th3fr33man/jendrix/Ressources/ShémasTableau/IMG_20121205_175228.jpg

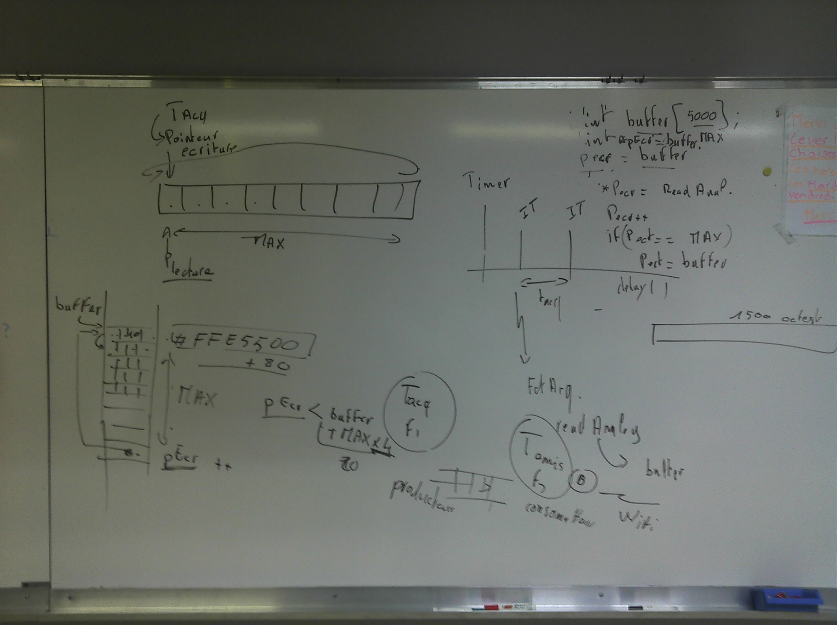
Ressources/ShémasTableau/IMG_20121205_175228.jpg
