th3fr33man/jendrix/README.md

# Readme du projet Jendrix.
# Par Romain "th3fr33man" et Florian  "floub".
# Projet à base de carte Arduino Due et application Android.
