th3fr33man/jendrix/Rapports/dossier_flo.odt

CECI EST UN TITRE

+logo ou schéma

# IDEE / PRESENTATION

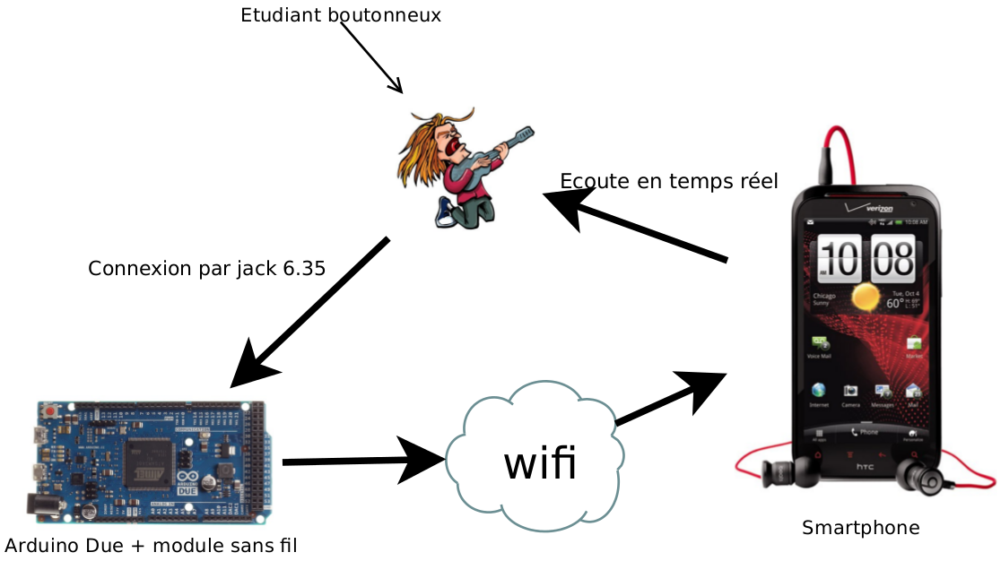
[picture p4: figure]

Illustration 1: schéma conceptuel du système Jendrix

Le principe !

Le principe du système Jendrix est simple : permettre à un musicien pour un prix minimum et un minimum d'installation d'écouter sur le casque de son Smartphone , par l’intermédiaire d'une application téléchargée, le son produit par sa guitare électrique.

Pour ce faire nous nous proposons de développer un petit « device » compact, fixé sur la guitare au moyen d'un clip sur la bandoulière par exemple et raccordé à la prise jack de la guitare, l'énergie électrique du système étant fournie par une batterie ou des piles rechargeables embarquées.

Enfin, Le smartphone et le petit device doivent pouvoir communiquer l'un avec l'autre par l'intermédaire d'une connexion WIFI établie automatiquement au démarrage de l'application Smartphone et basée d'un coté sur un module WIFI embarqué par le device et de l'autre le module WIFI du SMARTPHONE.

La cible commerciale ?

Un étudiant (boutonneux ou non), à petit budget, doit pourvoir jouer et enregistrer « Foxy Lady » en silence, le téléphone dans la poche, le casque sur les oreilles tout en sautant partout dans ses 9m² .

JENDRIX : LE « AIR GUITARE » REINVENTE

# CAHIER DES CHARGES

## Analyse du besoin

Le système doit offrir certaines fonctionnalités à l'utilisateur, comme capter le son d'un instrument, le restituer, l'enregistrer,...etc. Ceci est résumé dans les diagrammes UML suivant.

### Diagramme de déploiement

Le diagramme de déploiement suivant représente les différents éléments du système et les types de connexion entre eux.

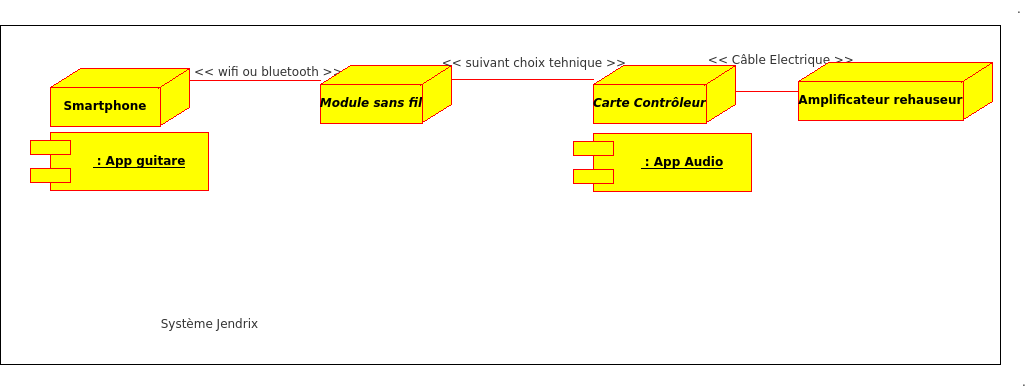
[picture p5: figure]

Illustration 2: Diagramme de déploiement du système Jendrix

### Diagramme de cas d'utilisation.

Les diagrammes suivant résument les fonctions principales que le système doit offrir à l'utilisateur.

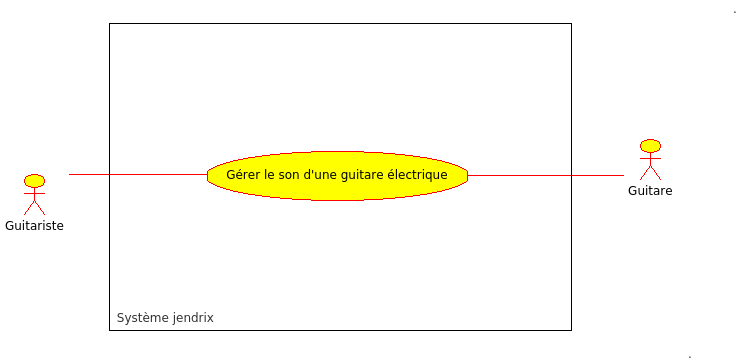
[picture p6: figure]

Illustration 3: Système général

Le module audio doit être capable de capturer, le signal electrique audio émis par la guitare, de le transmettre via une liaison sans-fil.

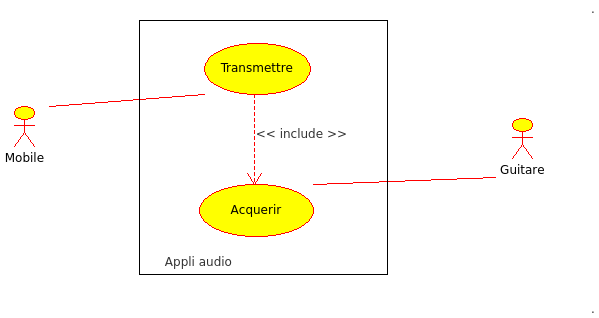
[picture p7: figure]

Illustration 4: Côté capture du son

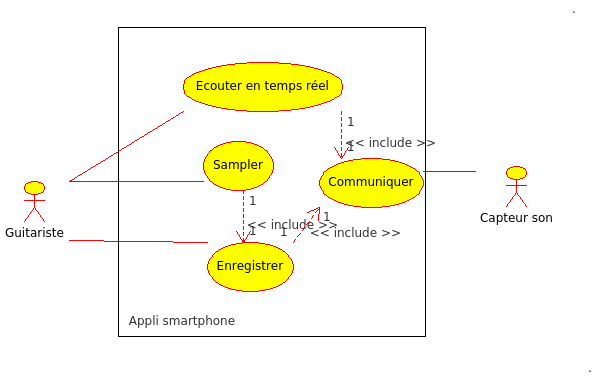
[picture p8: figure]

Illustration 5: Côté restitution du son

L'application sur smartphone, doit elle être capable d'une part de récupérer les données qui sont envoyées par le module audio en sans-fil, et d'autre part doit permettre au guitariste d'écouter le son de son instrument en temps réel(pas de latence).

D'autres fonctions secondaires doivent permettre au musicien de s'enregistrer et même de créer des boucles à diffuser tout en continuant de jouer.

### Diagrammes de séquences.

Les diagrammes suivant résument le fonctionnement des différentes parties du système.

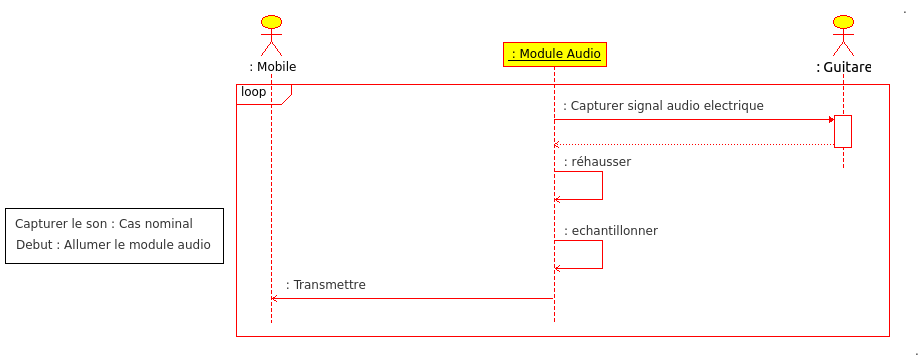
[picture p9: figure]

Illustration 6: Module audio raccordé à la guitare

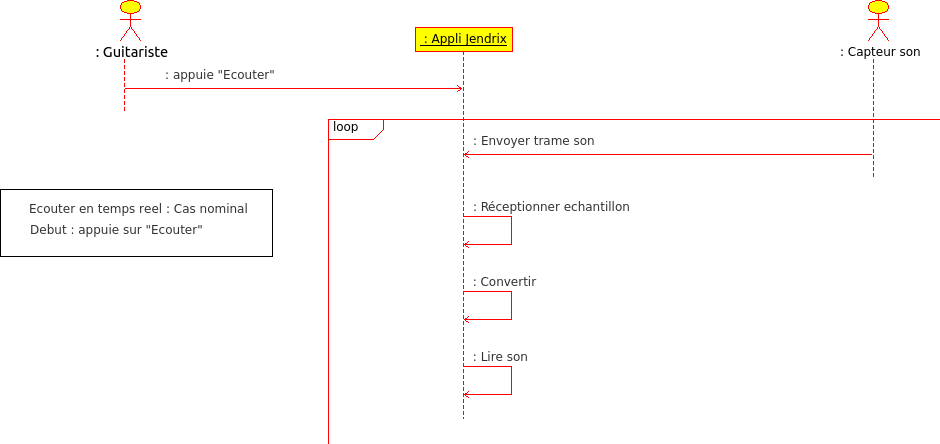
[picture p10: figure]

Illustration 7: Application sur smartphone

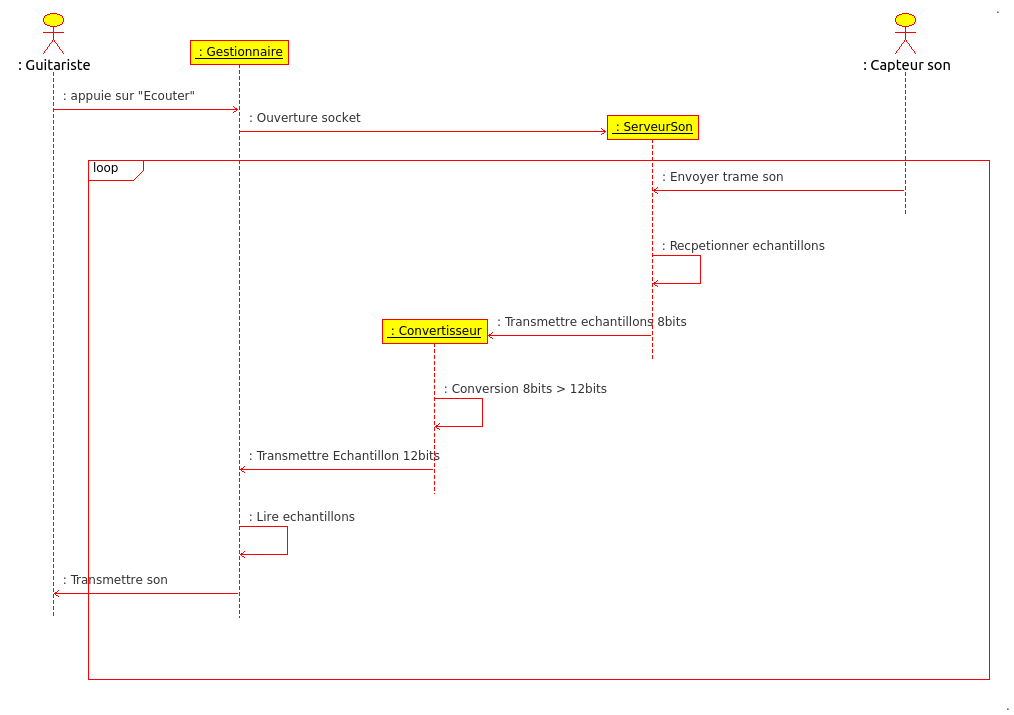
[picture p11: figure]

Illustration 8: Zoom sur l'application smartphone

## CONTRAINTES INITIALES et CHOIX TECHNIQUES

### Diffusion du son

Pour l'application de diffusion du son sur smartphone, les 2 choix principaux étant Android et IOS, voici un petit résumé des caractéristiques des 2 plate formes.

| Caractéristiques

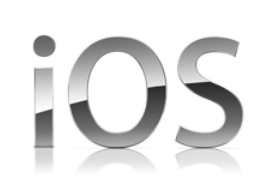
[picture p12: figure]

| - Langage : objective C, dérivé de C et C++. - Compte développeur 100$. - Outil de développement riche et documentation fourni. - Programmation exclusivement sur Mac - Contact des ingénieurs Apple possible avec l'achat de tickets. - Environnement fermé. - Délai de publication sur l'Apple Store de 10 jours. - Matériel limité à l'Iphone/Ipad.

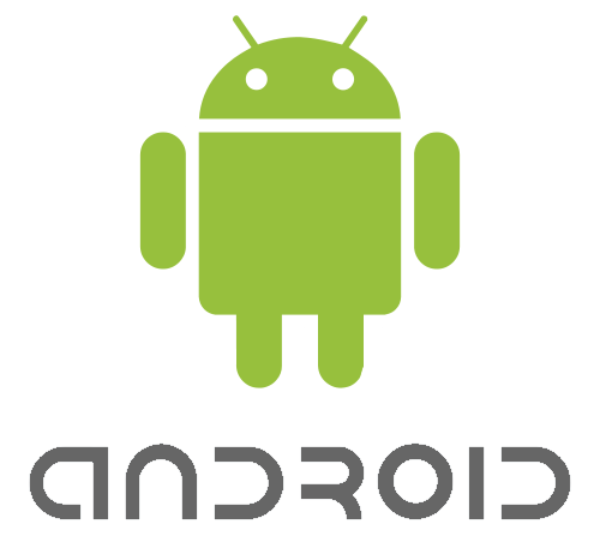
[picture p13: figure]

| - Langage:Java + Xml. - Compte développeur 25$. - Outil de développement plus brouillon. - Programmation sur toutes plate formes - Communauté active. - Environnement ouvert. -Délai de publication sur le play Store de 1 jour. - Multi plate formes.

→ Notre choix s'est tourné vers Android pour son environnement ouvert et sa possibilité de programmation sur diverses OS (Windows, Linux ou Mac).

Plusieurs type de contraintes sont à prendre en compte dans le développement du projet :

### Les instruments de musique

Le choix à été fait de développer l'ensemble du système sur la base des caractéristiques de la guitare « marque de la guitare «

TODO : A FINIR

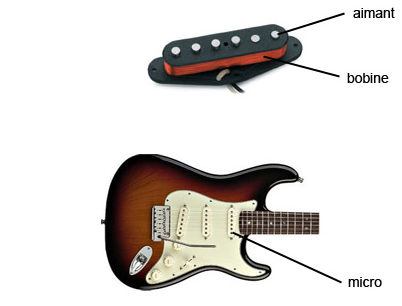
[picture p14: figure]

### Les micros de la guitare

Cette guitare est équipée de micros «classiques» destinés à transformer les vibrations de cordes induites par le jeu du musicien en un signal électrique. Pour ce faire, la guitare possède des micros, 1 par cordes, micros constitués d'un aimant entouré d'une bobine, les deux éléments étant fixes.

La génération d'un signal électrique se fait en conséquence par le déplacement des cordes ( qui doivent être métalliques) placées à proximité d'une extrémité de l'aimant du micro. Le champ magnétique de l'aimant central aimante partiellement la corde et lors du déplacement de la corde devant l'aimant, le champ magnétique de ce dernier varie. Si on considère le micro entier (ensemble aimant/bobine), déplacer la corde devant le micro revient à déplacer l'aimant devant la bobine ce qui génère un courant électrique dans la bobine en application du principe de l'induction magnétique.

Les micros étant placés en parallèle l'ensemble des vibrations de cordes sont additionnés et reflètent les vibrations des cordes.

→ En conséquence, il est nécessaire de dimensionner le système Jendrix en fonction des caractéristiques des micros de l'instrument.

### Les caractéristiques du signal électrique obtenu :

L'amplitude du signal électrique généré est directement proportionnelle à l'amplitude du déplacement des cordes et varie en permanence dans le temps.

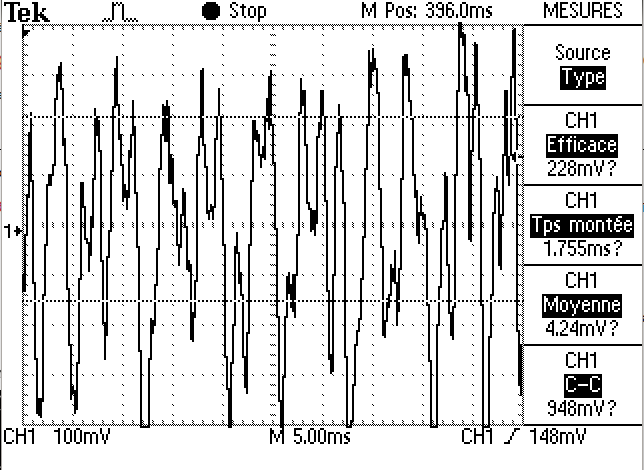
[picture p15: figure]

Le spectre d'une guitare électrique

De même, le signal n'est pas sinusoïdal mais est plutôt une somme de plusieurs sinusoïdes décomposables en séries de Fourier. Les ondes additionnées à l'onde principale ou harmoniques sont directement liées au « timbre » de la guitare

→ Il est donc absolument nécessaire de conserver l'ensemble des harmoniques au cours du transport du signal pour sa réémission la plus intègre possible.

### L'oreille humaine et le son issu de la guitare

Le spectre de son à transmettre correspond à celui de l'oreille humaine et doit être prise en compte dans le cas des problématiques d'échantillonnage et de repliement des spectres susceptibles de générer des problèmes de parasites et de perturbation de la qualité du son.

Spectre produit par une guitare électrique rock « Vintage »

→ Le spectre représenté sur le graphe ( fréquences en abscisse et dB en ordonnée) correspond à peu près à celui de l'oreille humaine c'est à dire borné entre 20Hz pour les sons les plus graves à 20000Hz pour les sons les plus aigus. Or en application du théorème de SHANNON, il est nécessaire d'échantillonner le son à des fréquences au moins 2 fois supérieures à la fréquence maximum du spectre, soit 40000 Hz.

### La latence

L'objectif du projet est de permettre en temps réel l'écouté déportée de son issu d'instrument de musique par un musicien et ce en temps réel. Or au delà de 10 ms, le musicien est susceptible d'entendre un décalage entre son geste et le son produit ce qui peut perturber énormément son jeu.

→ Le décalage d'un bout à l'autre de la chaîne du système JENDRIX c'est à dire entre l’action du guitariste et le moment où le son de son action arrive dans du son doit donc être inférieure ou égale à 10 ms.

### La numérisation du son

L'oreille perçoit les sons jusqu'à environ 20000 Hz, donc sans filtre il est nécessaire de travailler à une fréquence supérieure à 40000 Hz afin d'éviter les phénomènes de repliement du spectre sans filtre

Qualité du son | Taux d'échantillonnage | Résolution / codage | Nombre de voies
Téléphonique | 8000 Hz | 8 bit | 1 voie
Radio | 22000 Hz | 16 bit | 1 voie
Radio numérique | 32000 Hz | 16 bit | 2 voies
CD et audio pro | 44100 Hz | 16 bits | 2 voies
DVD, Enregistreurs numériques multipistes pro et | 48000 Hz | 24 bit | 2 voies

Nota : Plus la résolution est élevée et meilleure est la dynamique ( écart entre le son le plus faible et le plus fort qu'il est possible de reproduire)

### La bande passante nécessaire pour transmettre le son

exemple : calcul de la bande passante théorique pour un son de qualité CD

Fréquence échantillonnage (Hz) * Résolution (bit) * Nombre de voies (1 ou 2)

=> 44100*16*2 = 1,41 Mbit/s

Nota : La bande passante réellement nécessaire est supérieure à la bande passante théorique afin de tenir compte des pertes de données liées aux émetteurs récepteurs ainsi que des atténuations de signal liées à l'environnement dans lequel doit se faire la transmission. En effet , la distance entre les parties émétrices et réceptrices, la présence en périphérie ou sur le chemin des ondes de matériaux perturbateurs électromagnétiques tels que les métaux ou l'eau, ainsi que la forme de ces perturbateurs engendrent un niveau de perte très difficile à calculer.

### La transmission sans fil du son

Point clef dans le projet, nous avons pris le parti pour le traiter de n'utiliser que des protocoles et technologies associées présentes massivement dans les SmartPhone, le principe du projet Jendrix étant de mettre l'ensemble de la technologie dans un « device » porté par l'instrument à sonoriser, le Smartphone devant rester en l'état, simplement équipé d'un logiciel à télécharger.

Trois technologies/protocoles ont été identifiées :

Nota : plusieurs technologies RF sont aujourd'hui très utilisées dans le cadre de transmission du son ou de la vidéo dans le cadre professionnel en particulier et permettent de réaliser des connections wireless éprouvées. Toutefois, ces technologies et leurs protocoles propriétaires nécessiteraient le développement de deux modules, un

→ La technologie sélectionnée est après analyse le WIFI TODO

### Le « device »

portable

alimenté par batteries

### Le téléphone

la variété des téPC

La connectivité

# CADRAGE / METHODOLOGIE

## Méthodologie et outils

### Organisation

Bien que non obligatoire, adopter une méthode de travail était indispensable pour donner toute les chances au projet d'aboutir. Il existe plusieurs méthode de travail voici une rapide comparaison entre une méthode ancienne mais toujours utilisée dite de cycle en V et une méthode plus récente dite SCRUM basé sur le concept de la méthode AGILE.

Le cycle en V :

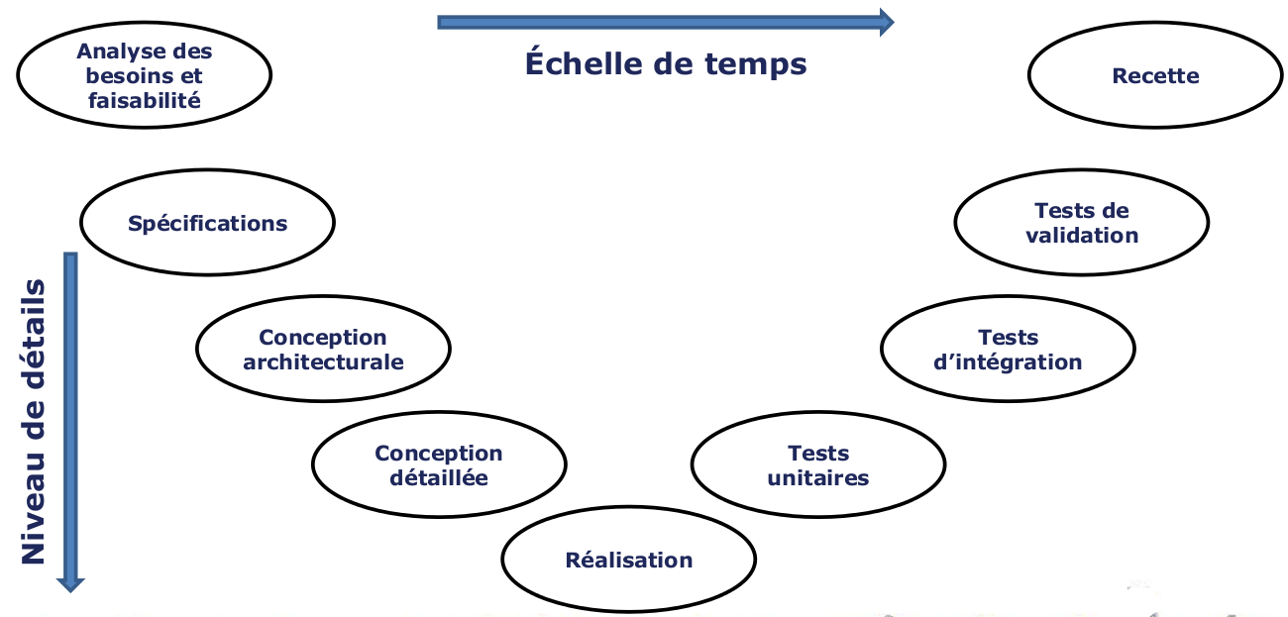
[picture p16: figure]

Illustration 9: Les phases du cycle en V

La méthode SCRUM(AGILE) :

Mieux vaut avoir un produit incomplet tout de suite, qu'un produit complet trop tard.

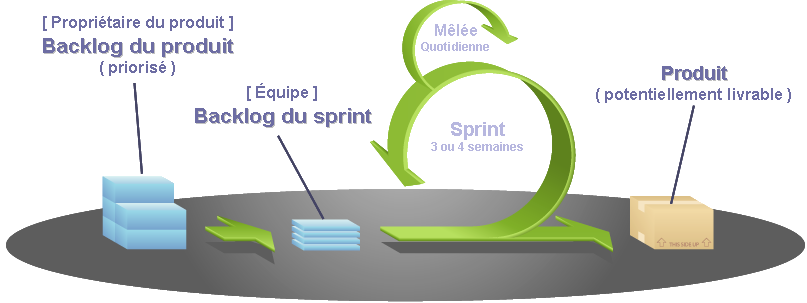
[picture p17: figure]

Illustration 10: principe de SCRUM

Le principe est de découper en plusieurs objectifs plus petit pour arriver à l'objectif final. D'une manière général, la méthode est basée sur des cycles de développement court, et une forte cohésion d'équipe. Implique également de livrer régulièrement (à chaque fin de sprint) un produit au client même si celui-ci est incomplet.

Le projet doit être découpé en de multiples tâches, qui sont toutes référencées dans le backlog du produit, ce dernier peut évoluer dans le temps. Les backlogs des sprints sont composés d'une partie des tâches du backlog du produit en revanche une fois le sprint établis, il ne peut plus être modifié.

Lien vers le manifeste Agile en français: http://www.agilemanifesto.org/iso/fr/

Comparaison Cycle en V/SCRUM :

| Avantages | Inconvénients
Cycle en V | - Facile à mettre en œuvre. | - Plus le projet est gros, plus le cycle est long, les besoins peuvent changer. - Peu évolutif dans le temps. - A chaque phase, un nouveau. document. Parfois des incohérences. - Manque de souplesse. - Date souvent difficile à tenir. - Mise au point lourde. - Risque d'obtenir un produit différent du besoin.
SCRUM | - Travail en équipe. - Cycle court et évolutif. - Consultation du client régulière. - Cohésion, communication accrue, on sait ce que les autres font. - Permet de connaître précisément le temps de réalisation d'un projet. | - Plus difficile à mettre en œuvre, nécessite de la discipline et de la cohésion dans l'équipe. - Peut être interpréter comme du flicage ou de la réunionite aiguë. - Niveau de découpage des tâches parfois difficile à trouver.

SCRUM dans le projet :

La méthode SCRUM a été choisie pour mener à bien ce projet, car elle s'adaptait bien au rythme des semaines de projet tuteuré, elle nous a permis de fixer des objectifs de réalisation à court terme et de manière cyclique. Nous permettant de rajouter une ou plusieurs fonctionnalités à chaque fin de sprint. Comme le montre l'exemple de backlog de sprint ci-après.

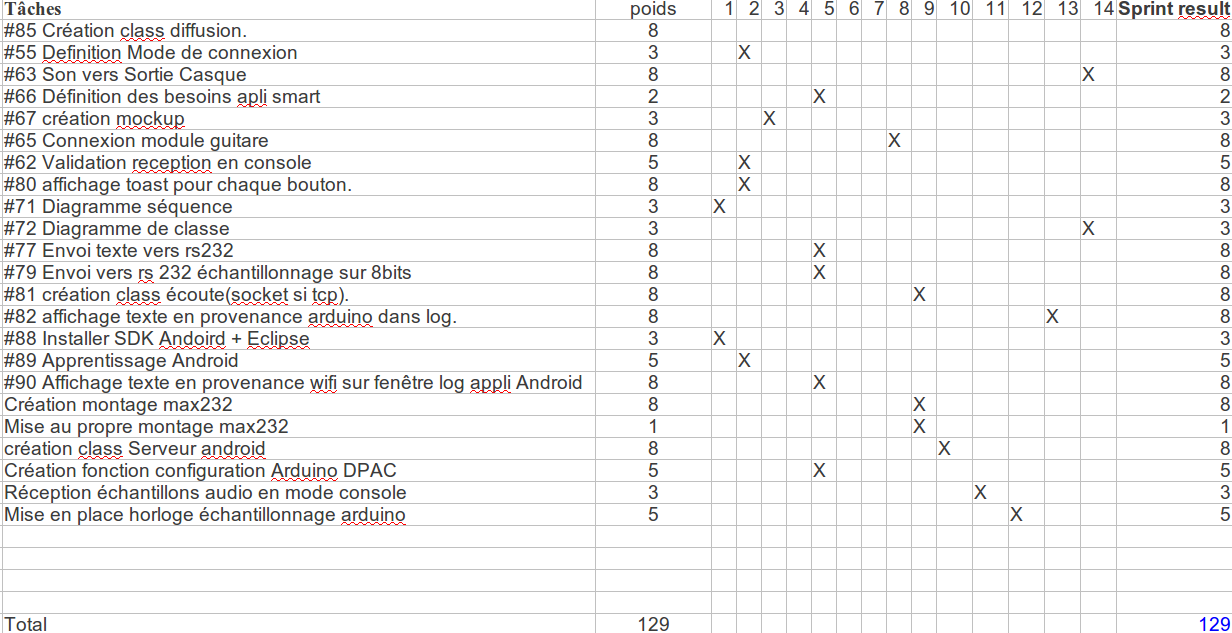
[picture p18: figure]

Illustration 11: Backlog du sprint 01/2013

L'exemple de backlog comprend une liste de tâches qui ont été menées à bien lors d'un sprint, il comprend plusieurs colonnes :

- le nom des tâches
- le poids des tâches, c'est à dire la difficulté d'une tâche, de 1 à 8, 1 pour facile et 8 pour inconnu.
- Les colonnes représentant les jours de réalisation.
- Une colonne résultat. Cette dernière permet de savoir ce que l'équipe est capable de faire en 1 sprint, et permet d'adapter les sprints suivant pour qu'il reste dans le domaine du réalisable.

### Gestion de version

Les outils de gestion de version sont destinés à simplifier le suivi, l'évolution des versions lors du développement d'application. Et simplifie également le travail en équipe, car permet à des programmeurs de travailler sur les mêmes sources du programme. De plus ils s'intègrent parfaitement à la méthode AGILE.

Les 2 outils les plus connus sont Git et Subversion.

| Avantages | Inconvénients

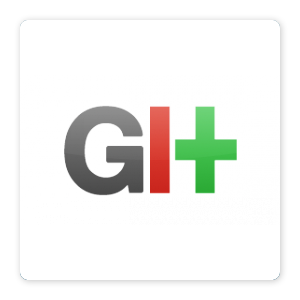
[picture p19: figure]

Git | - Avantages identiques à SVN. - Rapide - Serveur central non obligatoire mais possible - Serveur de dépôt gratuit GitHub. - Compatible avec Subversion | - Prise en main complexe

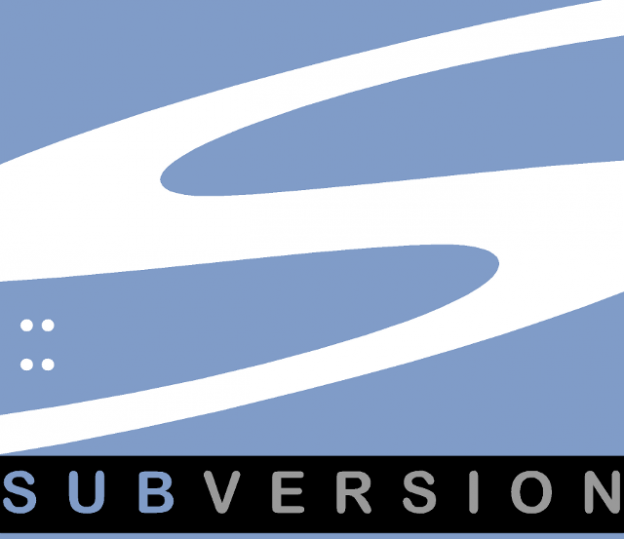
[picture p20: figure]

SVN | - Permet à plusieurs développeurs de travailler sur les mêmes sources. - Version incrémenté automatiquement. - Possibilité de revenir à des versions antérieurs en cas de problèmes. | - Nécessite un serveur donc plus couteux.

D'une manière plus général les 2 solutions auraient été possible, mais notre choix s'est tourné vers Git en raison de son offre de dépôt gratuit avec GitHub.


Un dépôt a donc été créé et se trouve à l'adresse :

https://github.com/th3fr33man/jendrix

GitHub en plus de présenter les outils fourni par git offre également des outils de gestion de projet permettant de diviser/découper le projet en de multiples tâches(« milestone ») comportant plusieurs sous-tâches(« issue ») s'accordant également avec la méthode Agile.

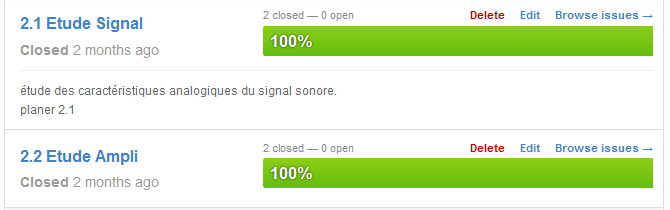
[picture p21: figure]

Illustration 12: Exemple de vue d'avancement de milestone

### Linux

Nous avons fait le choix de travailler sur Linux pour plusieurs raisons :

- Volonté de maîtriser davantage le langage
- Utilisation de « GIT» via la console relativement simple et dans la continuité des cours reçus en début d'année
- Existence de l'IDE Arduino DUE pour linux équivalent à celui des autres OS
- Possibilité d'utiliser des logiciel gratuits pour les applications de bureautique
- Présence d'outils de gestion des connexions série (minicom) ou de simulation de serveurs tel que Netwag

### Outils de développement

Présentation rapide de Eclipse et ide Arduino avec explication pourquoi on les a choisis.

## Planning Prévisionnel

Planning initial réalisé S45

Après un travail préalable destiné à identifier l’ensemble des tâches à réaliser nous avons répartis la charge de travail sur les périodes de projet tuteuré en prenant en compte les points suivants :

- L'objectif est d'arriver le plus vite possible à transmettre du son d'un bout à l'autre de la chaîne puis dans un second temps à améliorer les éléments de traitement du son au sortir de la guitare et les fonctions du logiciel implanté dans le téléphone
- la progression du développement doit se faire de la guitare vers le smartphone en « cercle concentriques », en tachant à la fin de chaque période d'obtenir un résultat mesurable et testable.
- pas de répartition du travail au préalable, cette répartition devant être effectuée en fonction des montées en compétences de chacun et de ses aspirations personnelles.
- Le listing exhaustif des taches à effectuer « fct avance » a été inclu dans le planning prévisionnel afin de permettre le réajustement de la charge.

PHOTO planning 1

Planning réajusté

Nous avons repris dans un second temps en Semaine 48 le planning initial afin de le prter sur un logiciel de gestion de planning, le logiciel Planner sur Linux , permettant de gérer plus facilement l'ajout de tâche et de détailler davantage les taches en les liant les unes aux autres . (cf ANNEXE XX pour le détail complet du calendrier prévisionnel)

PHOTO Planning 2

AJOUT DES COMENTAIRES POUR JUSTIFIER LE CHANGEMENT DE METHODO VERS LA METHODE AGILE

## Listes des tâches globales – backlog produit

# ETAPES DE REALISATION

## Semaine 1 : Veille technologique et définition du cahier des charges

Listing applis et matériels existant sur le thème (Tache #'4)

Nous avons démarré le projet sans aucun matériel et avec des connaissances uniquement scolaires et parcellaires sur les technologies impliquées dans le projet (les cours sur le WIFI par exemples n'avaient pas encore été donnés). Notre première phase de travail après les taches liées au cahier des charge(#35), au cadrage (#2) ou à GITHUB(#28) a donc consisté à collecter le maximum d'informations possibles autour des problématiques que nous supposions liées au projet et avec pour objectif premier approvisionner dès que possible le matériel nécessaire à la fabrication d'un prototype.

Sur la base de l'idée de départ nous avons établis une liste de sujets à explorer afin de permettre un travail en commun et ainsi faciliter l'appropriation du sujet par les deux participants aux projet. Pour ce faire nous avons travaillé sur l'addon « ZOTERO » pour Mozilla, un outil de gestion de partage de données Web et créé un compte commun accessible en ligne.

CF PHOTOS EN ANNEXE 1

Recherche des modules adaptables (Tache #5)

Nos travaux de veille technologique nous ont permis d'identifier deux acteurs principaux du prototypage rapide de fonctions électroniques Arduino et Fez Panda et un matériel pouvant potentiellement répondre à nos besoins : la Rasberry pi.

Nous avons réalisé un travail sur les gammes proposées pour retenir trois solutions susceptibles de permettre le traitement du son et le transfert du son numérisé vers un média « Wireless » :

Nous avons fait le choix de prendre une carte Arduino Due en prenant en compte en compte en priorité son caractère Audio ( fonction pré-implémentées et hardware)

Tache #29 Identifier les divers modules sans fil existants

Comme évoqué dans le chapitre NOM CHAPITRE, nous avons fait le choix du protocole WIFI et avons identifié trois principaux matériels :

→ le module WIFLY a été sélectionné après comparaison des matériels les plus répendus en prenant comme critères principaux :

- Usage : le descriptif technique fait état de la compatibilité du matériel pour des applications Audio
- Compatibilité et facilité de mise en œuvre du matériel
- Disponibilité du matériel

Tache #11 Définition des besoins matériels

Le micro-controleur : Arduino DUE

Après analyse des données recueillies nous avons fait le choix de la carte Arduino Due en prenant comme arguments principaux :

- Le caractère « audio » de la carte , développée spécifiquement pour ce type d'applications
- L'existence de fonctions préimplémentées dans le langage Arduino telles que
- Le langage d'implémentation relativement accessible contrairement au C# de la Fez panda par exemple
- La compatibilité avec des shield spécialisés pemettant l'ajout des fonctions Wireless ou CAN haute qualité

Bilan d 'étape

Ce premier sprint nous a permis de collecter beaucoup d'informations sur les systèmes de transfert de son existants et de choisir le micro contrôleur et la carte Wi-fi associée. De même, nous avons pu caractériser le signal électrique en sortie de guitare et trouver une solution technique nous permettant de simuler le son d'une guitare afin de faciliter nos essais à venir .

Au sortir de ces travaux

Beaucoup de recherches et mise en place de la méthodologie

## Semaine 2 : Etude de l’architecture système et prise en main du matériel

Les taches #14 Achat /acquisition et #12 ont été réalisées en dehors des périodes de projet tuteurés afin de permettre une acquisition des matériels le plus tôt possible. Au moment de l'achat de la carte Arduino celle est sortie depuis 1 mois et aucun site n'est en mesure de livre le matériel.

Taches #36 et 37 Analyse du signal électrique audio en sortie de guitare électrique

Le montage

C'est la première étude qui a été effectuée. Il était essentiel avant de faire des choix technique et matériel, de savoir quel était le type de son qu'il fallait traiter. Les mesures ont été réalisée avec un oscilloscope et une guitare électrique raccordés par un câble jack 6.35mm.

Nous avons étudié le signal électrique produit par la guitare afin d'évaluer la compatibilité de ce signal avec les entrées DAC de l'Arduino DUE dont la résolution par défaut est de 10bit et la plage de voltage acceptée de 0 à 3,3 v et 6mA maximum.

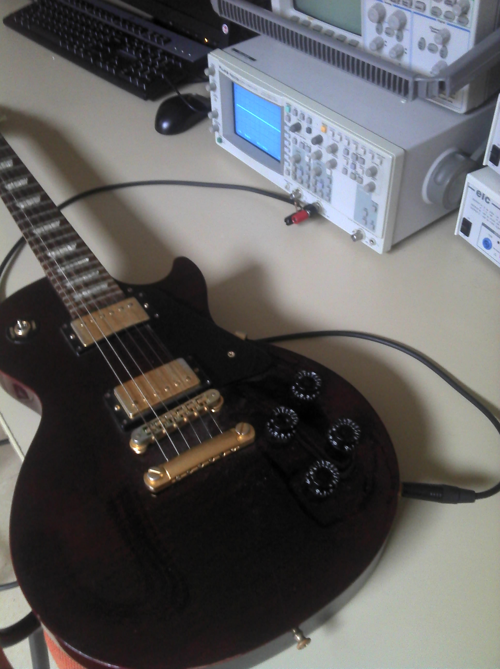
[picture p22: figure]

Captures effectuées à l'aide de l'oscilloscope

Illustration 13: capture oscillo - jeu classique

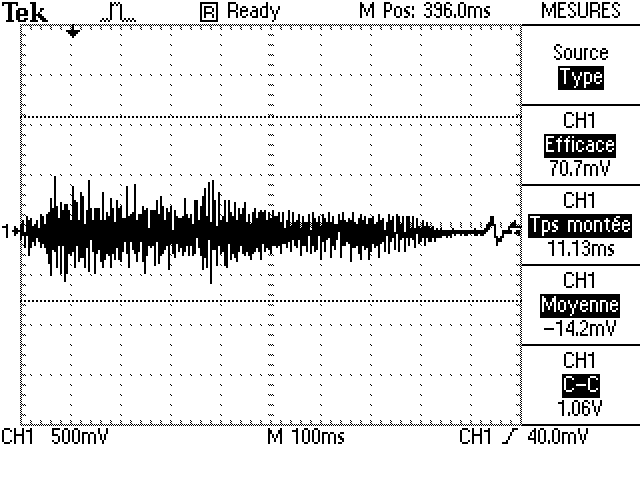
[picture p23: figure]

Cette première capture montre que les tensions en sortie du jack 6.35mm raccordé à la guitare sont relativement faible. Oscillant autour de 0 V, en crête à crête en jouant normalement on dépasse à peine les 1V.

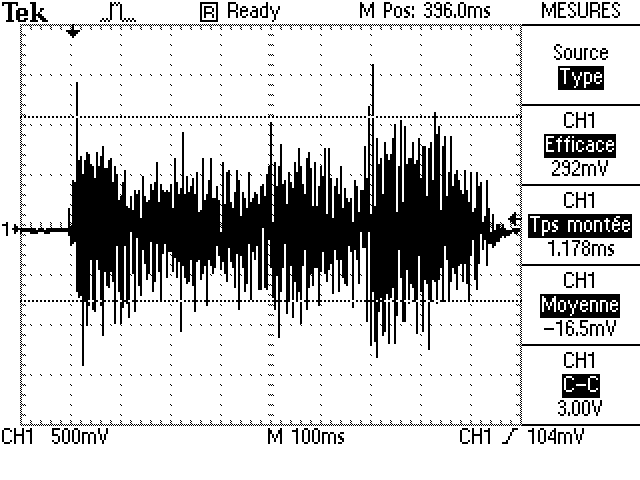
[picture p24: figure]

Illustration 14: Capture oscillo – jeu plus fort

Lorsque l'on joue de la guitare avec des attaques plus soutenues, la tension en crête à crête atteint environ 3V.

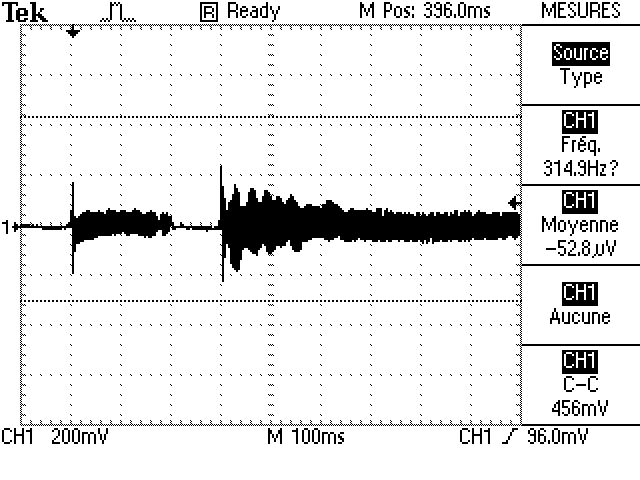
[picture p25: figure]

Illustration 15: Capture oscillo - solo de guitare

En revanche lorsque l'on joue un solo de guitare sans forcer les notes, la tension C-C ne dépasse pas 0.5V.

Le montage suivant a été réalisé ..

Dans un second temps et afin de faciliter les essais nous avons recherché une source audio compacte susceptible de remplacer la guitare le temps de nos travaux. Nous avons ainsi pu caractériser un lecteur MP3 ( SAMSUNG ) et avons réalisé des mesures afin de vérifier que les amplitudes et tensions étaient similaires.

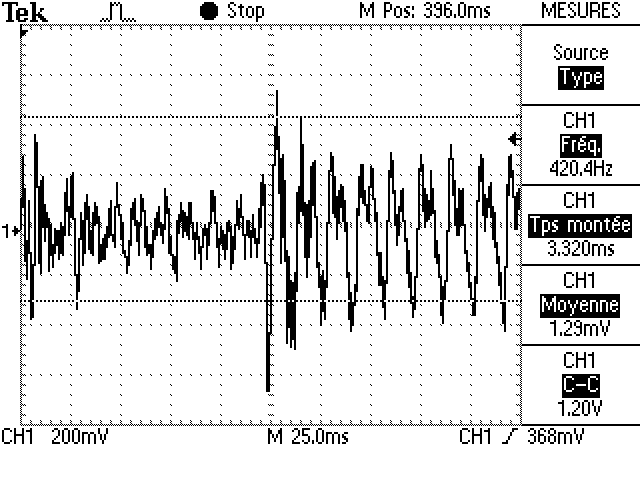
[picture p26: figure]
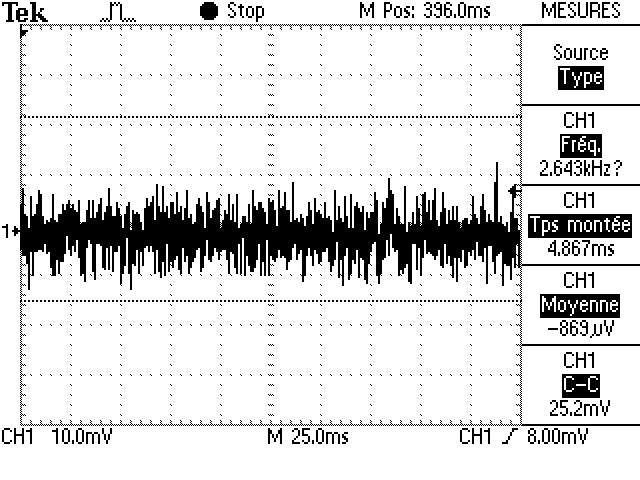
[picture p27: figure]

Les relevés montrent que le signal électrique évolue dans les mêmes proportions que le son issu de la guitare

Conception Ampli et Simulation Circuit (Tache #38)

Les travaux menés lors de la semaine précédente ont permis de caractériser le signal électrique sortant de la guitare à savoir :

- Signal de moyenne 0 V
- Amplitude maximum de 3 V crête à crête en jeu de guitare « fort »
- Amplitude maximum de 1 V en jeu de guitare « modéré »
- Le courant produit n'est pas caractérisé mais nous savons qu'un découplage avec l'entréeArduino est nécessaire afin de protéger la carte ( Val max de A)

Nous avons étudié un montage permettant de redresser le signal d'une moyenne de 0 v à 1,65v de sortes à être centré dans la plage de tension acceptable par le DAC

La plage de tension relevée lors des essais révèle une plage de plus ou moins 2 volts maximum est suffisante pour récupérer l'intégralité du signal. Après un travail théorique nous avons abouti au montage suivant :

La réduction de la plage de tension en entrée est assuré par un pont diviseur de tension

L'ampli a pour fonction de borner le signal, de le découpler le courant issu de la guitare du courant en entrée de carte et de redresser dans une plage de 0 à 3,3 volts ( VCC, tension de issue de la carte Arduino)

formule

L' amplification du

signal a volontairement été limitée afin de

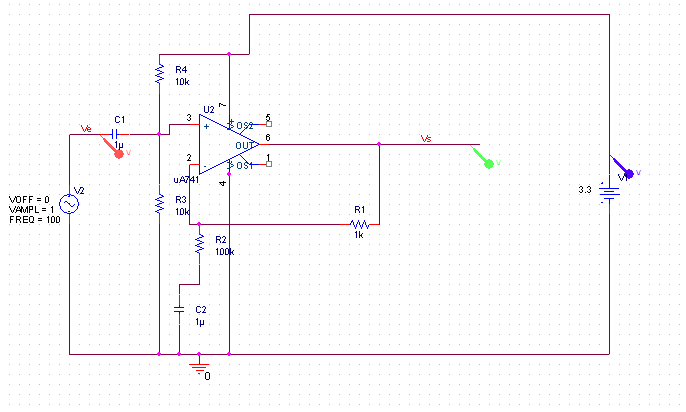
[picture p28: figure]
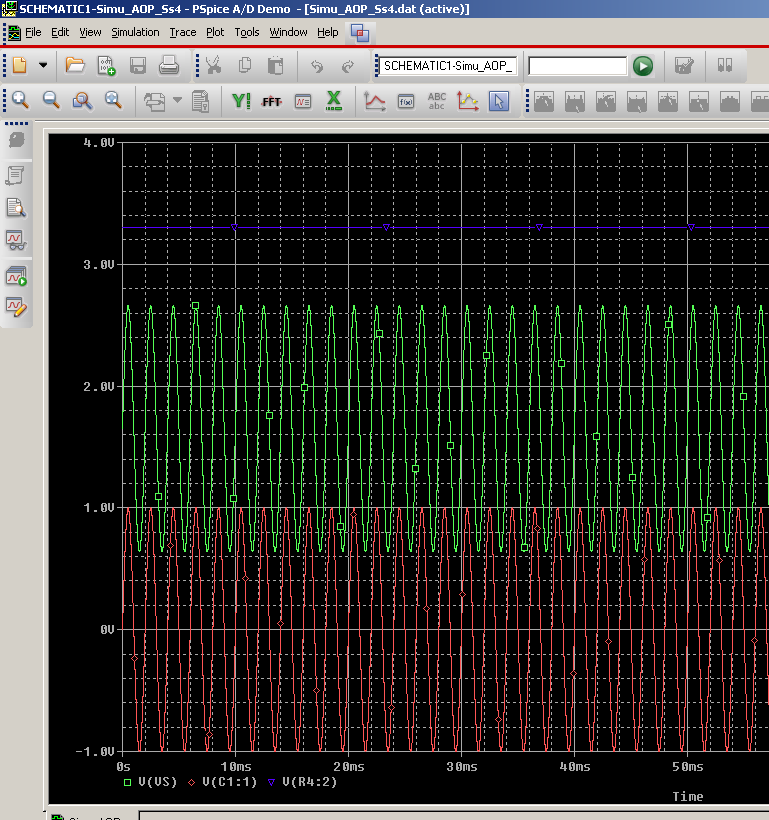
[picture p29: figure]

Tache #40 Approvisionnement matériel, #41 assemblage et #42 simulation du du prototype n°1

L'approvisionnement du matériel réalisé nous avons assemblé le prototype d'amplificateur et réalisé des relevés afin de vérifier l'adéquation entre la théorie et la pratique.

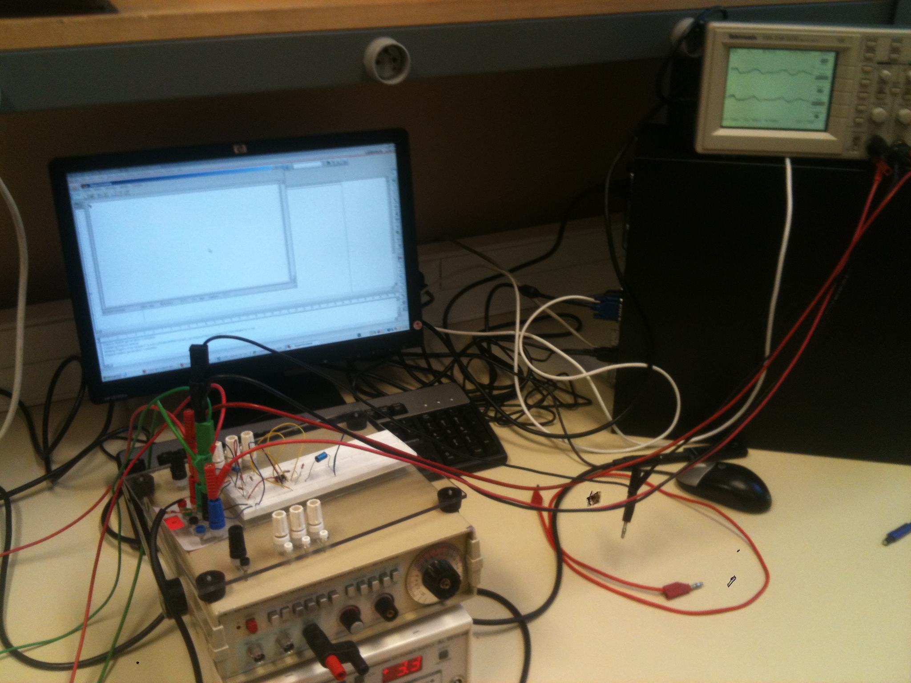
[picture p30: figure]

Les relevés réalisés à l'oscilloscope ont permis de valider les hypothèses prise et de passer à l'étape suivante

Taches #53 Brochage Shield WIFI et #54 Soudures Shield WIFI

Dès réception du matériel, nous avons réalisé l'assemblage de sorte à permettre son assemblage sur le microcontroleur Arduino. Un test de continuité a été effectué sur les soudures afin de garantir leur intégrité.

Bilan de la semaine 2 :

La prise en main des outils de simulation Orcad Pspice s'est avéré un peu délicat mais fidèle aux essais

notre amplificateur n'étant pas rail to rail, l'amplitude de notre signal est limitée par les bornes ( nous perdons quasiment 1 Volt sur les 3,3 Volts disponibles)ce qui d'un point de vue résolution enlève près d'un tiers de la résolution ( sur 8 bits, 255 valeurs c'est environ 80 valeurs de perdues)

Nous avons également mis en place un moyen de tester la communication sans fil grâce à un logiciel sous Linux qui s'appelle NC, permettant de se familiariser avec l'envoi de trames en filaire et en WIFI.

## Semaine 3 : Mise en œuvre des fonctions « Audio » de l'Arduino et prise en main du module WIFLY

### Mise en œuvre Arduino CAN-CNA sur HP

Un premier montage destiné à tester la capacité de la carte Arduino Due à transmettre du son a été réalisé. Afin de prendre en main la carte et les fonctions implémentées, le montage suivant a été réalisé :

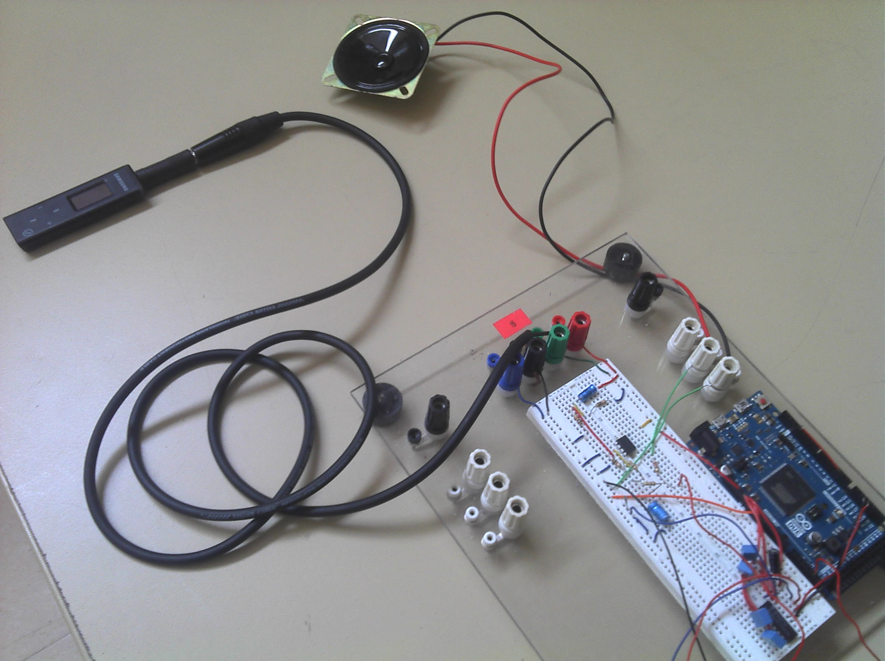
[picture p31: figure]

Programme Arduino

Mise en œuvre des fonctions Audio pré-implémentées dans Arduino de sortes à récupérer le son issu de l'ampli et à le sortir sous forme analogique sur un Haut parleur branché sur la PIN DAC1 :

/* Premier programme pour vérifier

le son capté sur entrée analogique

et sortir le son sur un hp branché sur DAC1*/

int sensorValue1 = 0; // variable pour récupérer les valeurs Echantillons

int hpPin = DAC1; // Sortie audio

const int sonInPin = A0; // Entré audio

// fonction de paramétrage qui n'est exécutée qu'une fois au démarrage

void setup() {

// pinmode paramétrage de la PIN A0 en entrée analogique

pinMode(sonInPin, INPUT);

}

// La fonction Loop () est une boucle infinie

void loop() {

//Lecture écriture sur 16 bits

analogReadResolution(16);

analogWriteResolution(16);

//Capture tension en entrée et conversion en int sur 16bits

sensorValue1 = analogRead(sonInPin);

//Ecriture vers la pin DAC1(CNA) des valeurs récupérées sur l'entrée analogique

analogWrite(hpPin, sensorValue1);

}

Taches #75 et #78 apprentissage du nouveau module WIFLY

La prise en compte du module Wifly s'est avérée relativement complexe. Nous avons travaillé sur la transmission des données entre l'arduino et le shield en privilégiant

- travail sur SPI / serial : pas possible
- Connection via TELNET / wifi pour paramétrage ( maintien sur Jumper 9)

Bilan du Semaine

Le module WIFLY au cours de nos essais à brusquement cessé de fonctionner nous conduisant à rechercher un nouveau matériel. Nous avons récupéré auprès de nos tuteurs un module WIFI DPAC nous permettant de continuer nos travaux mais nécessitant une nouvelle prise en main du matériel alors que beaucoup de temps avait été consommé.

## Semaine 4 : Mise en œuvre des fonction « Audio » de l'Arduino, prise en main du module WIFI DPAC et programmation Anrdoid

## Dpac : Prise en main et communication via le port série

Le module DPAC possède les caractéristiques suivantes : Tableau

Les différences entre ce module et le module WIFLY initialement sélectionné sont importantes du point de vue de notre projet :

- on ne peut le connecter que via un port série à l'Arduino
- est que liaison port série, débit WIFI faible mais suffisant
- et pas d'UDP ( pas génant )
  En conséquence nous nous trouvons un goulot d'étranglement au niveau de la liaison série )

Essais de connection arduino Dpac en utilisant les ports série préimplémentés ne donnent rien : pas de com possible

Relevés oscilloscope montrent que le signal en sortie

### Max232

Le signal au sortir de la carte arduino est conforme mais au sortir du port série est inversé par rapport à l'attendu

Après étude, nécessité d'implanter un module RS232 en sortie de carte

Adaptation du driver/reciever DS14C232 compatible avec le statandr MAX232 et nécessitant une alimentation de 5v disponible sur la carte Arduino Due et du modules MAXX 232 sur les

Montage

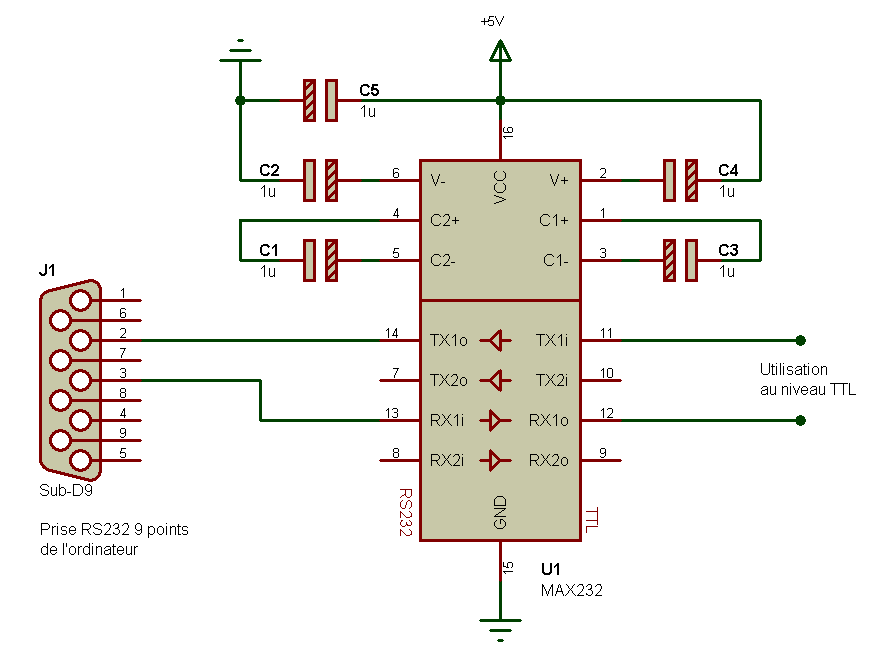
[picture p32: figure]

Photo montage RS 232

Nous avons réalisé le montage sur Breadbord avec les composants de l'atelier et effectué des relevés sur oscilloscope, sur les pins Rx/Tx afin de s'assurer que les trames envoyées correspondaient au relevés attendus à savoir par exemple pour l'envoi de la lettre « A »

Envoi de la trame « A »

PHOTO oscillo

trame attendue en binaire

sur l'oscilloscope

Condition d'essai :

paramétrage de la liaison série

exemple : envoi d'

### Échantillonnage du son Arduino

Première étape :

recherche des fonctions préimplémentées !

Fonctions audio non portées sur Arduino DUE :

Nécessité de réaliser l'échantillonnage en dur

Seconde étape :

Travail sur échantillonnage

sheduler yield

attach interrupt

recherche sur timers arduino due

infos sur Uno mais processeur spécifique

Travail sur récup timer forum arduino

Mélange avec interrupt

recherche pin de sortie sur l'interrupt et programme en print LN ok

OK 87 µs à 91 µs max

Test Oscillo = 145 µs de période ce qui est normal considérant que l'on est en change

fréquence x2

Mais PB le MM de l'interrupteur s'arrete au bout d'un temps

Le signal pris sur l'oscilloscope

### Bout de code

TODO:Mettre un bout de code

## Semaine 4 : Transmission sans fil

### Module WiFLY

Assemblage

Branchement

Etude de la documentation et

paramétrage de la carte par l'intermédiaire de la connectique P9

Connexion à la page web du module pour le paramétrage

### Module DPAC

Etude de la doc

séquence de démarrage rédigée afin de permettre la mise

Assemblage de la prise RS232

essais de commandes via minicom

Procédure de configuration du module Dpac

# Fichier manuel utilisé Airborne WLN DataBook RevE.pdf p 87 et 88

# (page 54 pour le mode UDP)

# Commande a utiliser dans le cli

se connecter grace a minicom en 9600 8n1

p74 AirbornWLNDataBook.pdf

Régler le niveau d'authentification (L1, L2, L3...)

auth dpac dpac //règle le niveau à L5

wl-ssid [nom du ssid] // donner le nom du ssid

wl-type p // en mode ad-hoc

wl-dhcp 1 // on active le dhcp

wl-chan 1 // on force l'utilisation du canal 1

commit // Sauvegarde

restart // redémarrage

# la connexion doit à partir de la s'établir entre le module et le périphérique wifi distant

# une fois la connexion établie on peut se connecter en utilisant l'interface web en regardant au

# préalable l'adresse ip attribuée avec la commande wl-info

# ensuite il suffit de taper cette adresse dans le navigateur. user oem et mdp oem

(dpac mdp dpac marche aussi) // pas de différence notable identifiée

# message pour moi : lors du test de connexion avec mon portable pbm de reconnexion wifi, il faut désactiver le réseau filaire, se connecter avec le sans fil et réactiver le réseau filaire.

# pour tester la connexion entre le module et le pc

lancer netwag

- Solution 1: sélectionner le programme 89

- Solution 2 // utiliser uniquement netwag afin de récupérer le N° de programme et la commande

sélectionner server tcp

sélectionner le port

lancer la commande correspondante avec netwox

exemple: netwox 89 --src-port 2000 lance un server tcp qui écoute sur le port 2000

sur le module en commande, taper

wl-tcp-ip [@ip]

wl-tcp-port[port]

pass # pour passer en mode transfert de donné

taper du texte il doit s'afficher dans la console ou est lancé le serveur tcp

## Semaine 5 : Diffusion du son avec un smartphone sous Android

### Diagramme de classe de l'application Android

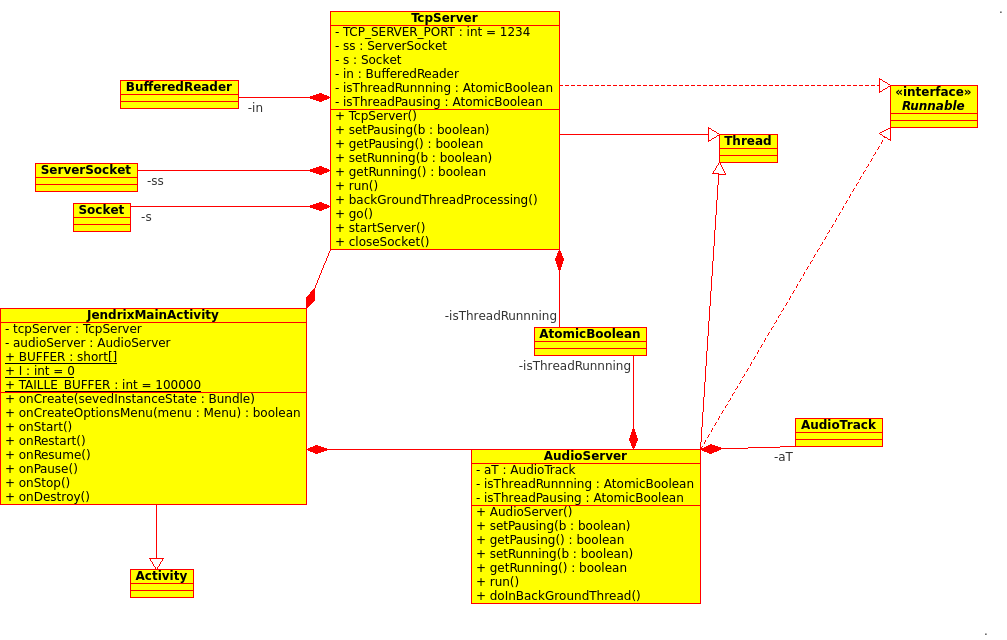
[picture p33: figure]

### IHM basique.

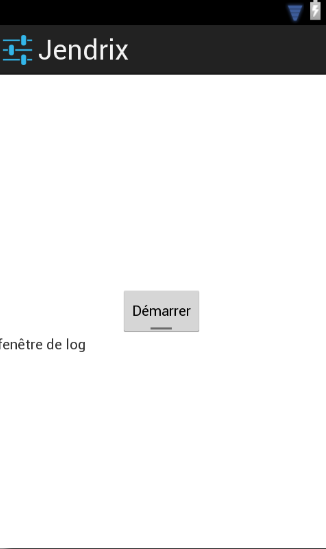
[picture p34: figure]

Illustration 16: IHM

Bouton switch pour activer l'écoute

Zone d'affichage d'informations pour l'utilisateur

Implémentation du bouton switch pour activer la diffusion du son :

public void onCheckedChanged(CompoundButton buttonView,

boolean isChecked) {

if (isChecked) {

if (audioServer.getRunning()==false) {

audioServer.setPausing(false);

audioServer.setRunning(true);

audioServer.start();

} else

audioServer.setPausing(false);

} else

audioServer.setPausing(true);

}

Fichier xml pour l'implémentation graphique :

<RelativeLayout xmlns:android="http://schemas.android.com/apk/res/android"

xmlns:tools="http://schemas.android.com/tools"

android:layout_width="match_parent"

android:layout_height="match_parent"

tools:context=".JendrixMainActivity" >

<!-- la fenêtre de log -->

<TextView

android:id="@+id/log"

android:layout_width="wrap_content"

android:layout_height="wrap_content"

android:layout_alignParentBottom="true"

android:layout_alignParentLeft="true"

android:layout_alignParentRight="true"

android:layout_below="@+id/onoff"

android:text="@string/log" />

<!-- le bouton switch -->

<ToggleButton

android:id="@+id/onoff"

android:layout_width="wrap_content"

android:layout_height="wrap_content"

android:layout_centerHorizontal="true"

android:layout_centerVertical="true"

android:textOn="@string/buttonon"

android:textOff="@string/buttonoff" />

</RelativeLayout>

L'interface est très simpliste, la première étape du projet étant avant tout d'envoyer du son.

### Thread producteur/consommateur

Tout d'abord, pourquoi mettre en place des threads, ne pourrait-on pas tout exécuter dans l'application principale ? Le problème est que l'application se bloquerait, car la méthode read() servant à lire les données entrantes par la socket est bloquante. Or sous Android si une application se bloque plus de 5s, elle est automatiquement tuée par l'ordonnanceur.

L'utilisation de Thread permet de lancer des tâches longues en arrière plan tout en laissant la main à l'utilisateur, ce qui est essentiel pour notre application. Comme vu sur le diagramme de classe, la classe principale est composée de 2 classes Thread, l'une est la classe TcpServer.java, qui joue le rôle de producteur, et utilise notamment la méthode read(), qui récupère tout les échantillons envoyé par le module audio et les stockes dans un Buffer, un tableau composé d'un type de donnée, dans notre cas, des bytes ou des shorts. La classe AudioServer joue elle le rôle de consommateur, et va donc lire les cases du tableau pour les traiter et les envoyer vers le hardware audio du téléphone.

La nécessite des Threads s'explique donc par le fait que les 2 tâches doivent s’effectuer en parallèle.

1

2

La clase TcpServer écrit les échantillons dans les cases du Buffer. Le Thread TcpServer écrit les échantillons dans les cases du Buffer. Le Thread AudioServer lit les échantillons stockés dans les cases du Buffer.

Buffer

Case 1 | Case 2 | … | … | … | … | … | … | Case n | Case n+1

Sens d'écriture/lecture

L'activité principale doit quand à elle pouvoir recevoir des demandes de l'utilisateur, comme couper le son, enregistrer le son, ...etc.

### Le producteur : La class TcpServer.java.

Cette classe permet donc de créer la connexion avec le module Wifi raccordé avec l'Arduino. Elle hérite de la classe Thread, et implémente l'interface Runnable, ce qui lui permet de ne pas bloquer l'application principale.

La classe implémentant l'interface Runnable, elle doit implémenter la méthode run(). Dans lequel est se trouve une méthode backGroundThreadProcessing() contenant une boucle while s'éxécutant tant que l'application n'est pas arrêté.

Bout de code de la classe :

public void run() {

// TODO Auto-generated method stub

Log.i("TcpServer", "run");

backGroundThreadProcessing();

}

Et le while :

while (isThreadRunnning.get()) {

if (isThreadPausing.get()) {

Thread.sleep(2000);

Log.i("tcpServer", " en pause ");

} else {

in.ready();

// ////////////////////////////

// pour l'échantillonnage 8bits

// ////////////////////////////

JendrixMainActivity.BUFFER[JendrixMainActivity.I]=(short)(in.read()<<8);

Log.i("TcpServer", ""+ JendrixMainActivity.BUFFER[JendrixMainActivity.I]);

// case suivante du tableau et buffer circulaire

JendrixMainActivity.I++;

if (JendrixMainActivity.I == JendrixMainActivity.TAILLE_BUFFER) {

JendrixMainActivity.I = 0;

Log.i("TcpServer", "buffer a 10000 "); //contrôl dans le logcat

}

}

}

Tout ce qui est lu en entrée du socket est stocké dans un tableau faisant office de buffer. A noté que pour lire le buffer (de la classe détaillé ci-après) il faut qu'il y soit stocké des types « short » ou « byte », or la méthode read() retourne elle des types « int », il faut donc faire un « cast ».

### Le consommateur : La class AudioServer.java

Cette classe hérite également de la classe Thread et implémente l'interface Runnable à l'instar de la classe TcpServer. Elle est chargé de lire le Buffer qui aura été rempli. La particularité de cette classe est qu'elle utilise une librairie Android spécifique à l'audio et à la diffusion de son vers le hardware du téléphone ou de la tablette. La librairie AudioTrack.

Elle permet de créer un objet de type audiotrack avec plusieurs paramètres comme le montre l'extrait de code ci-après.

aT = new AudioTrack(AudioManager.STREAM_MUSIC, 11520,

AudioFormat.CHANNEL_OUT_MONO,

AudioFormat.ENCODING_PCM_16BIT,

AudioTrack.getMinBufferSize(11520,

AudioFormat.CHANNEL_OUT_MONO,

AudioFormat.ENCODING_PCM_16BIT),

AudioTrack.MODE_STREAM);

On créé l'objet qui va nous permettre d'écrire sur le hardware audio. Il prend plusieurs paramètres.

Bien que relativement explicite voici quelques explications de ces paramètres:

→ AudioManager.STREAM_MUSIC indique que ce sera du streaming, c'est à dire de la musique qui sera renouvelée sans cesse.

→ 11520 indique la fréquence de lecture, elle doit être cohérente avec la vitesse d'échantillonnage effectué par le module audio.

→ AudioFormat.CHANNEL_OUT_MONO et AudioFormat.ENCODING_PCM_16BIT indiquent respectivement que le son sera mono et échantillonné sur 16bits.

→ AudioTrack.getMinBufferSize() cette méthode retourne la taille de buffer qui doit être utilisée au minimum. Si le Buffer utilisé est trop petit cela ne fonctionnera pas.

Le code suivant montre la boucle qui est effectuée tant que le Thread est lancé.

while (isThreadRunnning.get()) {

if (isThreadPausing.get()) {

aT.stop();

Thread.sleep(2000);

} else {

i = aT.write(JendrixMainActivity.BUFFER, 0,

JendrixMainActivity.TAILLE_BUFFER);

}

}

La méthode write() va écrire le contenu de tout le Buffer sur le hardware audio.

TODO : A Finir

# BILAN

## Avancement et problèmes rencontrés

Le diagramme joint à suivre permet de

L'avancement

Après un démarrage difficile lié à la méconnaissance des sujets à aborder à un temps d'appropriation des savoirs nous avons pris la mesure des travaux à réaliser ce qui nous a permis lors du sprint 5 de faire aboutir

L'organisation

Nous avons expérimenté plusieurs méthodologies au départ du projet et en fonction des cours reçus en cours d'année. Nous avons ainsi démarré le projet en Comment s'organiser organisationnel.

Des connaissances limités.

Problème de temps aux vues de l'ampleur du projet.

D'un point de vue Technique Etat du système :

Ampli :

Arduino :

Dpac

Téléphone

PB de temps entre deux étapes !

## Restant à faire

Présenter les différentes tâches effectuées /t aux tâches restantes prévues.

(capture excel ou github ?)

## Évolutions / améliorations

Amélioration du son, mise en place d'un étage de filtrage du bruit (passe bas 20KHz) , 16bits min + 44100.

Limitation RS232 changement de transmission entre arduino et module wifi(SPI?)

Création d'une carte personnalisée afin de permettre d'avoir un montage compact , les liaisons électriques améliorées et fiables

Envisager solution alternative avec rasberry par exemple.

Amélioration de l'appli Android(fonction enregistrement, boucle, effets,..., stabilité,...)

Rajout de périphériques supplémentaires(pédale pour activer les effets,...)

# REMERCIEMENTS

Nous tenons à remercier nos tuteurs, Olivier COMMENGE et
