th3fr33man/jendrix/CahierDesCharges/Cdc_Jendrix_projetSeicom.odt

# Présentation du projet

## Origine du projet

Qui n'a jamais rêvé de jouer comme Jimmy Hendrix, mais malheureusement dans la chambre universitaire impossible de brancher son ampli guitare sans déranger les voisins ?

## Concept général.

Le but du projet est de permettre la transmission du son provenant d'un instrument de musique type guitare électrique, vers un smartphone type Android à l'aide d'un module sans fil raccordé à la guitare par une prise jack 6.35mm.

Exemple d'utilisation : Un étudiant désire jouer de son instrument de musique préféré, mais ne peut pas car ses voisins sont dans des appartements adjacents, les cloisons sont en carton pâte. La solution ? Utiliser le système jendrix !

On branche le module sans fil sur l'instrument de musique de type guitare électrique et l'application sur smartphone fait le reste. Il suffit ensuite de brancher son casque audio. Plus de problème de voisinage.

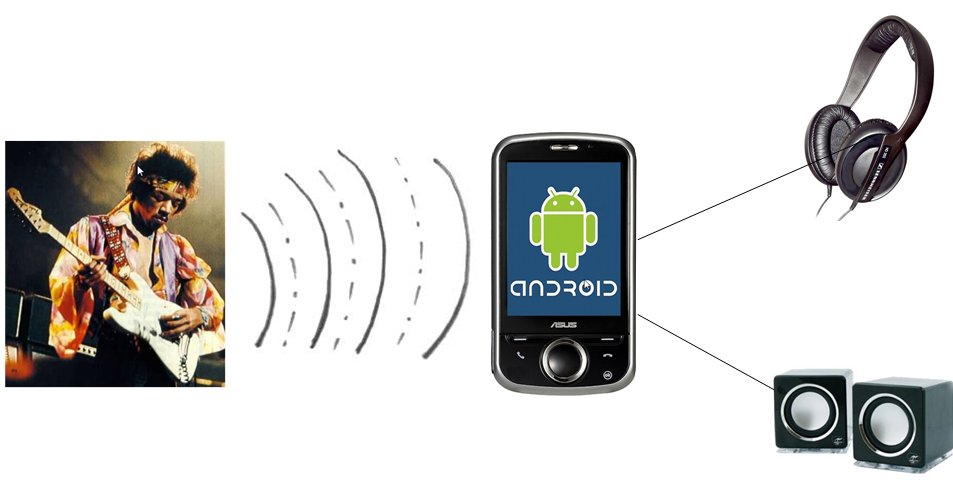
[picture p35: figure]

### Présentation d'un ampli guitare.

Les amplificateurs pour guitare électrique existe en de nombreux modèles. Ils sont pour la plupart encombrant et ne proposent pas tous une sortie casque. Et n'ont que des fonctions basiques de transmission du son, avec un option pour activer le son saturée, la possibilité de régler les graves, les médiums, ou les aïgus.

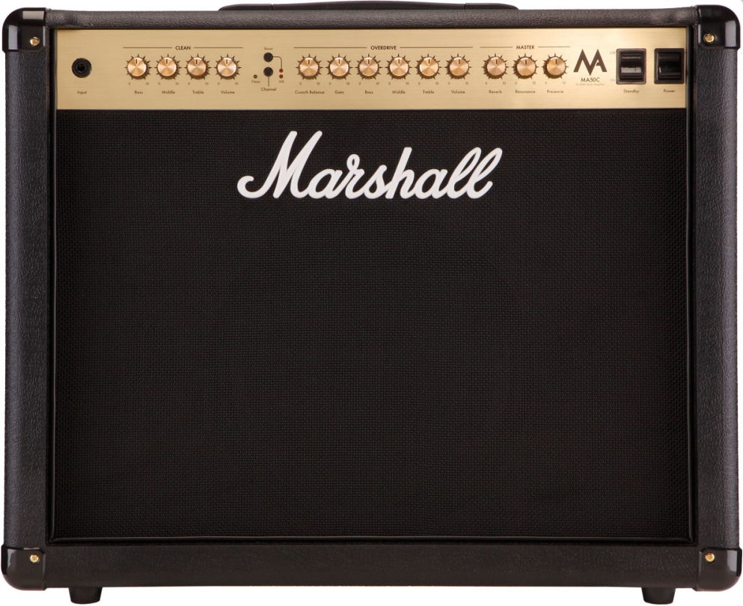
[picture p36: figure]

Illustration 1: Amplificateur classique de guitare

### Présentation d'une guitare.

Il existe 2 types de guitare, les guitares électriques, et les guitares électroaccoustiques. Les premières sont dotées de micros dits passifs sont si capte les vibrations des cordes de la guitare et les transmettent à l'état brute et nécessite un ampli pour pouvoir être audible.

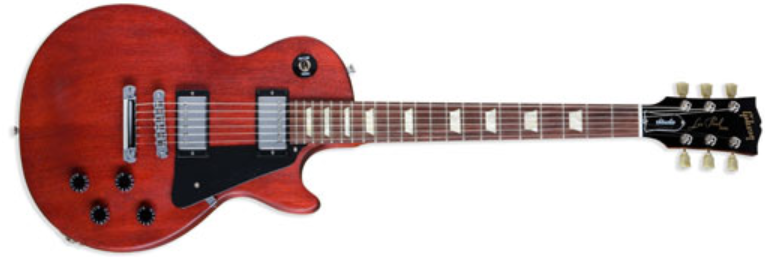
[picture p37: figure]

Illustration 2: Guitare electrique

Les secondes sont des guitares disposant d'une caisse de résonnance et sont doté d'un micro dit actif qui amplifie le signal capté par le micro de la guitare. Ces micro nécéssite une alimentation externe qui est en générale une pile 9V.

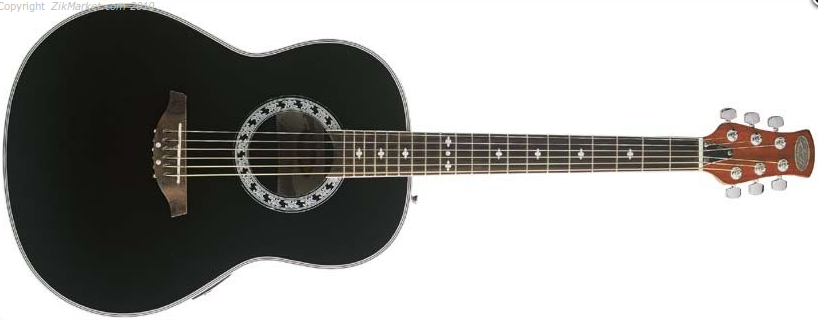
[picture p38: figure]

Illustration 3: Guitare électro accoustique

### Présentation du module + smartphone.

Le module sera constitué d'une carte contrôleur de type Arduino. La nouvelle version DUE est conçu pour le traitement du son et devrait être adapté au projet. Une étude technique permettra de valider ce choix.

Pour la liaison sans fil, plusieurs choix sont possibles en Wifi, Bluetooth ou ZigBee. Il faudra donc dans un premier temps analyser les contraintes techniques liées à chacune des liaisons sans fil.

L'application sur smartphone devra être compatible avec un large éventail des périphériques sous Android. La version de l'API 2.1 a été sélectionnée . La aussi une étude des aspects techniques sera effectuée afin de faire le choix le plus adapté.

Caractéristique + datasheet en annexe.

## Niveau d'intégration.

Schéma/synoptique de présentation du système.

Présentation plus approfondis des éléments du système.


Le système repose sur 2 élements une carte Arduino Due et un smartphone.

Le rôle de la carte Arduino est de récupérer le signal provenant de la guitare, de l'échantillonner et d'envoyer ensuite les données à l'aide d'un module additionnel sur le réseau wifi connecté dans un premier temps directement sur le smartphone. Ce dernier aura pour mission de réceptionner le signal et de le diriger vers sa sortie audio, enceinte interne ou casque.

La carte Arduino Due possède les caractéristiques suivantes :

Microcontroleur | AT91SAM3X8E
Tension de travail | 3.3V
Tension d'entrée (recommandé) | 7-12V
Tension d'entrée (limites) | 6-20V
E/S Numériques | 54 (dont 12 avec sortie PWM)
Entrées Analogiques | 12
Sorties Analogiques | 2 (DAC)
Intensité de sortie totale sur toutes les E/S | 130 mA
Courant max Pin 3.3V | 800 mA
Courant max Pin 5V | 800 mA
SRAM | 96 KB (64 + 32 KB)
Vitesse d'Horloge | 84 MHz

Le smartphone utilisé pour la création du projet sera un smartphone motorola defy dont voici les caractéristiques.

Design produit | Classique
Poids en gr | 118
Dimensions | 59 x 107 x 13.4 mm
Système d'exploitation (OS) | Android
Version Système (OS version) | Android 2.3 (modifié)
Mémoire ROM | 2Go

Mémoire RAM | 512 Mo
Slot mémoire externe | MicroSD / MicroSD HC
Taille écran | 3,7 pouces
Résolution écran (pixels) | 480x854
Technologie écran | TFT
Ecran tactile | OUI Capacitif

Mode GSM | 1900 / GPRS / 900 / 1800
EDGE | OUI
UMTS/3G | OUI
HSDPA | OUI
Port Infra-rouge | NON
Wifi | OUI

Bluetooth | STEREO
Connectique | Micro-USB
Logiciel GPS | OUI
Push-To-Talk | OUI
Push Email | OUI

Microphone | Interne
Kit oreillette | OUI
Fonction main-libre | OUI
Appareil photo | OUI
Autofocus | OUI
Résolution appareil photo | 5 megapixels
Flash | OUI
Enregisteur Video | OUI HD 720p
Seconde camera pour visio-conference (3G) | NON
Audio OUT | 3,5mm

Lecteur Video | OUI
Lecteur MP3 | OUI
Tuner TV intégré | NON
Radio FM | NON
Mode Vibreur | OUI
Fonction MMS | OUI
Compatible Java | OUI
WAP | OUI
Accéléromètre | OUI

## Débouché prévu.

Concept Open source ?

Uniquement à l'état de projet pour le moment.

## Solution existante sur le marché.

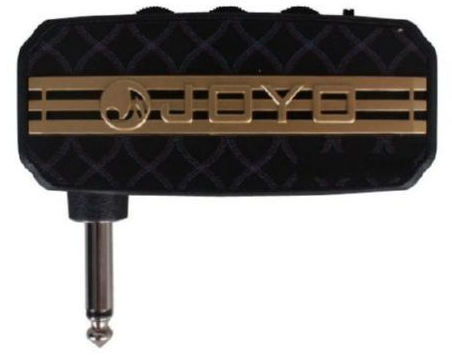
[picture p39: figure]

Pas de solution similaire existante.

[voir sur INPI.fr]

Concept approchant : module branché sur une guitare électrique.

Ampli de poche pour guitare électrique. Permet de raccorder un guitare electrique à l'aide de la prise jack 6.35mm et de le raccorder à un casque audio, ou une chaine hifi.

## Étude déjà effectué.

Aucune, le projet démarre de zéro.

## Suite prévue.

Rajout de nouvelles fonctionnalités : pédale effet, fonction sample, lecteur mp3 intégré.

Rajout d'une possibilité par d'autres type de transmission(par ex : usb)

Rajout d'une possibilité de connexion en airplay avec le smartphone pour diffuser directement le son de la guitare sur des équipements dotés de la fonction.

## Tâches mises en œuvres.

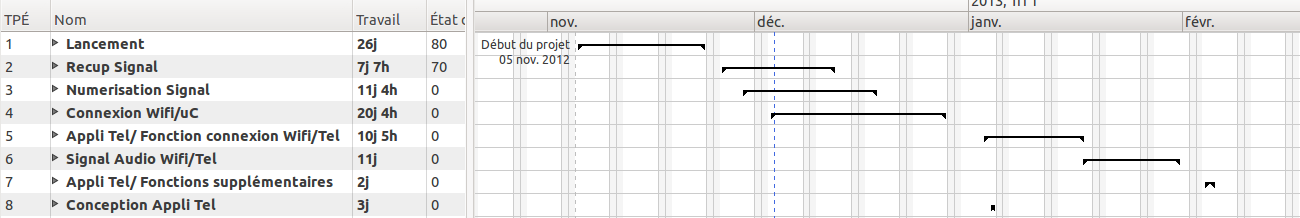
[picture p40: figure]

# Expression du besoin.

## Diagramme de déploiement.

Mettre ici le diagramme.

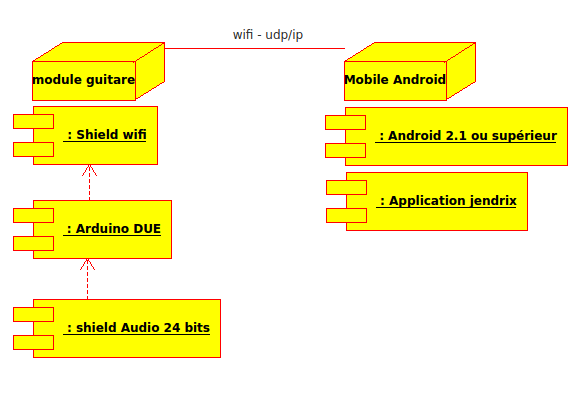
[picture p41: figure]

## Mission du système JendriX.

Mission du module guitare :

- Capter le son en sortie de la guitare.

- Traitement du son en sortie de la guitare.

- Numériser le signal.

- Se connecter en wifi(client) ou accepter les connexion en wifi(point d'accès).

- Envoie des données numérisées en wifi.

Mission de l'application smartphone.

- Interface simple d'utilisation.

- Se connecter ou accepter les connexions en wifi.

- Capter les informations envoyer par le module guitare.

- Traiter les informations et les diffuser vers une sortie au choix de l'utilisateur (dans notre cas la sortie son du téléphone).

- Proposer une indication graphique du signal traité-petit graphique temps réel.

- Disposer d'un bouton pour Activer/Désactiver la diffusion du son.

- etc...

## Environnement du système.

Diagramme d'activité ? ou diagramme de cas d'utilisation ? description des différents éléments(ce qu'ils font).

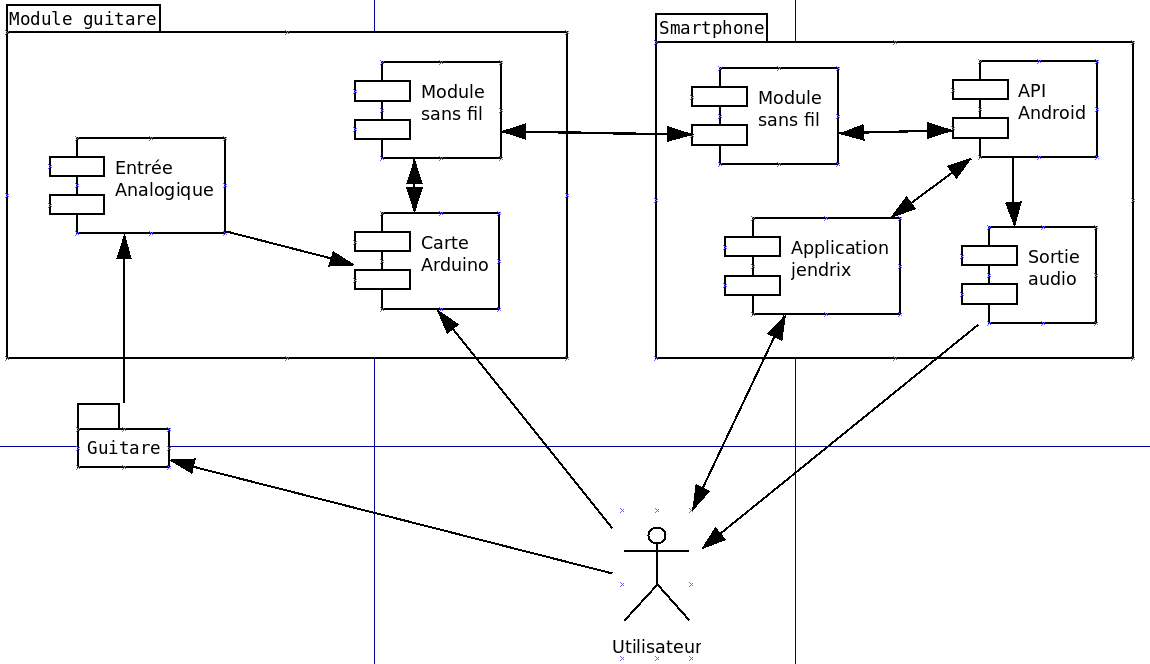
[picture p42: figure]

Description des éléments :

Utilisateur | Personne qui peut interagir avec l'application smartphone et le module guitare.
Guitare | Instrument de musique qui va produire le signal sonore
Entrée analogique | Partie du module réceptionnant un signal sous forme de tension
Carte arduino | Élément centrale du module guitare. Composé d'un processeur ARM 84Mhz.
Module sans fil_module guitare | Module permettant l'envoi et la réception d'informations sur le réseau sans fil.
Module sans fil_smartphone | Module permettant l'envoi et la réception d'informations sur le réseau sans fil.
API Android | Système chargé sur le téléphone, permettant d'accéder aux périphériques de ce dernier.
Application jendrix | Application permettant le traitement du signal réceptionner et de le transférer vers une sortie analogique ou numérique.
Sortie audio | Elément du téléphone permettant une sortie d'un signal sous forme de tension.

Description des Intéractions:

Utilisateur/Guitare | L'utilisateur gratte les cordes de la guitare, La vibration des cordes créée une tension induit par un champ électromagnétique.
Guitare/Entrée analogique | Les tensions aux bornes de la sortie guitare sont transmise à l'entrée analogique du module.
Utilisateur/Carte uContrôleur(arduino) | L'utilisateur démarre le module. Éventuellement peut-être amené à effectuer des petites opération de maintenance, comme des mises à jour du programme sur le contrôleur.
Utilisateur/Application jendrix | L'utilisateur lance l'application et peut configurer cette dernière. Peut choisir de diffuser ou non le son.
Entrée analogique/Carte uContrôleur(arduino) | Les tensions capter sur l'entrée analogique sont traitées par le micro contrôleur et sont échantillonnées(numérisées).
carte uContrôleur(arduino)/Module sans fil | Les données numérisées sont envoyées vers le module sans fil.
Module sans fil/Module sans fil | Les données numérisées sont modulées et transmises sur le réseau sans fil en trame.
Module sans fil/API Android | Les trames sont réceptionnées et démodulées.
API Android/Application jendrix | Les données numériques sont transmises à l'application qui peut afficher un visuel des données reçues et également qui peut indiquée quel est le chemin de sortie des données(sortie audio /bluetooth,...).
API Android/Sortie audio | Suivant les options activées par l'application les données sont convertis N/A et transmise sous forme de tension à la sortie audio.
Sortie audio/Utilisateur | Les tensions produite génère un son audible par l'utilisateur grâce à des enceintes ou un casque.

# Spécifications fonctionnelles du module guitare JendriX.

## Catalogue des acteurs.

Utilisateur | Branche le module à sa guitare et joue de la musique
Guitare | Produits un signal sonore à l'aide des microphones lors des vibrations des cordes de guitares
Module guitare | Échantillonne le signal et le transmet en sans fil.

## Vue principale du module guitare.

Pas d'IHM, seul un bouton pour la mise sous tension.

## Diagramme principal des cas d'utilisations.

Ici diagramme cas utilisation général.

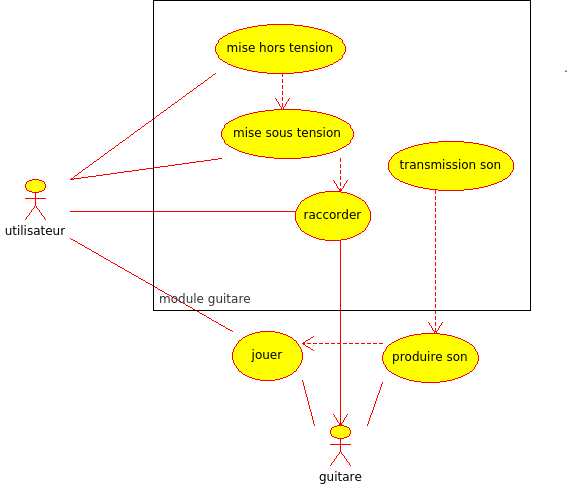
[picture p43: figure]

## Identification des fonctions du module guitare.

# Contrainte de réalisation du module quitare JendriX.

## Caractéristique des fonctions de service.

Ici tableau regroupant, d'une part les fonctions principale du module guitare associé aux contraintes de chacune d'elles.

## Contrainte de l'environnement.

La carte Arduino doit être programmé en langage C simplifié spécifique Arduino.

# Spécifications fonctionnelles de l'application Android.

## Catalogue des acteurs.

Utilisateur | Lance l'application et configure la connexion au module guitare
Application smartphone | Réceptionne les trames wifi envoyées par le module guitare et les convertis pour les diffuser vers sa sortie audio

## Vue principale de l'application Android.

La vue sera réalisé par l'équipe de développement.

## Diagramme principal des cas d'utilisations de l'application Android.

Ici diagramme cas utilisation général.

## Identification des fonctionnalités de l'application Android.

# Contrainte de réalisation de l'application Android JendriX.

## Caractéristique des fonctions de service.

Ici tableau regroupant, d'une part les fonctions principale de l'application Android associé aux contraintes de chacune d'elles.

## Contrainte de l'environnement.

L'application devra être développé en java pour Android sous l'IDE Eclipse en recspectant les règles de codages google.

# Architecture réseau du système JendriX.

Schéma des interconnexions réseaux.

# Backlog du système JendriX.

# Documentation et moyens technologiques.

## Ressource matériel.

## Ressource logiciel.

## Documentation.

# Répartition des tâches.

Tableau de répartition des tâches.

# Exigence qualité à respecter.

## Exigences sur le produit à réaliser.

Ici tableau

## Exigences sur le développement.

Ici tableau

## Exigences sur la documentation à produire.

Ici tableau

## Exigence sur la livraison.

Dead line début mars.

## Exigences sur l'environnement d'exploitation.

??

# Calendrier prévisionnel.

# Annexe.

Mettre ici les docs et datasheet des différents équipements.

Licence pro SEICOM année 2012 - 2013

Romain RACZKA & Florian BERNOUD Cahier des charges projet personnel jendrix
