th3fr33man/jendrix/Rapports/planning JENDRIX.html

# Projet JENDRIX

Société : | LP SEICOM
Responsable : | O.COMMENGE et P.LEGALL
Début : | 5 nov. 2012
Fin : | 5 févr. 2013
Date du rapport : | 12 mars 2013

## Diagramme de Gantt

TPÉ | Nom | Travail
1 | Lancement | 26d
1.1 | Organisation | 5d 2h
1.1.1 | #35 Creation CdC | 2h
1.1.2 | #3 Validation CdC tuteur | 2d
1.1.3 | #2 Cadrage | 1d
1.1.4 | #28 Ajout des premières tâches dans github | 1d
1.1.5 | #1 Renseigner outils de suivi | 1d
1.2 | VTech | 9d
1.2.1 | #30 Identification interface guitare | 5d
1.2.2 | #29 Identifier les diverses modules sans fil | 1d
1.2.3 | #5 Recherche modules adaptables | 1d
1.2.4 | #4 Listing applis et matériels existant sur même theme | 1d
1.2.5 | #31 Etuge de la gestion énergétique | 1d
1.3 | Appro | 11d 6h
1.3.1 | #14 Achat / Acquisition | 10d
1.3.2 | #12 Financement / Validation | 6h
1.3.3 | #11 Définition des besoins matériels | 1d
2 | Recup Signal | 7d 7h
2.1 | Etude Signal | 1d 2h
2.1.1 | #36 Relevé | 1d
2.1.2 | #37 Analyse/Etude Signal | 2h
2.2 | Etude Ampli | 2d 6h
2.2.1 | #38 Conception Ampli (ORcad) | 2d
2.2.2 | #39 Simulation Circuit (Orcad) | 6h
2.3 | Fabrication Proto1 | 4h
2.3.1 | #40 Appro Matos | 2h
2.3.2 | #41 Assemblage | 2h
2.4 | Valid Recup Signal | 1d 3h
2.4.1 | #42 Simu Proto1 | 3h
2.4.2 | #43 Simu Proto2 | 1d
2.5 | Fabrication Proto2 | 2d
2.5.1 | #44 Dessin Typon | 1d
2.5.2 | #45 Appro/Fab C.I | 1d
2.6 | Phase 3
3 | Numerisation Signal | 11d 4h
3.1 | CAN - CNA Ampli1 | 7d 4h
3.1.1 | #46 Conception Logiciel Arduino 12B | 1d
3.1.2 | #47 Fab Ampli1 (amp+Ard+Hp) | 1d
3.1.3 | #48 Simulation Ampli1 | 5d 4h
3.2 | CAN - CNA Ampli2 | 2d
3.2.1 | #49 Fab Ampli2 - Aop RtoR | 1d
3.2.2 | #50 Simulation Ampli2 | 1d
3.3 | CAN - CNA Ampli3 | 2d
3.3.1 | #51 Conception Logiciel Arduino 24B | 1d
3.3.2 | #52 Simulation Ampli3 | 1d
4 | Connexion Wifi/uC | 23d 4h
4.1 | Assemblage Shield Wifi | 2d
4.1.1 | #53 Brochage Shield Wifi | 1d
4.1.2 | #54 Soudures Shield Wifi | 1d
4.2 | Arch Reseau | 4d 4h
4.2.1 | #55 Definition Mode de connexion
4.2.2 | #56 @ip/DHCP
4.2.3 | #57 Definition Port com (>1023)
4.2.4 | #60 Réalisation schéma réseau | 1d 4h
4.2.5 | #73 Utilisation nc - com pc1/pc2 filaire | 1d
4.2.6 | #74 Utilisation nc - com pc1/pc2 wifi | 1d
4.2.7 | #75 Utilisation nc - com moduleWifly/pc | 1d
4.3 | Programmation Arduino DUE | 17d
4.3.1 | #58 Prog Mode Connexion | 12d
4.3.2 | #59 Transmission Data uC/Carte | 4d 7h
5 | Appli Tel/ Fonction connexion Wifi/Tel | 10d 5h
5.1 | Dev IHM de Base | 2d
5.1.1 | #66 Définition des besoins | 1d
5.1.2 | #67 mockup | 1d
5.2 | Dev Module Com/Tester Transmission | 8d 5h
5.2.1 | #64 Création vue config réseau | 3d 5h
5.2.2 | #65 Connexion module guitare | 5d
6 | Signal Audio Wifi/Tel | 11d
6.1 | Validation reception signal Audio | 3d
6.1.1 | #61 WidGet Signal(Graph) | 1d
6.1.2 | #62 Validation reception en console | 2d
6.2 | CNA - CAN Tel | 8d
6.2.1 | #63 Son vers Sortie Casque | 8d
7 | Appli Tel/ Fonctions supplémentaires | 2d
7.1 | Stockage/enregistrement | 1d
7.1.1 | #69 Création vue Stockage/enregistrement | 1d
7.2 | IHM Avancee | 1d
7.2.1 | #68 Définition des besoins des fonctions sup | 1d
8 | Conception Appli Tel | 3d
8.1 | Conception UML | 3d
8.1.1 | #70 Diagramme cas d'utilisation | 1d
8.1.2 | #71 Diagramme séquence/activité | 1d
8.1.3 | #72 Diagramme de classe | 1d
9 | A Definir
10 | A Definir
11 | A Definir
12 | A Definir
13 | A Definir
14 | A Definir

Semaine 45, 2012 | | | | | | | Semaine 46, 2012 | | | | | | | Semaine 47, 2012 | | | | | | | Semaine 48, 2012 | | | | | | | Semaine 49, 2012 | | | | | | | Semaine 50, 2012 | | | | | | | Semaine 51, 2012 | | | | | | | Semaine 52, 2012 | | | | | | | Semaine 1, 2013 | | | | 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
5 | 6 | 7 | 8 | 9 | 10 | 11 | 12 | 13 | 14 | 15 | 16 | 17 | 18 | 19 | 20 | 21 | 22 | 23 | 24 | 25 | 26 | 27 | 28 | 29 | 30 | 1 | 2 | 3 | 4 | 5 | 6 | 7 | 8 | 9 | 10 | 11 | 12 | 13 | 14 | 15 | 16 | 17 | 18 | 19 | 20 | 21 | 22 | 23 | 24 | 25 | 26 | 27 | 28 | 29 | 30 | 31 | 1 | 2 | 3 | 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
RR
RR, FB
RR, FB
RR, FB
RR, FB
RR, FB
◆
RR
FB

## Tâches

TPÉ | Nom | Démarré | Terminé | Travail | État d'avancement | Coût | Assigné à
1 | Lancement | Nov 5 | Nov 23 | 26d
1.1 | Organisation | Nov 5 | Nov 8 | 5d 2h
1.1.1 | #35 Creation CdC | Nov 5 | Nov 5 | 2h | 50%
1.1.2 | #3 Validation CdC tuteur | Nov 5 | Nov 7 | 2d | 0%
1.1.3 | #2 Cadrage | Nov 7 | Nov 8 | 1d | 100%
1.1.4 | #28 Ajout des premières tâches dans github | Nov 5 | Nov 5 | 1d | 100%
1.1.5 | #1 Renseigner outils de suivi | Nov 5 | Nov 5 | 1d | 100%
1.2 | VTech | Nov 5 | Nov 9 | 9d
1.2.1 | #30 Identification interface guitare | Nov 5 | Nov 9 | 5d | 100%
1.2.2 | #29 Identifier les diverses modules sans fil | Nov 5 | Nov 5 | 1d | 100%
1.2.3 | #5 Recherche modules adaptables | Nov 5 | Nov 5 | 1d | 100%
1.2.4 | #4 Listing applis et matériels existant sur même theme | Nov 5 | Nov 5 | 1d | 100%
1.2.5 | #31 Etuge de la gestion énergétique | Nov 5 | Nov 5 | 1d | 0%
1.3 | Appro | Nov 8 | Nov 23 | 11d 6h
1.3.1 | #14 Achat / Acquisition | Nov 12 | Nov 23 | 10d | 80%
1.3.2 | #12 Financement / Validation | Nov 9 | Nov 9 | 6h | 100%
1.3.3 | #11 Définition des besoins matériels | Nov 8 | Nov 9 | 1d | 100%
2 | Recup Signal | Nov 26 | Dec 12 | 7d 7h
2.1 | Etude Signal | Nov 26 | Nov 27 | 1d 2h
2.1.1 | #36 Relevé | Nov 26 | Nov 26 | 1d | 100% | | RR
2.1.2 | #37 Analyse/Etude Signal | Nov 27 | Nov 27 | 2h | 100% | | RR, FB
2.2 | Etude Ampli | Nov 27 | Nov 28 | 2d 6h
2.2.1 | #38 Conception Ampli (ORcad) | Nov 27 | Nov 27 | 2d | 100% | | RR, FB
2.2.2 | #39 Simulation Circuit (Orcad) | Nov 28 | Nov 28 | 6h | 100% | | RR, FB
2.3 | Fabrication Proto1 | Nov 28 | Nov 28 | 4h
2.3.1 | #40 Appro Matos | Nov 28 | Nov 28 | 2h | 100% | | RR, FB
2.3.2 | #41 Assemblage | Nov 28 | Nov 28 | 2h | 100% | | RR, FB
2.4 | Valid Recup Signal | Nov 28 | Dec 10 | 1d 3h
2.4.1 | #42 Simu Proto1 | Nov 28 | Nov 28 | 3h | 100%
2.4.2 | #43 Simu Proto2 | Dec 7 | Dec 10 | 1d | 100%
2.5 | Fabrication Proto2 | Dec 10 | Dec 12 | 2d
2.5.1 | #44 Dessin Typon | Dec 10 | Dec 11 | 1d | 0%
2.5.2 | #45 Appro/Fab C.I | Dec 11 | Dec 12 | 1d | 0%
2.6 | Phase 3 | Nov 28 | Nov 28
3 | Numerisation Signal | Nov 29 | Dec 18 | 11d 4h
3.1 | CAN - CNA Ampli1 | Nov 29 | Dec 7 | 7d 4h
3.1.1 | #46 Conception Logiciel Arduino 12B | Nov 29 | Nov 29 | 1d | 60% | | RR
3.1.2 | #47 Fab Ampli1 (amp+Ard+Hp) | Nov 30 | Nov 30 | 1d | 100%
3.1.3 | #48 Simulation Ampli1 | Nov 30 | Dec 7 | 5d 4h | 60%
3.2 | CAN - CNA Ampli2 | Dec 12 | Dec 14 | 2d
3.2.1 | #49 Fab Ampli2 - Aop RtoR | Dec 12 | Dec 13 | 1d | 0%
3.2.2 | #50 Simulation Ampli2 | Dec 13 | Dec 14 | 1d | 0%
3.3 | CAN - CNA Ampli3 | Dec 14 | Dec 18 | 2d
3.3.1 | #51 Conception Logiciel Arduino 24B | Dec 14 | Dec 17 | 1d | 0%
3.3.2 | #52 Simulation Ampli3 | Dec 17 | Dec 18 | 1d | 0%
4 | Connexion Wifi/uC | Dec 3 | Jan 2 | 23d 4h
4.1 | Assemblage Shield Wifi | Dec 3 | Dec 4 | 2d
4.1.1 | #53 Brochage Shield Wifi | Dec 3 | Dec 3 | 1d | 100% | | FB
4.1.2 | #54 Soudures Shield Wifi | Dec 4 | Dec 4 | 1d | 100%
4.2 | Arch Reseau | Dec 4 | Dec 10 | 4d 4h
4.2.1 | #55 Definition Mode de connexion | Dec 4 | Dec 4 | | 0%
4.2.2 | #56 @ip/DHCP | Dec 4 | Dec 4 | | 0%
4.2.3 | #57 Definition Port com (>1023) | Dec 4 | Dec 4 | | 0%
4.2.4 | #60 Réalisation schéma réseau | Dec 4 | Dec 5 | 1d 4h | 0%
4.2.5 | #73 Utilisation nc - com pc1/pc2 filaire | Dec 5 | Dec 6 | 1d | 0%
4.2.6 | #74 Utilisation nc - com pc1/pc2 wifi | Dec 6 | Dec 7 | 1d | 0%
4.2.7 | #75 Utilisation nc - com moduleWifly/pc | Dec 7 | Dec 10 | 1d | 0%
4.3 | Programmation Arduino DUE | Dec 10 | Jan 2 | 17d
4.3.1 | #58 Prog Mode Connexion | Dec 10 | Dec 26 | 12d | 0%
4.3.2 | #59 Transmission Data uC/Carte | Dec 26 | Jan 2 | 4d 7h | 0%
5 | Appli Tel/ Fonction connexion Wifi/Tel | Jan 3 | Jan 17 | 10d 5h
5.1 | Dev IHM de Base | Jan 3 | Jan 4 | 2d
5.1.1 | #66 Définition des besoins | Jan 3 | Jan 3 | 1d | 0%
5.1.2 | #67 mockup | Jan 4 | Jan 4 | 1d | 0%
5.2 | Dev Module Com/Tester Transmission | Jan 7 | Jan 17 | 8d 5h
5.2.1 | #64 Création vue config réseau | Jan 7 | Jan 10 | 3d 5h | 0%
5.2.2 | #65 Connexion module guitare | Jan 10 | Jan 17 | 5d | 0%
6 | Signal Audio Wifi/Tel | Jan 17 | Jan 31 | 11d
6.1 | Validation reception signal Audio | Jan 17 | Jan 22 | 3d
6.1.1 | #61 WidGet Signal(Graph) | Jan 21 | Jan 22 | 1d | 0%
6.1.2 | #62 Validation reception en console | Jan 17 | Jan 21 | 2d | 0%
6.2 | CNA - CAN Tel | Jan 21 | Jan 31 | 8d
6.2.1 | #63 Son vers Sortie Casque | Jan 21 | Jan 31 | 8d | 0%
7 | Appli Tel/ Fonctions supplémentaires | Feb 4 | Feb 5 | 2d
7.1 | Stockage/enregistrement | Feb 5 | Feb 5 | 1d
7.1.1 | #69 Création vue Stockage/enregistrement | Feb 5 | Feb 5 | 1d | 0%
7.2 | IHM Avancee | Feb 4 | Feb 4 | 1d
7.2.1 | #68 Définition des besoins des fonctions sup | Feb 4 | Feb 4 | 1d | 0%
8 | Conception Appli Tel | Jan 4 | Jan 4 | 3d
8.1 | Conception UML | Jan 4 | Jan 4 | 3d
8.1.1 | #70 Diagramme cas d'utilisation | Jan 4 | Jan 4 | 1d | 0%
8.1.2 | #71 Diagramme séquence/activité | Jan 4 | Jan 4 | 1d | 0%
8.1.3 | #72 Diagramme de classe | Jan 4 | Jan 4 | 1d | 0%
9 | A Definir | Nov 5 | Nov 5 | | 0%
10 | A Definir | Nov 5 | Nov 5 | | 0%
11 | A Definir | Nov 5 | Nov 5 | | 0%
12 | A Definir | Nov 5 | Nov 5 | | 0%
13 | A Definir | Nov 5 | Nov 5 | | 0%
14 | A Definir | Nov 5 | Nov 5 | | 0%

## Ressources

Nom | Nom abrégé | Type | Groupe | Adresse électronique | Coût
Florian BERNOUD | FB | Travail | | florian.bernoud@etu.univ-nantes.fr | 0
Romain RACZKA | RR | Travail | | romain.raczka@etu.univ-nantes.fr | 0

Ce fichier a été généré par Planner (http://live.gnome.org/Planner/)
