th3fr33man/jendrix/Rapports/recapDesTâches.xls

Sheet: S45
 |  | Reporting de projet tutoré
 | Nom- prénom : |  |  | Partenaire binôme : |  |  |  | Date:
Professeur référent : |  |  |  |  |  |  |  | Commanditaire:
Projet : |  |  |  |  |  |  |  | Objectifs à atteindre:
Date début : |  |  | Date fin :
I . Découpage initial du projet:
Etapes | n° sem | n° sem | n° sem | n° sem | n° sem | n° sem | n° sem | n° sem | n° sem | n° sem | n° sem
 | descriptif activités prévues
II. Avancement du projet :
Etape en cours : |  |  |  | Tâches de la période du au :
Tâches | Prévues |  | Réalisées |  | Résultats |  | Evaluation |  | Suite à prévoir
Commentaires :
Analyse du travail réalisé: appréciation des résultats
Explication des écarts prévu/réalisé
Initiatives prises : arbitrages, choix, parti pris
Contraintes à respecter prévues ou non prévues
Méthodes appliquées
Difficultés rencontrées surmontées ou non ; pistes de solutions
Conséquences de l'avancement sur le respect des délais, l'atteinte des objectifs..
III. Prévisions d'activité
semaine suivante / cycle suivant :
Etape concernée:
tâches | Contenu prévu |  |  | Résultat à atteindre |  |  |  | Points critiques identifiés
IV. Conclusion
Faits marquants de la période
Incidence des résultats sur le projet : modification du planning, révision des objectifs

Sheet: Planning
18:37:00 |  |  |  |  |  | Novembre |  |  |  |  |  |  |  |  |  |  |  |  |  |  |  |  |  |  |  |  |  |  |  | Décembre
 |  |  |  | Etat % |  | 45 |  |  |  |  |  | 46 |  |  |  |  |  | 47 |  |  |  |  |  | 48 |  |  |  |  |  | S49 |  |  |  |  |  | S50 |  |  |  |  |  | S51 |  |  |  |  |  | S52 |  |  |  |  |  | S44
Pilote | Projet | Phases | Tâches | 100% |  | Semaine | L | M | M | J | V | Semaine | L | M | M | J | V | Semaine | L | M | M | J | V | Semaine | L | M | M | J | V | Semaine | L | M | M | J | V | Semaine | L | M | M | J | V | Semaine | L | M | M | J | V | Semaine | L | M | M | J | V | Semaine
 |  |  |  |  | ?

Sheet: Cadrage
Ordre |  |  | Sujet | Qui | P/Action
1 | Sites concernés
 |  |  | BEL'M Husky et BEL'M Création
2 | Constitution de l'équipe projet LEAN
 |  | Validation du déploiement de la démarche Lean |  | AH, ER
 |  | Validation des objectifs |  | ER,RB,GG,Ereu
 |  | Husky
 |  |  | Pilotage et réalisation étude Lean projets 1, 2 et 4 | FBd
 |  |  | Pilotage et réalisation étude Lean projet 3 | FBo
 |  |  | Méthodes Zones Tolerie | TT
 |  |  | Méthodes Zone filmage tôles | TT
 |  |  | Méthodes Flux Dormants laqués | FO
 |  |  | Méthodes Zone usinage ouvrants | FO
 |  | Création
 |  |  | Déploiement du Lean : FBd | FBd
 |  |  | Méthodes Zones Décors : JBM | JBM
3 | Périmètre du projet LEAN
 |  | Husky - zone tôlerie
 |  |  | Process concernés
 |  |  | Tolerie : Plieuse, Cisaille, Poinçonneuses, prépa chariots
 |  |  | Motif de choix de la zone
 |  |  | Action sur Lead time de la zone permet de réduire le délais client
 |  | Husky - Filmage Tôles
 |  |  | Process concernés
 |  |  | Contrôle tôles, Filmage, Prépa chariots collage, Traitement des NC
 |  |  | Motif de choix de la zone
 |  |  | Action sur Lead time de la zone permet de réduire le délais client
 |  | Husky - Flux dormants laqués
 |  |  | Process concernés
 |  |  | Filmage profils, prépa profils mixtes, capotage , débit dormants
 |  |  | Motif de choix de la zone
 |  |  | Action sur Lead time de la zone permet de réduire le délais client
 |  | Création - Décors
 |  |  | Process concernés
 |  |  | Tous process présents dans zone décors
 |  |  | Zone physique concernée
 |  |  | Zone décors, soit une zone de 21m*29m (609m²)
 |  |  | Motif de choix de la zone
 |  |  | Zone identifiée comme abritant une partie du chemin critique
 |  |  | Rapatriement de flux dans la zone décors rendant réaménagement nécessaire
4 | Dates clefs Site Husky
 |  | Durée de mission FBd : 04/09/07à 29/02/08
 |  | 1. Projet zone filmage tôles (FBd)
 |  |  | a) Collecte des données : S41-42 - FBd
 |  |  | b) Etude et conception des lignes : S42-43 avec FBd, TT (Facultatif GG, RB, AH)
 |  |  | à Validation conception et implantation : S43 avec RB, GG, FBd, TT, AH (Facultatif ER, FO)
 |  |  | c) Chantier de progrès (à partir de l’implantation validée S43) : 22-23 Nov. -S47
 |  |  | d) Réimplantation de la zone : Vendredi 14 Dec. – S50
 |  | 2. Projet Flux Dormants (FBd)
 |  |  | a) Collecte des données : S41-42 - FBd
 |  |  | b) Etude et conception des lignes : S45-48-49 avec FBd, TT, FO (Facultatif GG, RB, AH)
 |  |  | à Validation conception et implantation : S48 avec RB, GG, FBd, FO, TT, AH (Facultatif ER, EReu)
 |  |  | c) Réimplantation des zones (livraison Scie Elu4 S50) : S52
 |  | 3. Projet Usinage Ouvrants (Implantation BREMA) (FBo)
 |  |  | a) Etude et conception des lignes : S43 ou S44 avec FBo, FO (Facultatif EReu, RB, AH)
 |  |  | à Validation conception et implantation : S44 avec RB, EReu, FBo, FO (Facultatif AH, ER, GG, TT, FBd)
 |  |  | b) Réimplantation du local proto : S47
 |  |  | c) Installation BREMA S02 pour démarrage S05
 |  | 4. Projet zone tôlerie (FBd)
 |  |  | a) Collecte des données : S50-51 - FBd
 |  |  | b) Etude et conception des lignes : S01-02 avec FBd, TT (Facultatif RB, AH, GG)
 |  |  | à Validation conception et implantation : S02 avec RB, GG, FBd, TT, AH (Facultatif ER, FO, FBo)
 |  | c) Réimplantation de la zone : Semaine fermeture Février
 |  | 5. Dét. des prochaines zones à sur lesquelles appliquer le Lean S 05 à fin mission FBd
5 | Objectifs conduite de projet
 |  |  | Projets menés en parallèles
6 | Objectifs chiffrés
 |  |  | Vmax annuel cible : PIC juin 2008 x12
 |  | Husky-Tolerie
 |  | 1, | Réduction de Lead time attendue : 40% de 2,5 jours soit 1 jour
 |  | 2, | Gain de surface attendu : 10% de 271m² soit 27m²
 |  | 3, | Réduction du BFR (Stocks encours) attendue : 20% de 64460€ soit 12900€
 |  | Husky - Filmage Tôles
 |  | 1, | Réduction de Lead time attendue : 40% de 2,5 jours soit 1 jour
 |  | 2, | Gain de surface attendu : 10% de 123 m² soit 12m²
 |  | 3, | Réduction du BFR (Stocks encours) attendue : 20% de 7064€ soit 1400€
 |  | Husky - Flux dormants laqués
 |  | 1, | Réduction de Lead time attendue : 20% de 1,6 jours soit 0,3 jour + 2Jours*
 |  | 2, | Gain de surface attendu : 10% de 313m² soit 31m²
 |  | 3, | Réduction du BFR (Stocks encours) attendue : 40% de 35224€ soit 14100€
 |  |  | * Réduction leadt time : 0,3 jours + 2 jours de synchro ouvrants/dormants
7 | Points de mesure - Indicateurs Projet
 |  |  | Planning
 |  |  | Diagramme Date-Date
8 | Points de mesure - Indicateurs LEAN
 |  | Husky
 |  |  | Lead time
 |  |  | Productivité
 |  |  | NC
 |  | Création
 |  |  | Lead time
10 | Communication sur les projets
 |  | Projet 1
 |  |  | "Chantier de progrès basé sur implantation Lean"
 |  | Projets 2,3,4
 |  |  | "Projet de réimplantation suivant la méthode LEAN"
 |  |  | Objectif N°1
 |  |  | Diminuer le temps que met un produit à traverser la zone étudiée
 |  |  | Comment?
 |  |  | En faisant en sorte que le produit s'arrête le mois possible (dans un stock, en amont ou aval d'un poste) et en faisant en sorte qu'il ait le mois de chemin possible à parcourir. En Bref, tendre vers un flux continu et raccourci
 |  |  | A quoi servent les prises de temps(SOE)?
 |  |  | Elles permettent d'évaluer la charge de chaque poste(ex : Filmage tôle, prépa chariot …) indépendamment les uns des autres. Ceci permet de revoir l'ordre des taches, la répartition des opérateurs, et d'anticiper les augmentations de charge à venir

Sheet: FA01
Ordre | Sujet | Qui | P/Action

Sheet: Calendrier
Phase | Activité | tache | Action | N° | Qui | Durée en J | Jour | S45 | S46 | S47 | S48 | S49 | S50 | S51 | S52 | S01 | S02 | S03 | S04 | S05 | S06 | S07 | S08 | S09 | S10 | S11
Légende couleur
 | Fermé en binôme
 | Fermé par Rom
 | Fermé par Flo
 | En cour
Phase 1
 | Organisation
 | Issue #1 | Renseigner outils d suivi |  |  | RR,FB
 | Issue #35 | Création du cahier des charges.
 | Issue #2 | cadrage | CDC |  | RR,FB |  | Vendredi
 | Issue #3 | Validation Cdc tuteur
 | Issue #28 | ajout des taches dans GITHUB |  |  | RR |  | Lundi
 | Vtech
 | Issue #29 | Identifier les diverses modules sans fil |  |  | RR,FB | 5 | point matin
 | Issue #30 | Identification interface guitare |  |  | RR,FB | 5 | point matin
 | Issue #31 | Etuge de la gestion énergétique |  |  | RR,FB | 5 | point matin
 | Issue #4 | Listing applis et matériel existant sur même theme |  |  | RR,FB | 5 | point matin
 | Issue #5 | Recherche modules adaptables |  |  | RR,FB | 5 | point matin
 | Apprentissage
 | Issue #33 | Prise en main Github | appropriation |  | RR,FB
 | Issue #34 | Prise en main Eclipse | appropriation |  | RR,FB
 | Issue #6 | Univers appli android |  |  | RR,FB
 | Issue #7 | Langage android |  |  | RR,FB
 | Issue #8 | Electronique |  |  | RR,FB
 | Issue #9 | WIFI |  |  | RR,FB
 | Issue #10 | modèle MVC |  |  | RR,FB
 | Appro matériel
 | Issue #11 | Définition des besoins matériels
 | Issue #12 | financement / validation
 | Issue #13 | Achat / Acquisition
 | Protoypage matériel
 |  | voir veille tech
 | Issue #15 | Etude architecture mat
 | Issue #16 | Programmation Hard
 | Issue #17 | Assemblage
 | Développement logiciel
 | Issue #17 | Création IHM basique
 | Issue #18 | Création IHM avancée
 | Issue #19 | Conception architecture
 | Issue #20 | Activity socket serveur
 | Issue #21 | Activity socket client
 | Issue #22 | Activity start/stop Diffusion du son
 | Issue #23 | Activity activer le wifi(si non actif)
 | Issue #24 | Création menu setting de l'application
 | Issue #25 | Création widget courbe du son(graphique temps réel)
 | Issue #26 | Règlage son(m-b-a) + volume
 |  | Interface Hardware
 |  | Def des classes/activité
 | Essais
 |  | Achat + cdc ?
 |  | Interface IHM ?
 |  | Com entre deux tel en WIFI?
 |  | Assemblage proto ?
 |  | Com proto/tel ?
 |  | App + proto final
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
