th3fr33man/jendrix/Rapports/archives/JENDRIX2.html

# Projet JENDRIX

Société : | LP SEICOM
Responsable : | O.COMMENGE et P.LEGALL
Début : | 5 nov. 2012
Fin : | 21 déc. 2012
Date du rapport : | 3 déc. 2012

## Diagramme de Gantt

TPÉ | Nom | Travail
1 | Lancement | 39d 3h
1.1 | Organisation | 5d 2h
1.1.1 | #35 Creation CdC | 2h
1.1.2 | #3 Validation CdC tuteur | 2d
1.1.3 | #2 Cadrage | 1d
1.1.4 | #28 Ajout des premières tâches dans github | 1d
1.1.5 | #1 Renseigner outils de suivi | 1d
1.2 | VTech | 20d 6h
1.2.1 | #30 Identification interface guitare | 5d
1.2.2 | #29 Identifier les diverses modules sans fil | 5d
1.2.3 | #5 Recherche modules adaptables | 5d
1.2.4 | #4 Listing applis et matériels existant sur même theme | 4d 6h
1.2.5 | #31 Etuge de la gestion énergétique | 1d
1.3 | Appro | 13d 3h
1.3.1 | #14 Achat / Acquisition | 10d 7h
1.3.2 | #12 Financement / Validation | 1d 6h
1.3.3 | #11 Définition des besoins matériels | 6h
2 | Recup Signal | 9d 5h
2.1 | Etude Signal | 2d 2h
2.1.1 | #36 Relevé | 1d
2.1.2 | #37 Analyse/Etude Signal | 1d 2h
2.2 | Etude Ampli | 2d 6h
2.2.1 | #38 Conception Ampli (ORcad) | 2d
2.2.2 | #39 Simulation Circuit (Orcad) | 6h
2.3 | Fabrication Proto1 | 1d 2h
2.3.1 | #40 Appro Matos | 2h
2.3.2 | #41 Assemblage | 1d
2.4 | Valid Recup Signal | 1d 3h
2.4.1 | #42 Simu Proto1 | 3h
2.4.2 | #43 Simu Proto2 | 1d
2.5 | Fabrication Proto2 | 2d
2.5.1 | #44 Dessin Typon | 1d
2.5.2 | #45 Appro/Fab C.I | 1d
2.6 | Début Phase3
3 | Numerisation Signal | 11d 1h
3.1 | CAN - CNA Ampli1 | 7d 2h
3.1.1 | #46 Conception Logiciel Arduino 12B | 7h
3.1.2 | #47 Fab Ampli1 (amp+Ard+Hp) | 5h
3.1.3 | #48 Simulation Ampli1 | 5d 5h
3.2 | CAN - CNA Ampli2 | 1d 7h
3.2.1 | #49 Fab Ampli2 - Aop RtoR | 1d
3.2.2 | #50 Simulation Ampli2 | 7h
3.3 | CAN - CNA Ampli3 | 2d
3.3.1 | #51 Conception Logiciel Arduino 24B | 1d
3.3.2 | #52 Simulation Ampli3 | 1d
4 | Connexion Wifi/uC | 17d 6h
4.1 | Assemblage Shield Wifi | 3d
4.1.1 | #53 Brochage Shield Wifi | 2d
4.1.2 | #54 Soudures Shield Wifi | 1d
4.2 | Arch Reseau | 2d 6h
4.2.1 | #55 Definition Mode de connexion | 2h
4.2.2 | #56 @ip/DHCP | 5h
4.2.3 | #57 Definition Port com (>1023) | 6h
4.2.4 | #60 Réalisation schéma réseau | 1d
4.3 | Programmation Arduino DUE | 12d
4.3.1 | #58 Prog Mode Connexion | 7d
4.3.2 | #59 Transmission Data uC/Carte | 5d
5 | Connexion Wifi/Tel | 2d
5.1 | Dev IHM de Base | 1d
5.1.1 | | 1d
5.2 | Dev Module Com/Tester Transmission | 1d
5.2.1 | | 1d
6 | Signal Audio Wifi/Tel | 2d
6.1 | WidGet Signal(Graph) | 1d
6.1.1 | | 1d
6.2 | CNA - CAN Tel | 1d
6.2.1 | | 1d
7 | Appli Tel | 3d
7.1 | Sortie Casque | 1d
7.1.1 | | 1d
7.2 | Stockage/enregistrement | 1d
7.2.1 | | 1d
7.3 | IHM Avancee | 1d
7.3.1 | | 1d

Semaine 45, 2012 | | | | | | | Semaine 46, 2012 | | | | | | | Semaine 47, 2012 | | | | | | | Semaine 48, 2012 | | | | | | | Semaine 49, 2012 | | | | | | | Semaine 50, 2012 | | | | | | | Semaine 51, 2012
5 | 6 | 7 | 8 | 9 | 10 | 11 | 12 | 13 | 14 | 15 | 16 | 17 | 18 | 19 | 20 | 21 | 22 | 23 | 24 | 25 | 26 | 27 | 28 | 29 | 30 | 1 | 2 | 3 | 4 | 5 | 6 | 7 | 8 | 9 | 10 | 11 | 12 | 13 | 14 | 15 | 16 | 17 | 18 | 19 | 20 | 21 | 22 | 23 | 24 | 25 | 26 | 27 | 28
RR
RR, FB
RR, FB
RR, FB
RR, FB
RR, FB
◆
RR
FB

## Tâches

TPÉ | Nom | Démarré | Terminé | Travail | État d'avancement | Coût | Assigné à
1 | Lancement | Nov 5 | Nov 23 | 39d 3h
1.1 | Organisation | Nov 5 | Nov 8 | 5d 2h
1.1.1 | #35 Creation CdC | Nov 5 | Nov 5 | 2h | 0%
1.1.2 | #3 Validation CdC tuteur | Nov 5 | Nov 7 | 2d | 50%
1.1.3 | #2 Cadrage | Nov 7 | Nov 8 | 1d | 0%
1.1.4 | #28 Ajout des premières tâches dans github | Nov 5 | Nov 5 | 1d | 0%
1.1.5 | #1 Renseigner outils de suivi | Nov 5 | Nov 5 | 1d | 0%
1.2 | VTech | Nov 5 | Nov 9 | 20d 6h
1.2.1 | #30 Identification interface guitare | Nov 5 | Nov 9 | 5d | 0%
1.2.2 | #29 Identifier les diverses modules sans fil | Nov 5 | Nov 9 | 5d | 0%
1.2.3 | #5 Recherche modules adaptables | Nov 5 | Nov 9 | 5d | 0%
1.2.4 | #4 Listing applis et matériels existant sur même theme | Nov 5 | Nov 9 | 4d 6h | 0%
1.2.5 | #31 Etuge de la gestion énergétique | Nov 5 | Nov 5 | 1d | 0%
1.3 | Appro | Nov 8 | Nov 23 | 13d 3h
1.3.1 | #14 Achat / Acquisition | Nov 9 | Nov 23 | 10d 7h | 80%
1.3.2 | #12 Financement / Validation | Nov 8 | Nov 9 | 1d 6h | 0%
1.3.3 | #11 Définition des besoins matériels | Nov 8 | Nov 8 | 6h | 0%
2 | Recup Signal | Nov 5 | Nov 29 | 9d 5h
2.1 | Etude Signal | Nov 26 | Nov 27 | 2d 2h
2.1.1 | #36 Relevé | Nov 26 | Nov 26 | 1d | 100% | | RR
2.1.2 | #37 Analyse/Etude Signal | Nov 27 | Nov 27 | 1d 2h | 100% | | RR, FB
2.2 | Etude Ampli | Nov 27 | Nov 28 | 2d 6h
2.2.1 | #38 Conception Ampli (ORcad) | Nov 27 | Nov 27 | 2d | 100% | | RR, FB
2.2.2 | #39 Simulation Circuit (Orcad) | Nov 28 | Nov 28 | 6h | 100% | | RR, FB
2.3 | Fabrication Proto1 | Nov 28 | Nov 28 | 1d 2h
2.3.1 | #40 Appro Matos | Nov 28 | Nov 28 | 2h | 100% | | RR, FB
2.3.2 | #41 Assemblage | Nov 28 | Nov 28 | 1d | 13% | | RR, FB
2.4 | Valid Recup Signal | Nov 5 | Nov 29 | 1d 3h
2.4.1 | #42 Simu Proto1 | Nov 29 | Nov 29 | 3h | 100%
2.4.2 | #43 Simu Proto2 | Nov 5 | Nov 5 | 1d | 0%
2.5 | Fabrication Proto2 | Nov 5 | Nov 5 | 2d
2.5.1 | #44 Dessin Typon | Nov 5 | Nov 5 | 1d | 0%
2.5.2 | #45 Appro/Fab C.I | Nov 5 | Nov 5 | 1d | 0%
2.6 | Début Phase3 | Nov 29 | Nov 29
3 | Numerisation Signal | Nov 5 | Dec 7 | 11d 1h
3.1 | CAN - CNA Ampli1 | Nov 29 | Dec 7 | 7d 2h
3.1.1 | #46 Conception Logiciel Arduino 12B | Nov 29 | Nov 30 | 7h | 34% | | RR
3.1.2 | #47 Fab Ampli1 (amp+Ard+Hp) | Nov 30 | Nov 30 | 5h | 0%
3.1.3 | #48 Simulation Ampli1 | Nov 30 | Dec 7 | 5d 5h | 30%
3.2 | CAN - CNA Ampli2 | Nov 5 | Nov 5 | 1d 7h
3.2.1 | #49 Fab Ampli2 - Aop RtoR | Nov 5 | Nov 5 | 1d | 0%
3.2.2 | #50 Simulation Ampli2 | Nov 5 | Nov 5 | 7h | 0%
3.3 | CAN - CNA Ampli3 | Nov 5 | Nov 5 | 2d
3.3.1 | #51 Conception Logiciel Arduino 24B | Nov 5 | Nov 5 | 1d | 0%
3.3.2 | #52 Simulation Ampli3 | Nov 5 | Nov 5 | 1d | 0%
4 | Connexion Wifi/uC | Dec 3 | Dec 21 | 17d 6h
4.1 | Assemblage Shield Wifi | Dec 3 | Dec 5 | 3d
4.1.1 | #53 Brochage Shield Wifi | Dec 3 | Dec 4 | 2d | 0% | | FB
4.1.2 | #54 Soudures Shield Wifi | Dec 5 | Dec 5 | 1d | 0%
4.2 | Arch Reseau | Dec 5 | Dec 6 | 2d 6h
4.2.1 | #55 Definition Mode de connexion | Dec 5 | Dec 5 | 2h | 0%
4.2.2 | #56 @ip/DHCP | Dec 5 | Dec 5 | 5h | 0%
4.2.3 | #57 Definition Port com (>1023) | Dec 6 | Dec 6 | 6h | 0%
4.2.4 | #60 Réalisation schéma réseau | Dec 6 | Dec 6 | 1d | 0%
4.3 | Programmation Arduino DUE | Dec 6 | Dec 21 | 12d
4.3.1 | #58 Prog Mode Connexion | Dec 6 | Dec 14 | 7d | 0%
4.3.2 | #59 Transmission Data uC/Carte | Dec 17 | Dec 21 | 5d | 0%
5 | Connexion Wifi/Tel | Nov 5 | Nov 6 | 2d
5.1 | Dev IHM de Base | Nov 5 | Nov 5 | 1d
5.1.1 | | Nov 5 | Nov 5 | 1d | 0%
5.2 | Dev Module Com/Tester Transmission | Nov 6 | Nov 6 | 1d
5.2.1 | | Nov 6 | Nov 6 | 1d | 0%
6 | Signal Audio Wifi/Tel | Nov 5 | Nov 7 | 2d
6.1 | WidGet Signal(Graph) | Nov 5 | Nov 5 | 1d
6.1.1 | | Nov 5 | Nov 5 | 1d | 0%
6.2 | CNA - CAN Tel | Nov 7 | Nov 7 | 1d
6.2.1 | | Nov 7 | Nov 7 | 1d | 0%
7 | Appli Tel | Nov 5 | Nov 7 | 3d
7.1 | Sortie Casque | Nov 5 | Nov 5 | 1d
7.1.1 | | Nov 5 | Nov 5 | 1d | 0%
7.2 | Stockage/enregistrement | Nov 6 | Nov 6 | 1d
7.2.1 | | Nov 6 | Nov 6 | 1d | 0%
7.3 | IHM Avancee | Nov 7 | Nov 7 | 1d
7.3.1 | | Nov 7 | Nov 7 | 1d | 0%

## Ressources

Nom | Nom abrégé | Type | Groupe | Adresse électronique | Coût
Florian BERNOUD | FB | Travail | | florian.bernoud@etu.univ-nantes.fr | 0
Romain RACZKA | RR | Travail | | romain.raczka@etu.univ-nantes.fr | 0

Ce fichier a été généré par Planner (http://live.gnome.org/Planner/)
