th3fr33man/jendrix/Ressources/ShémasTableau/IMG_20121205_175232.jpg

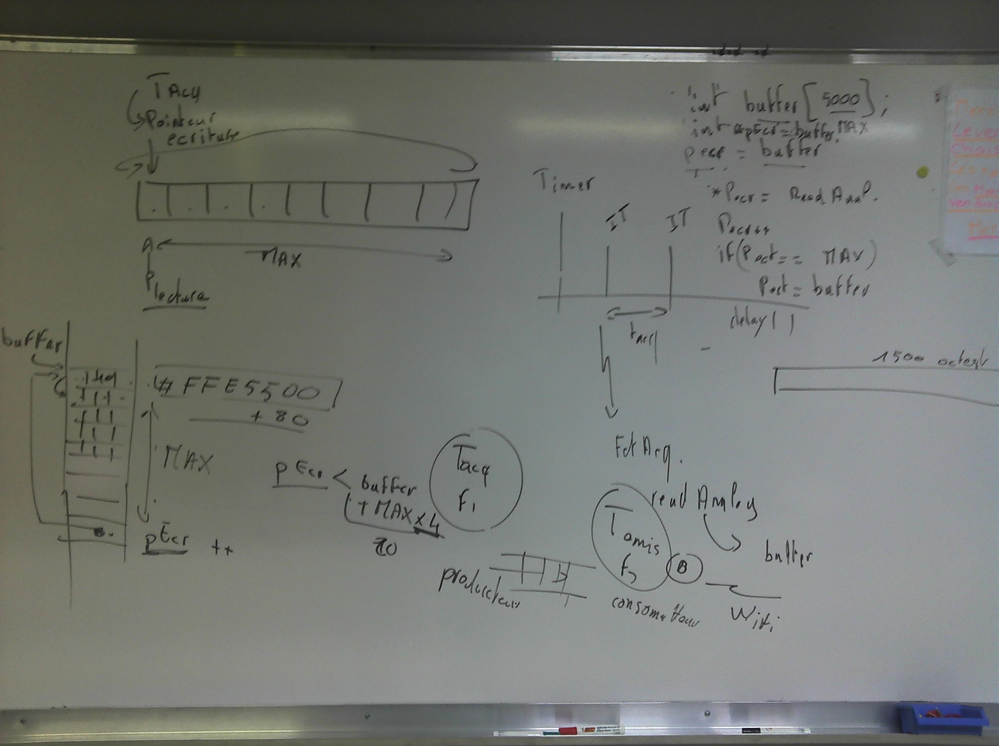
Ressources/ShémasTableau/IMG_20121205_175232.jpg
