th3fr33man/jendrix/Ressources/ShémasTableau/IMG_20121205_181501.jpg

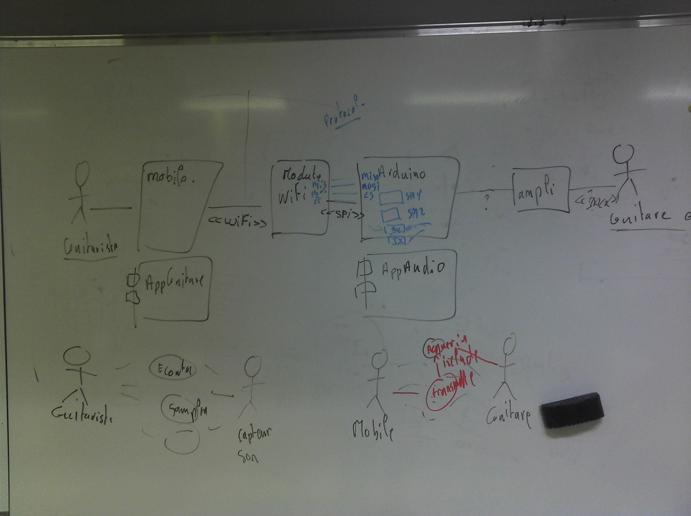
Ressources/ShémasTableau/IMG_20121205_181501.jpg
