th3fr33man/jendrix/Ressources/ShémasTableau/IMG_20121205_181505.jpg

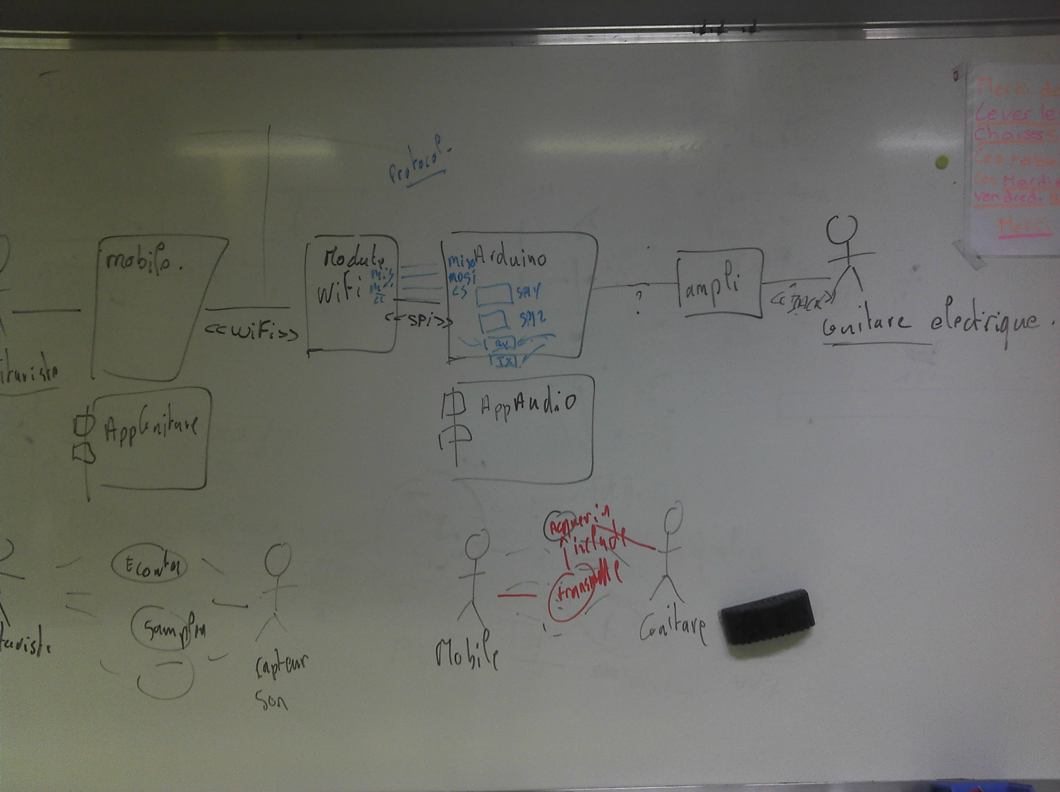
Ressources/ShémasTableau/IMG_20121205_181505.jpg
