th3fr33man/jendrix/Ressources/ShémasTableau/IMG_20121207_140610.jpg

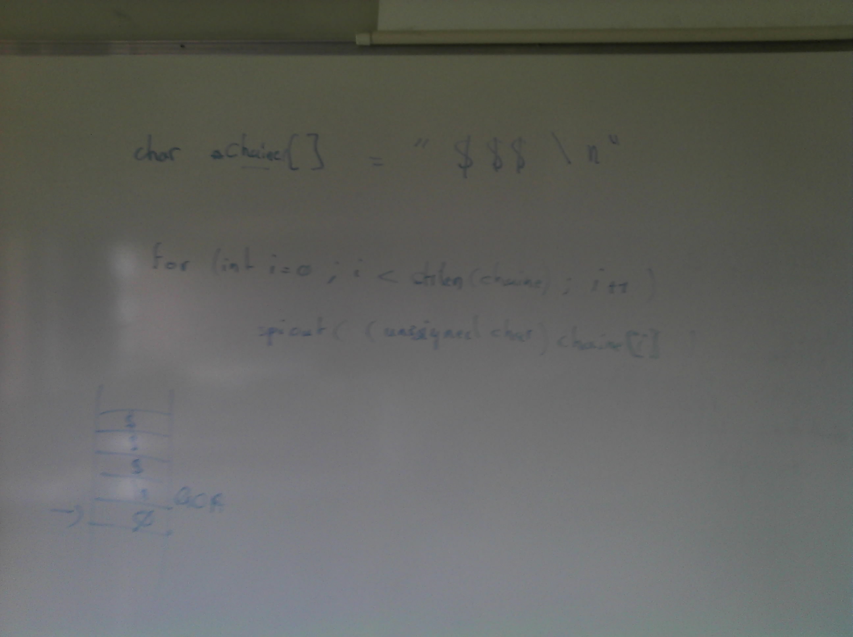
Ressources/ShémasTableau/IMG_20121207_140610.jpg
