th3fr33man/jendrix/Ressources/ShémasTableau/IMG_20121207_180807.jpg

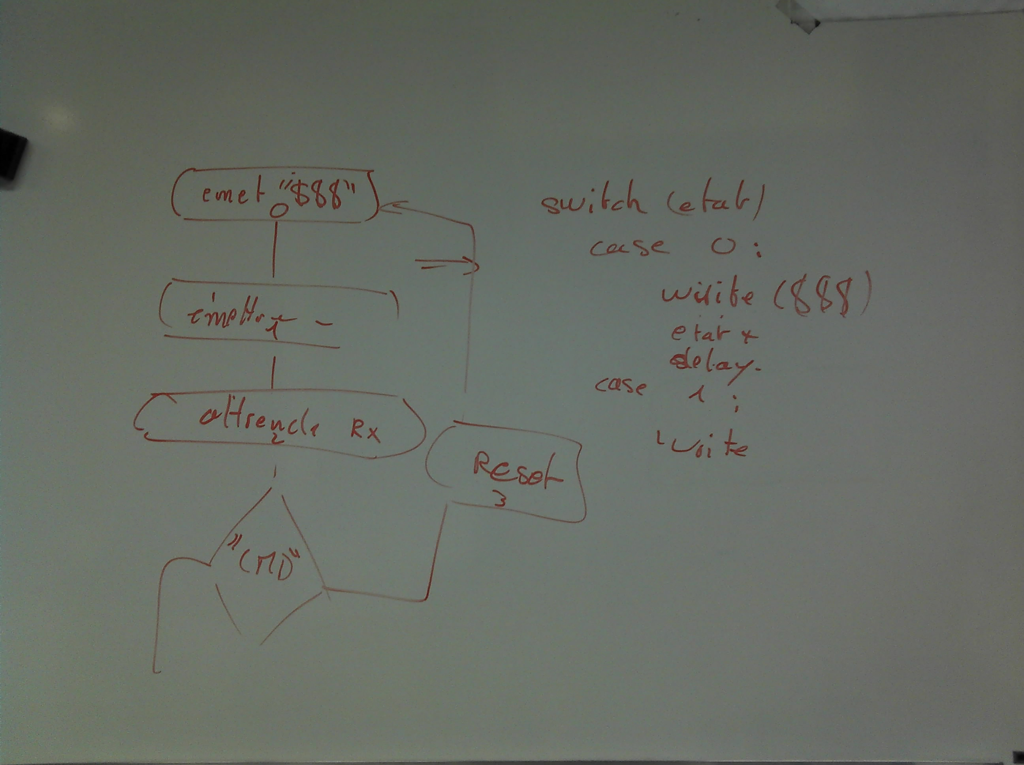
Ressources/ShémasTableau/IMG_20121207_180807.jpg
