th3fr33man/jendrix/Ressources/Signal_Guitare_oscillo/normal2.png

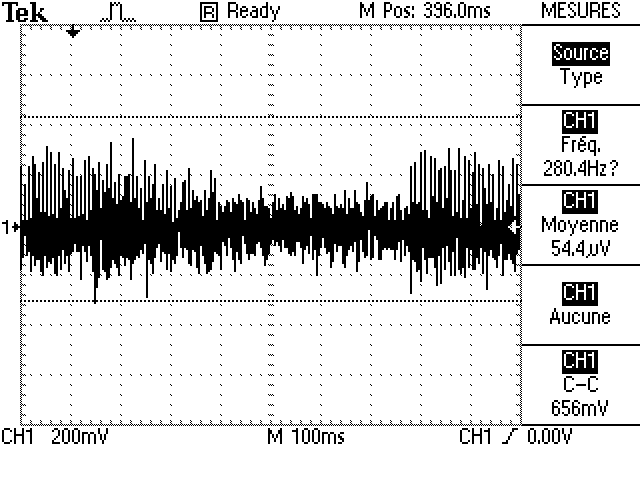
Ressources/Signal_Guitare_oscillo/normal2.png
