th3fr33man/jendrix/Ressources/Signal_Guitare_oscillo/normal4.png

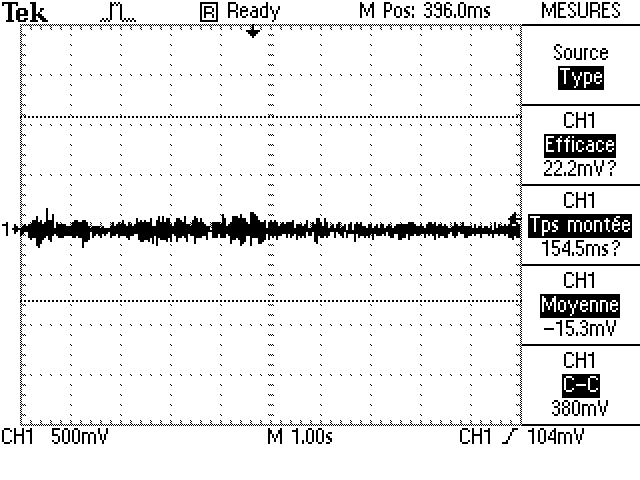
Ressources/Signal_Guitare_oscillo/normal4.png
