th3fr33man/jendrix/Ressources/Signal_Guitare_oscillo/normal5.png

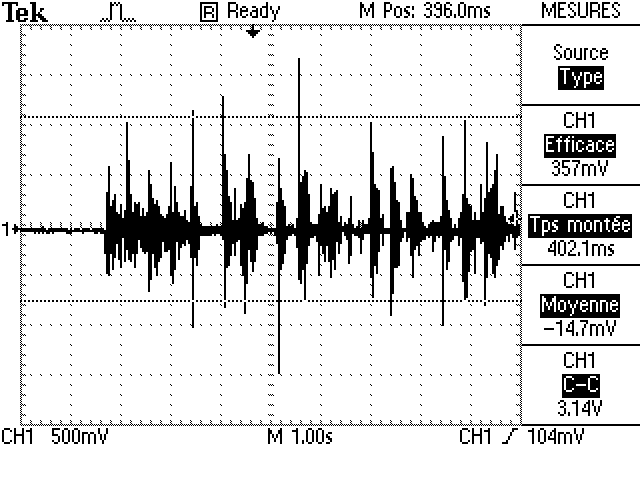
Ressources/Signal_Guitare_oscillo/normal5.png
