th3fr33man/jendrix/Ressources/Signal_Guitare_oscillo/normal7.png

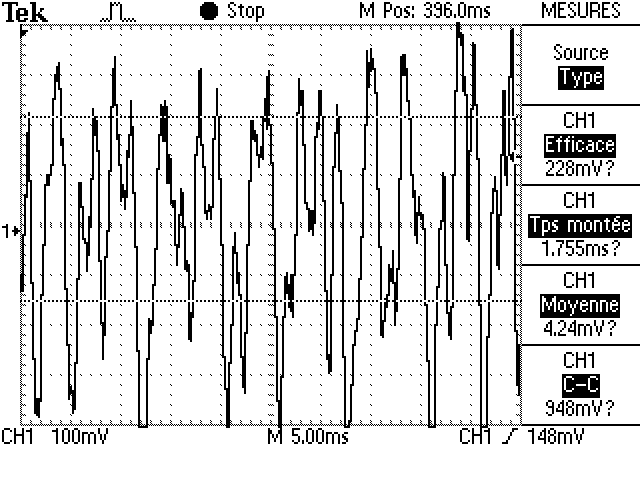
Ressources/Signal_Guitare_oscillo/normal7.png
