th3fr33man/jendrix/Ressources/Signal_Guitare_oscillo/normal10.png

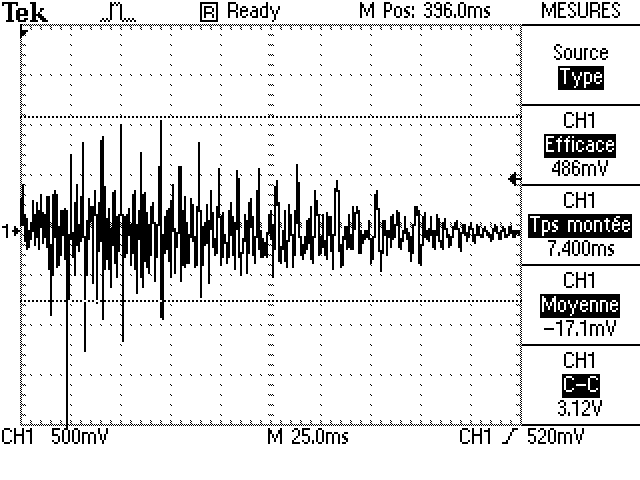
Ressources/Signal_Guitare_oscillo/normal10.png
