th3fr33man/jendrix/Ressources/Signal_Guitare_oscillo/pic1.png

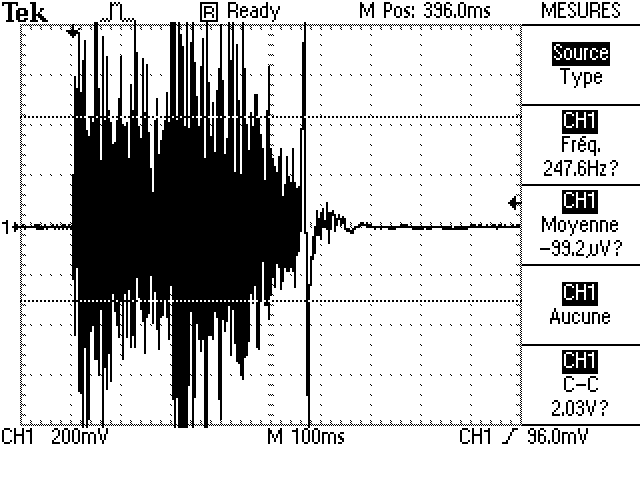
Ressources/Signal_Guitare_oscillo/pic1.png
