th3fr33man/jendrix/Ressources/Signal_Oscillo_Et_Ampli/mp3Play1_volmax.png

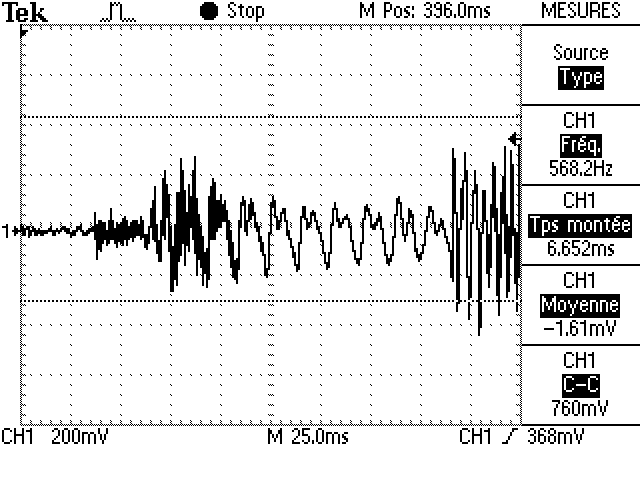
Ressources/Signal_Oscillo_Et_Ampli/mp3Play1_volmax.png
