th3fr33man/jendrix/Ressources/Signal_Oscillo_Et_Ampli/mp3Play2_proto.png

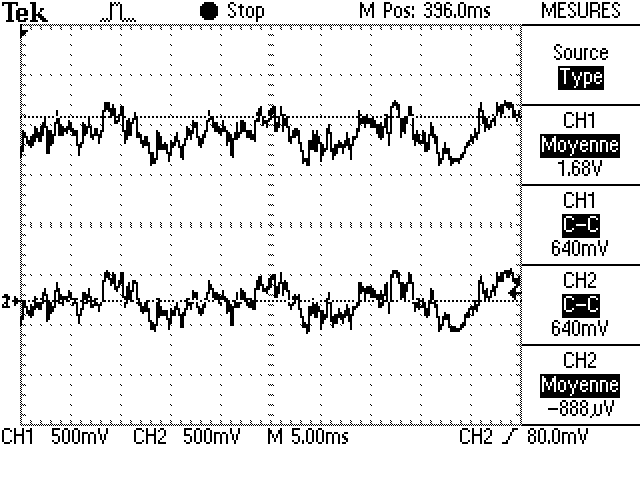
Ressources/Signal_Oscillo_Et_Ampli/mp3Play2_proto.png
