th3fr33man/jendrix/Ressources/Signal_Oscillo_Et_Ampli/mp3Play3_proto.png

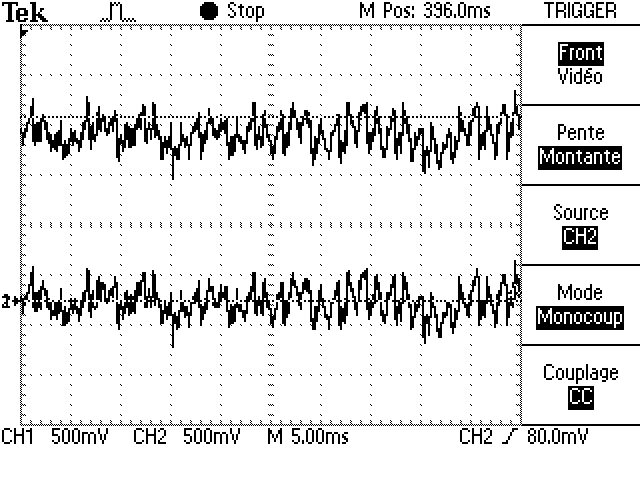
Ressources/Signal_Oscillo_Et_Ampli/mp3Play3_proto.png
