th3fr33man/jendrix/Ressources/Signal_Oscillo_Et_Ampli/smartIm1.png

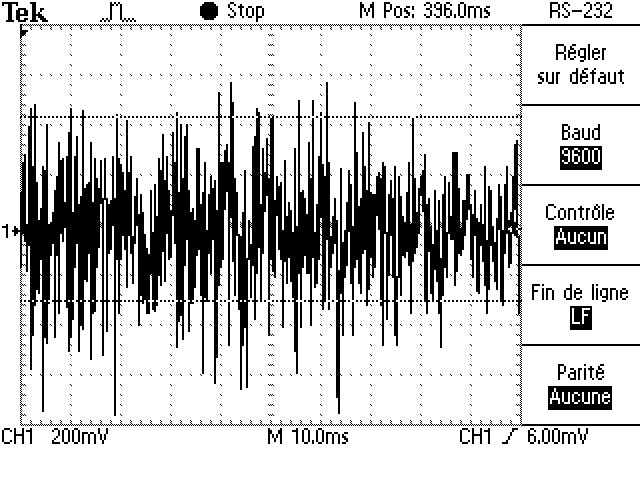
Ressources/Signal_Oscillo_Et_Ampli/smartIm1.png
