th3fr33man/jendrix/Ressources/Signal_Oscillo_Et_Ampli/smartIm2.png

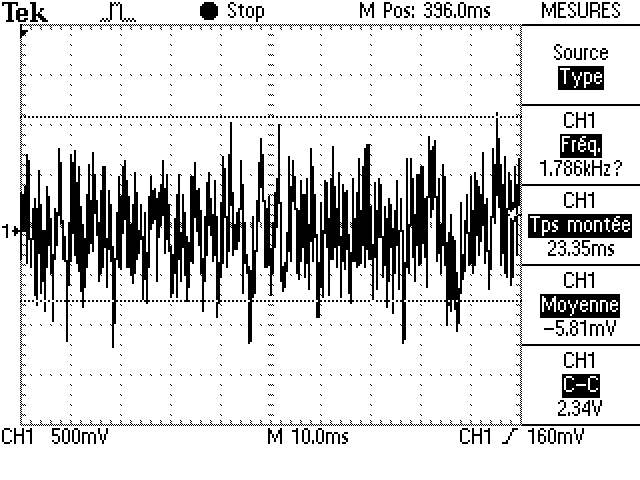
Ressources/Signal_Oscillo_Et_Ampli/smartIm2.png
