th3fr33man/jendrix/Ressources/Signal_Oscillo_Et_Ampli/smartIm3_volmax.png

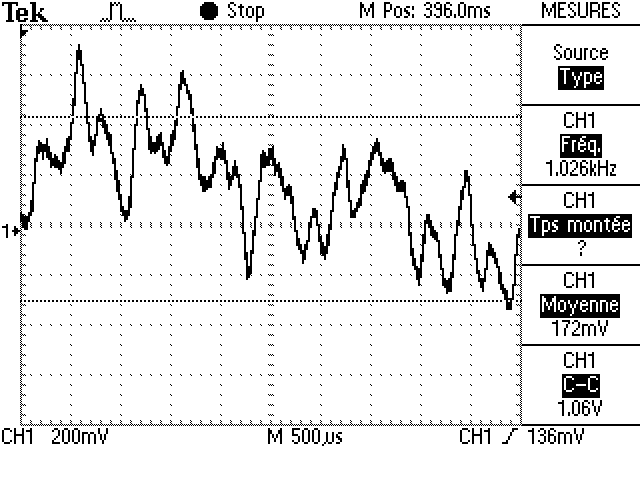
Ressources/Signal_Oscillo_Et_Ampli/smartIm3_volmax.png
