th3fr33man/jendrix/Ressources/Signal_Oscillo_Et_Ampli/smartIm4_volmin.png

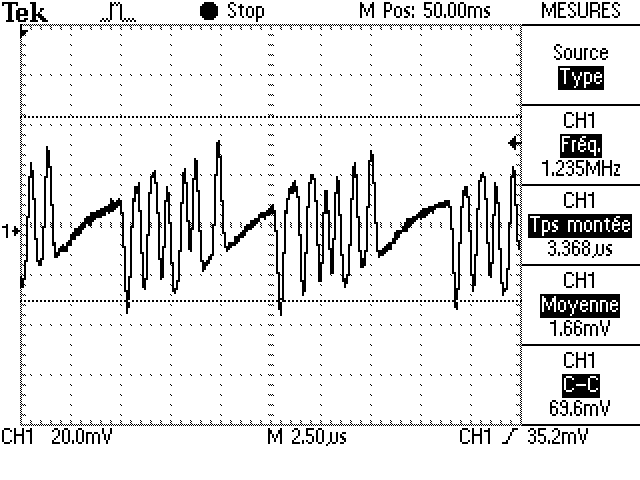
Ressources/Signal_Oscillo_Et_Ampli/smartIm4_volmin.png
