th3fr33man/jendrix/Ressources/Simu_Signal_Avec_Ampli/simu_aop_cc1_5v.PNG

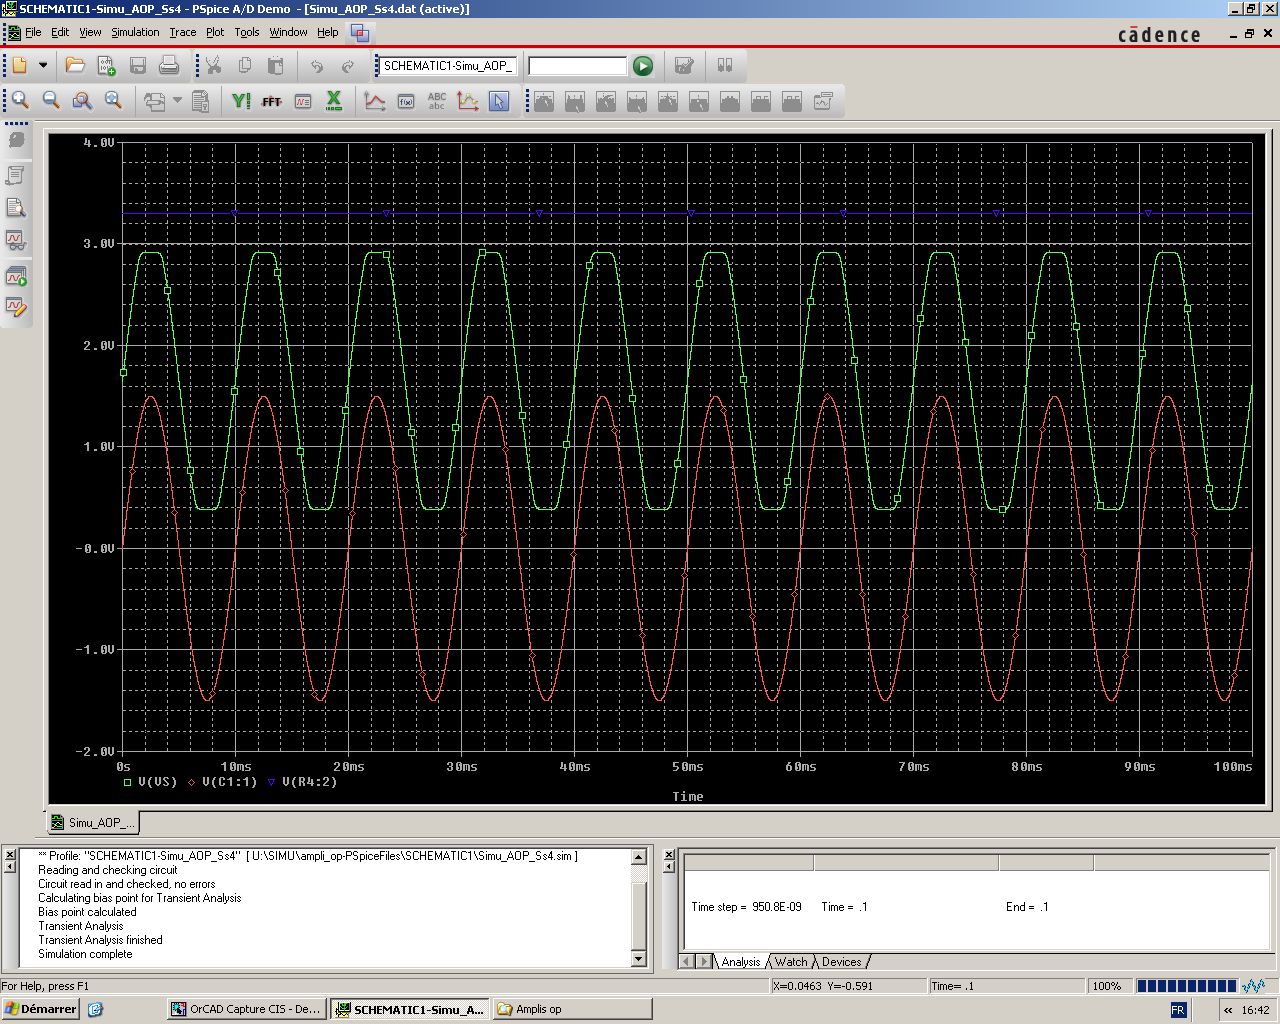
Ressources/Simu_Signal_Avec_Ampli/simu_aop_cc1_5v.PNG
