th3fr33man/jendrix/Ressources/Simu_Signal_Avec_Ampli/simu_aop_cc1v_500hz.PNG

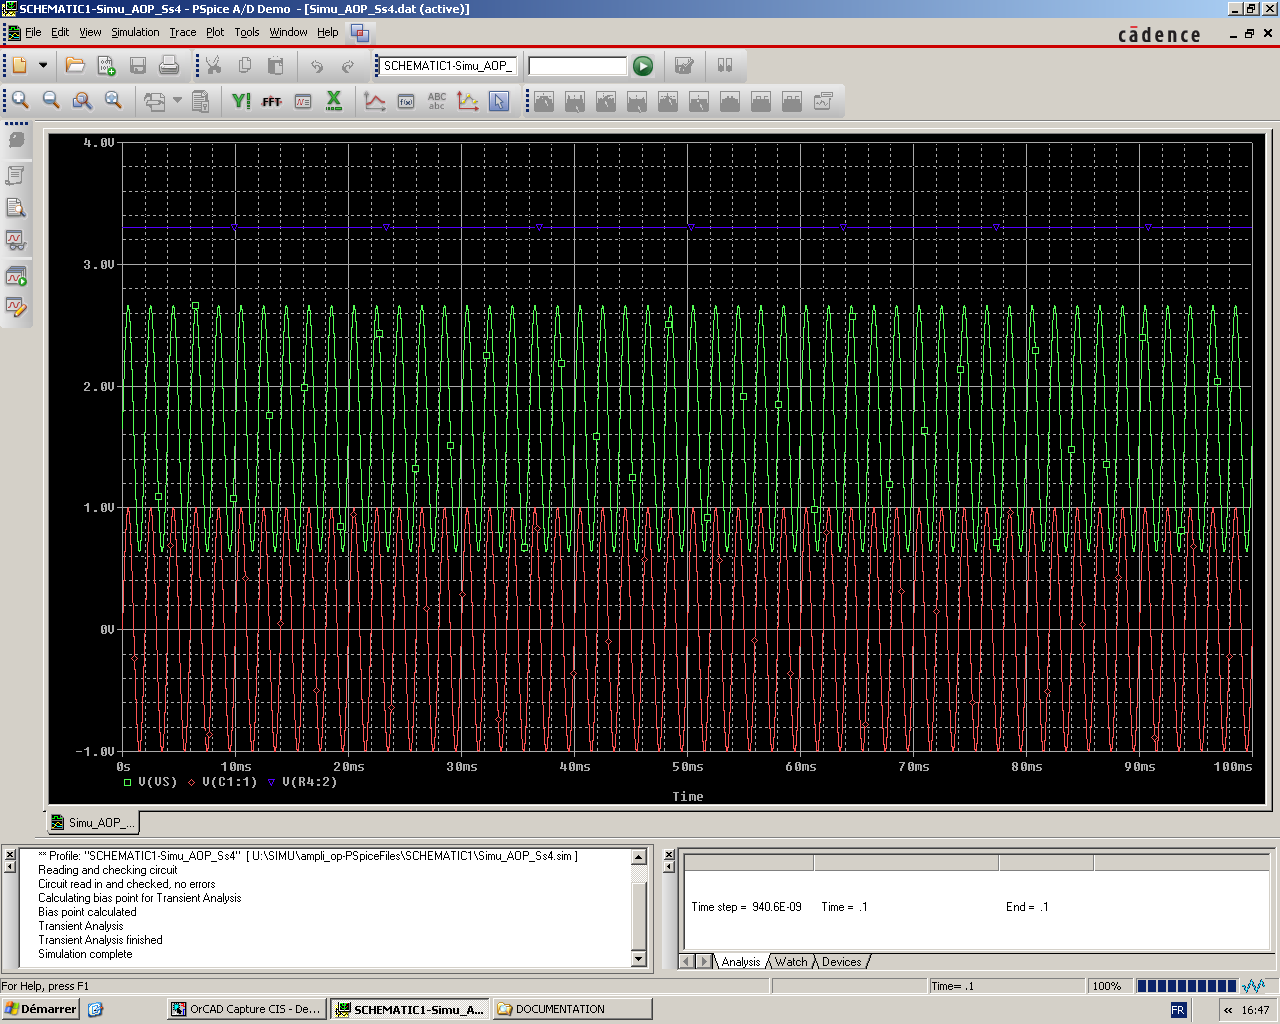
Ressources/Simu_Signal_Avec_Ampli/simu_aop_cc1v_500hz.PNG
