th3fr33man/jendrix/Ressources/Simu_Signal_Avec_Ampli/simu_aop_cc4v.PNG

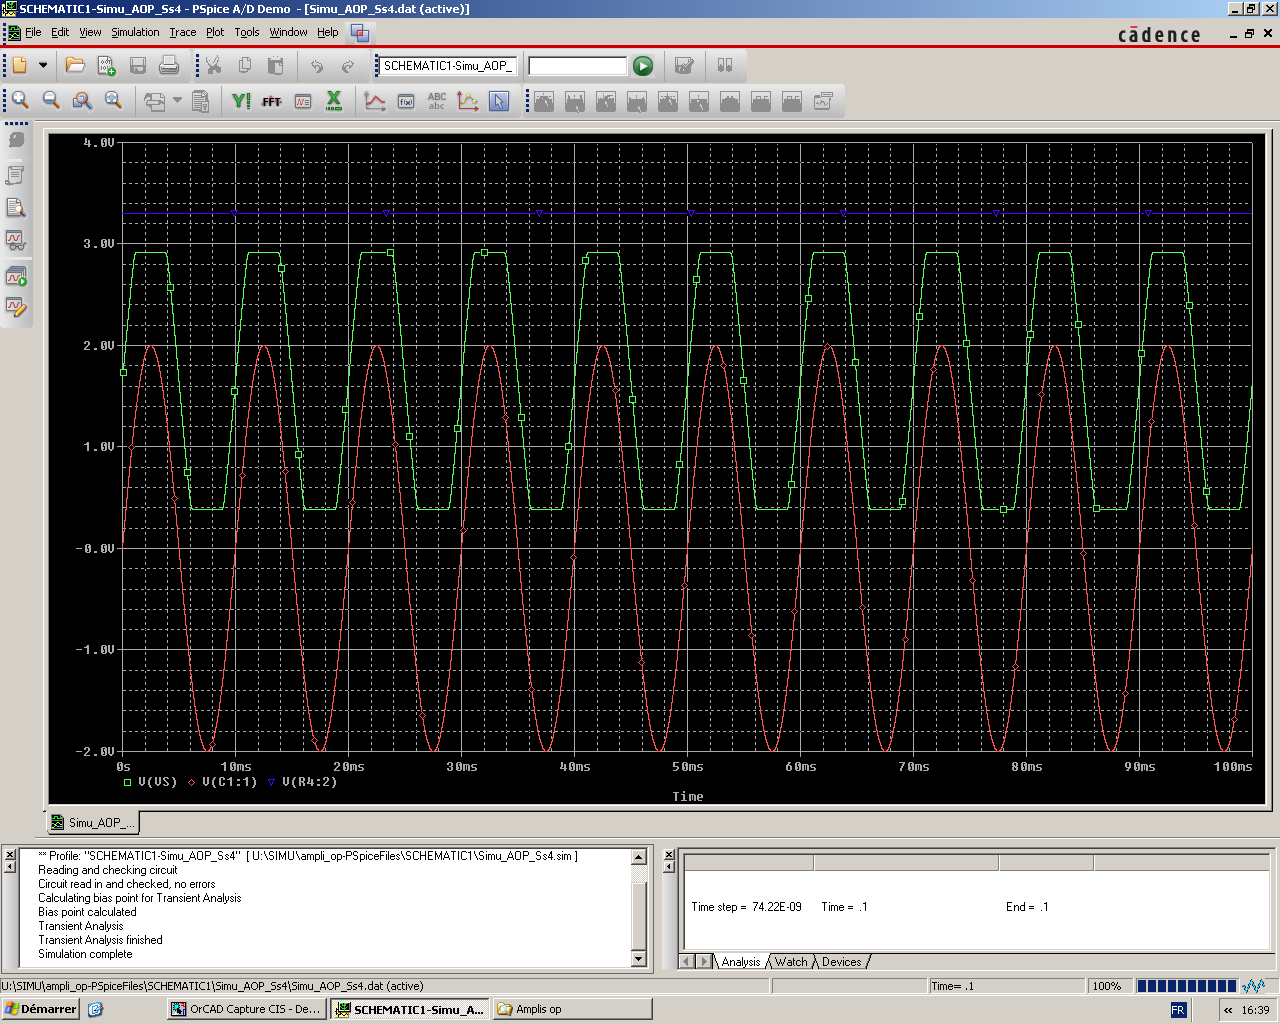
Ressources/Simu_Signal_Avec_Ampli/simu_aop_cc4v.PNG
