th3fr33man/jendrix/Rapports/Flo/Reporting_LP_SEICOM2012_S04_FB.ods

 |  | Reporting de projet tutoré
 | Nom- prénom : | Bernoud Florian |  | Partenaire binôme : |  | Raczka Romain |  | Date: | S48 2012
Professeur référent : | Olivier Commenge & Philippe Legal |  |  |  |  |  |  | Commanditaire: |  | Projet personnel
Projet : | Conception d'un module de transmission du son sans fil vers une application pour smartphone |  |  |  |  |  |  | Objectifs à atteindre: |  | Transmission et diffusion du son en sortie d'une guitare sur le smartphone fonctionnel
Date début : | 05/11/12 |  | Date fin : | ?
I . Découpage initial du projet:
Etapes | S45 | S48 | S49 | S04 | S05 | S11
1. Lancement
1.1 Organisation
1.2 Veille Technologique
1.3 Approvisionnement du matériel
2.Récupération du signal sortie Guitare
2.1 Etude Signal
2.2 Etude Amplificateur sortie guitare
2.3 Fabrication du proto 1 Ampli
2.4 Validation Proto 1
2.5 Fabrication Proto 2 (en fct avance)
3. Numérisation du signal
3.1 CAN-CNA proto ampli 1
3.2 CAN-CNA proto ampli 2 (en fct avance)
3.3 CAN-CNA proto ampli 3 (en fct avance)
4. Connexion µControleur/Carte WIFI
4.1 Assemblage Shield Wifi / µC
4.2 Conception architecture réseau
4.3 Programmation Arduino / Wifi
5 Connexion WIFI / Teléléphone
5.1 Développement IHM Basique
5.2 Développement prog Module Com / Test transmit
6. Signal Audio WIFI/Tel
6.1 Dev Widget Signal (Graph)
6.2 CAN CAN Tel
7. Appli Téléphone
7.1 Dev Sortie son / Casque
7.2 Dev Stockage/Enregistrement (en fct avance)
7.3 Dev IHM Avancée (en fct avance)
II. Avancement du projet :
Etapes en cours : 1 et 2 |  |  |  | Tâches de la période du 5 au : 9
Tâches | Prévues |  | Réalisées |  | Résultats |  | Evaluation |  | Suite à prévoir
1.1.3 Cadrage Projet | x |  | x
1.2 Vtech Programmes / Matériel | x |  | x
2.1.1 #36 relevé son |  | x |  |  | Relevé des signaux en sortie
2.1.2 #37 Analyse/Etude Signal |  | x |  | x | Caractérisation du signal
2.2.1 #38 Conception Ampli (ORcad) |  | x |  | x | Développement du circuit d'ampli
2.2.2 #39 Simulation Circuit (Orcad) |  | x |  | x | Simulation de l'ampli proto
2.3.1 #40 Appro Matériel |  | x |  | x | Matériel approvisionné chez E44 |  | Ampli OP non optimisé mais Ok pour essais |  | Appro d'un nouvel Ampli OP Rail to rail optimisé pour fonction
2.3.2 #41 Assemblage |  | x |  | x
2.4.1 #42 Simu Proto1 |  | x |  | x
2.4.2 #43 Simu Proto2 |  | x |  | x |  |  |  |  | Tache commencée mais non terminée
3.1.1 #46 Conception Logiciel Arduino 12Bits |  | x |  |  |  |  |  |  | Tache commencée mais non terminée
3.1.2 #47 Fab Ampli1 (amp+Ard+Hp) |  | x
4.1.1 #53 Brochage Shield Wifi ( Etude) |  | x
Commentaires :
Analyse du travail réalisé : | Avancement correct sur la semaine passée, les taches sont réalisées en binomes , mais une réunion de cadrage réalisée Jeudi dernier permettra de répartir les taches pour un avancement en parallèle
Explication des écarts prévu/réalisé : | Nécessité d'apprentissages très larges : Electronique, Programmation Arduino
Initiatives prises : arbitrages, choix, parti pris : | Choix d'un avancement par la méthode Agile. Nous avançons en cercles concentriques retranscrits dans le nouveau cadrage
Contraintes à respecter prévues ou non prévues : | L'approvisionnement du matériel nous a fait perdre du temps : Nous avons recourru à un fournisseur local pour pallier à l'absence de matériel disponible à l'IUT
Méthodes appliquées : | AGILE
Difficultés rencontrées surmontées ou non : | Connaissances en electronique, programmation arduino encore limitées
Conséquences de l'avancement sur le respect des délais, l'atteinte des objectifs : |  |  | Nous intégrons dans les délais de chaque étapes des temps d'apprentissage et de veille technologique
III. Prévisions d'activité
semaine suivante / cycle suivant : S49
Etape concernée: fin étape 2 + étapes 3 et 4
tâches | Contenu prévu |  |  | Résultat à atteindre |  |  |  | Points critiques identifiés
3.1.1 #46 Conception Logiciel Arduino 12 Bits | Développement de logiciel |  |  | Numériser le signal AN et le transmettre au module WIFI |  |  |  | Apprentissage langage care Arduino
3.1.2 #47 Fab Ampli1 (amp+Ard+Hp) | Prototypage |  |  | Tester logiciel Arduino pour transmission du son
3.1.3 #48 Simulation Ampli 1 | Essais |  |  | Tester logiciel Arduino pour transmission du son
4.1.1 #53 Brochage Shield Wifi ( Etude) | Développement de logiciel |  |  | Configurer le module WIFI pour transmission du son |  |  |  |  | Apprentissage du WIFI
4.1.2 #54 Soudures Shield Wifi | Prototypage |  |  | Assemblege du module WIFI sur carte Arduino
4.2.1 #55 Definition Mode de connexion | Etude réseau |  |  | Developper le réseau WIFI
4.2.2 #56 @ip/DHCP | Etude réseau |  |  | Developper le réseau WIFI
4.2.3 #57 Definition Port com (>1023) | Développement de logiciel |  |  | Développer le réseau WIFI
4.3.1 #58 Prog Mode Connexion | Développement de logiciel |  |  | Développer le programme Arduino pour la transmission
4.3.2 #59 Transmission Data uC/Carte | Développement de logiciel |  |  | Développer le programme Arduino pour la transmission
IV. Conclusion
Faits marquants de la période : Prototype d'amplificateur fonctionne et adapté à nos besoins, et recadadrage « AGile » du projet qui nous permet d'y voir plus clair sur le reste des tâches à faire
Incidence des résultats sur le projet : meilleure répartition du travail à venir
