th3fr33man/jendrix/Rapports/backlog.ods

Sheet: Feuille1
Sprint | Planning initial | taches | poids
 | 1 | Lancement
 | 1.1 | Organisation
 | 1.1.1 | #35 Creation CdC
 | 1.1.2 | #3 Validation CdC tuteur
 | 1.1.3 | #2 Cadrage
 | 1.1.4 | #28 Ajout des premières tâches dans github
 | 1.1.5 | #1 Renseigner outils de suivi
 | 1.2 | VTech
 | 1.2.1 | #30 Identification interface guitare
 | 1.2.2 | #29 Identifier les diverses modules sans fil
 | 1.2.3 | #5 Recherche modules adaptables
 | 1.2.4 | #4 Listing applis et matériels existant sur même theme
 | 1.2.5 | #31 Etuge de la gestion énergétique
 | 1.3 | Appro
 | 1.3.1 | #14 Achat / Acquisition
 | 1.3.2 | #12 Financement / Validation
 | 1.3.3 | #11 Définition des besoins matériels
 | 2 | Recup Signal
 | 2.1 | Etude Signal
 | 2.1.1 | #36 Relevé
 | 2.1.2 | #37 Analyse/Etude Signal
 | 2.2 | Etude Ampli
 | 2.2.1 | #38 Conception Ampli (ORcad)
 | 2.2.2 | #39 Simulation Circuit (Orcad)
 | 2.3 | Fabrication Proto1
 | 2.3.1 | #40 Appro Matos
 | 2.3.2 | #41 Assemblage
 | 2.4 | Valid Recup Signal
 | 2.4.1 | #42 Simu Proto1
 | 2.4.2 | #43 Simu Proto2
 | 2.5 | Fabrication Proto2
 | 2.5.1 | #44 Dessin Typon
 | 2.5.2 | #45 Appro/Fab C.I
 | 2.6 | Phase 3
 | 3 | Numerisation Signal
 | 3.1 | CAN - CNA Ampli1
 | 3.1.1 | #46 Conception Logiciel Arduino 12B
 | 3.1.2 | #47 Fab Ampli1 (amp+Ard+Hp)
 | 3.1.3 | #48 Simulation Ampli1
 | 3.2 | CAN - CNA Ampli2
 | 3.2.1 | #49 Fab Ampli2 - Aop RtoR
 | 3.2.2 | #50 Simulation Ampli2
 | 3.3 | CAN - CNA Ampli3
 | 3.3.1 | #51 Conception Logiciel Arduino 24B
 | 3.3.2 | #52 Simulation Ampli3
 | 4 | Connexion Wifi/uC
 | 4.1 | Assemblage Shield Wifi
 | 4.1.1 | #53 Brochage Shield Wifi
 | 4.1.2 | #54 Soudures Shield Wifi
 | 4.2 | Arch Reseau
 | 4.2.1 | #55 Definition Mode de connexion
 | 4.2.2 | #56 @ip/DHCP
 | 4.2.3 | #57 Definition Port com (>1023)
 | 4.2.4 | #60 Réalisation schéma réseau
 | 4.2.5 | #73 Utilisation nc - com pc1/pc2 filaire
 | 4.2.6 | #74 Utilisation nc - com pc1/pc2 wifi
 | 4.2.7 | #75 Utilisation nc - com moduleWifly/pc
 | 4.3 | Programmation Arduino DUE
 | 4.3.1 | #58 Prog Mode Connexion
 | 4.3.2 | #59 Transmission Data uC/Carte
 | 5 | Appli Tel/ Fonction connexion Wifi/Tel
 | 5.1 | Dev IHM de Base
 | 5.1.1 | #66 Définition des besoins
 | 5.1.2 | #67 mockup
 | 5.2 | Dev Module Com/Tester Transmission
 | 5.2.1 | #64 Création vue config réseau
 | 5.2.2 | #65 Connexion module guitare
 | 6 | Signal Audio Wifi/Tel
 | 6.1 | Validation reception signal Audio
 | 6.1.1 | #61 WidGet Signal(Graph)
 | 6.1.2 | #62 Validation reception en console
 | 6.2 | CNA - CAN Tel
 | 6.2.1 | #63 Son vers Sortie Casque
 | 7 | Appli Tel/ Fonctions supplémentaires
 | 7.1 | Stockage/enregistrement
 | 7.1.1 | #69 Création vue Stockage/enregistrement
 | 7.2 | IHM Avancee
 | 7.2.1 | #68 Définition des besoins des fonctions sup
 | 8 | Conception Appli Tel
 | 8.1 | Conception UML
 | 8.1.1 | #70 Diagramme cas d'utilisation
 | 8.1.2 | #71 Diagramme séquence/activité
 | 8.1.3 | #72 Diagramme de classe

Sheet: backlog général_2
 | Sprint ? | taches | poids
Sprint 1 | 1.1.1 | #35 Creation CdC | 3
Sprint 1 | 1.1.2 | #3 Validation CdC tuteur | 1
Sprint 1 | 1.1.3 | #2 Cadrage | 2
Sprint 1 | 1.1.4 | #28 Ajout des premières tâches dans github | 2
Sprint 1 | 1.1.5 | #1 Renseigner outils de suivi | 1
Sprint 1 | 1.2.1 | #30 Identification interface guitare | 2
Sprint 1 | 1.2.2 | #29 Identifier les diverses modules sans fil | 1
Sprint 1 | 1.2.3 | #5 Recherche modules adaptables | 1
Sprint 1 | 1.2.4 | #4 Listing applis et matériels existant sur même theme | 1
Sprint 2 | 1.2.5 | #31 Etuge de la gestion énergétique | 5
Sprint 2 | 1.3.1 | #14 Achat / Acquisition | 1
Sprint 2 | 1.3.2 | #12 Financement / Validation | 1
Sprint 1 | 1.3.3 | #11 Définition des besoins matériels | 2
Sprint 1 | 2.1.1 | #36 Relevé | 2
Sprint 1 | 2.1.2 | #37 Analyse/Etude Signal | 2
Sprint 2 | 2.2.1 | #38 Conception Ampli (ORcad) | 3
Sprint 2 | 2.2.2 | #39 Simulation Circuit (Orcad) | 3
Sprint 2 | 2.3.1 | #40 Appro Matos | 1
Sprint 2 | 2.3.2 | #41 Assemblage | 3
Sprint 2 | 2.4.1 | #42 Simu Proto1 | 5
 | 2.4.2 | #43 Simu Proto2 | 5
 | 2.5.1 | #44 Dessin Typon | 8
 | 2.5.2 | #45 Appro/Fab C.I | 8
 | 3.1.1 | #46 Conception Logiciel Arduino 12B | 5
Sprint 2 | 3.1.2 | #47 Fab Ampli1 (amp+Ard+Hp) | 5
Sprint 2 | 3.1.3 | #48 Simulation Ampli1 | 3
 | 3.2.1 | #49 Fab Ampli2 - Aop RtoR | 3
 | 3.2.2 | #50 Simulation Ampli2 | 3
 | 3.3.1 | #51 Conception Logiciel Arduino 24B | 8
 | 3.3.2 | #52 Simulation Ampli3 | 8
Sprint 2 | 4.1.1 | #53 Brochage Shield Wifi | 3
Sprint 2 | 4.1.2 | #54 Soudures Shield Wifi | 3
Sprint 3 | 4.2.1 | #55 Definition Mode de connexion | 3
Sprint 3 | 4.2.2 | #56 @ip/DHCP | 3
Sprint 3 | 4.2.3 | #57 Definition Port com (>1023) | 1
Sprint 3 | 4.2.4 | #60 Réalisation schéma réseau | 2
Sprint 2 | 4.2.5 | #73 Utilisation nc - com pc1/pc2 filaire | 2
Sprint 2 | 4.2.6 | #74 Utilisation nc - com pc1/pc2 wifi | 2
Sprint 3 | 4.2.7 | #75 Utilisation nc - com moduleWifly/pc | 3
Sprint 3 | 4.3.1 | #58 Prog Mode Connexion | 5
Sprint 3 | 4.3.2 | #59 Transmission Data uC/Carte | 5
Sprint 3 | 5.1.1 | #66 Définition des besoins appli smart | 2
Sprint 3 | 5.1.2 | #67 mockup | 3
Sprint 4 | 5.2.1 | #64 Création vue config réseau | 5
Sprint 3 | 5.2.2 | #65 Connexion module guitare | 8
Sprint 4 | 6.1.1 | #61 WidGet Signal(Graph) | 8
Sprint 3 | 6.1.2 | #62 Validation reception en console | 8
Sprint 4 | 6.2.1 | #63 Son vers Sortie Casque | 8
Sprint 4 | 7.1.1 | #69 Création vue Stockage/enregistrement | 8
Sprint 4 | 7.2.2 | IHM Avancee | 5
Sprint 4 | 7.2.1 | #68 Définition des besoins des fonctions sup | 3
Sprint 3 | 8.1.4 | Conception UML | 3
Sprint 3 | 8.1.1 | #70 Diagramme cas d'utilisation | 3
Sprint 3 | 8.1.2 | #71 Diagramme séquence/activité | 3
Sprint 3 | 8.1.3 | #72 Diagramme de classe | 3
Sprint 4 |  | Rédaction rapport | 3
Sprint 3 |  | apprentissage nouveau module wifi | 5
 |  |  | 208

Sheet: backlog général
 | Tâches | poids | Total Sprint
1.1.1 | #35 Creation CdC | 3 | Sprint 1
1.1.2 | #3 Validation CdC tuteur | 1 | Sprint 1
1.1.3 | #2 Cadrage | 2 | Sprint 1
1.1.4 | #28 Ajout des premières tâches dans github | 2 | Sprint 1
1.1.5 | #1 Renseigner outils de suivi | 1 | Sprint 1
1.2.1 | #30 Identification interface guitare | 2 | Sprint 1
1.2.2 | #29 Identifier les diverses modules sans fil | 1 | Sprint 1
1.2.3 | #5 Recherche modules adaptables | 1 | Sprint 1
1.2.4 | #4 Listing applis et matériels existant sur même theme | 1 | Sprint 1
1.3.3 | #11 Définition des besoins matériels | 2 | Sprint 1
2.1.1 | #36 Relevé | 2 | Sprint 1
2.1.2 | #37 Analyse/Etude Signal | 2 | Sprint 1
1.3.1 | #14 Achat / Acquisition | 1 | Sprint 2
1.3.2 | #12 Financement / Validation | 1 | Sprint 2
2.2.1 | #38 Conception Ampli (ORcad) | 3 | Sprint 2
2.2.2 | #39 Simulation Circuit (Orcad) | 3 | Sprint 2
2.3.1 | #40 Appro Matos | 1 | Sprint 2
2.3.2 | #41 Assemblage | 3 | Sprint 2
2.4.1 | #42 Simu Proto1 | 5 | Sprint 2
3.1.2 | #47 Fab Ampli1 (amp+Ard+Hp) | 5 | Sprint 2
3.1.3 | #48 Simulation Ampli1 | 3 | Sprint 2
4.1.1 | #53 Brochage Shield Wifi | 3 | Sprint 2
4.1.2 | #54 Soudures Shield Wifi | 3 | Sprint 2
4.2.5 | #73 Utilisation nc - com pc1/pc2 filaire | 2 | Sprint 2
4.2.6 | #74 Utilisation nc - com pc1/pc2 wifi | 2 | Sprint 2
4.2.2 | #56 @ip/DHCP | 3 | Sprint 3
4.2.3 | #57 Definition Port com (>1023) | 1 | Sprint 3
4.2.4 | #60 Diagramme de déploiement | 2 | Sprint 3
4.2.7 | #75 Utilisation nc - com moduleWifly/pc | 3 | Sprint 3
8.1.1 | #70 Diagramme cas d'utilisation | 3 | Sprint 3
 | #78 apprentissage nouveau module wifi | 8 | Sprint 3
 | #85 Création class diffusion. | 8 | Sprint 4
 | #55 Definition Mode de connexion | 3 | Sprint 4
 | #63 Son vers Sortie Casque | 8 | Sprint 4
 | #66 Définition des besoins apli smart | 2 | Sprint 4
 | #67 création mockup | 3 | Sprint 4
 | #65 Connexion module guitare | 8 | Sprint 4
 | #62 Validation reception en console | 5 | Sprint 4
 | #80 affichage toast pour chaque bouton. | 8 | Sprint 4
 | #71 Diagramme séquence | 3 | Sprint 4
 | #72 Diagramme de classe | 3 | Sprint 4 |  | points restant | Sprints | Réalisé | Théorique
 | #77 Envoi texte vers rs232 | 8 | Sprint 4 |  | 262 | 0 | 0 | 0
 | #79 Envoi vers rs 232 échantillonnage sur 8bits | 8 | Sprint 4 | Sprint 1 | 246 | 1 | 16 | 52,4
 | #81 création class écoute(socket si tcp). | 8 | Sprint 4 | Sprint 2 | 211 | 2 | 51 | 104,8
 | #82 affichage texte en provenance arduino dans log. | 8 | Sprint 4 | Sprint 3 | 191 | 3 | 71 | 157,2
 | #88 Installer SDK Andoird + Eclipse | 3 | Sprint 4 | Sprint 4 | 70 | 4 | 192 | 209,6
 | #89 Apprentissage Android | 5 | Sprint 4 | Sprint 5 | 59 | 5 | 203 | 262
 | #90 Affichage texte en provenance wifi sur fenêtre log appli Android | 8 | Sprint 4
 | #91 Création montage max232 | 8 | Sprint 4
 | #92 Mise au propre montage max232 | 1 | Sprint 4
 | #93 Création fonction configuration Arduino DPAC | 5 | Sprint 4
 | #94 Réception échantillons audio en mode console | 3 | Sprint 4
 | #95 Mise en place horloge échantillonnage arduino | 5 | Sprint 4
5.2.1 | #64 Création vue config réseau | 5 | Sprint 5
6.1.1 | #61 WidGet Signal(Graph) | 8 | Sprint 5
7.1.1 | #69 Création vue Stockage/enregistrement | 8 | Sprint 5
7.2.2 | #96 mockup IHM avancée | 5 | Sprint 5
7.2.1 | #68 Définition des besoins des fonctions sup | 3 | Sprint 5
 | #96 Rédaction rapport | 3 | Sprint 5
 | #31 Etuge de la gestion énergétique | 8 | Sprint 5
 | #83 Modification AOP RtoR | 1 | Sprint 5
 | #86 Création class traitement signal(data 8bits vers 12bits). | 8 | Sprint 5
 | #87 Résoudre problèmatique de l'horloge Arduino/Android | 8 | Sprint 5
 | #84 Achat antenne pour dpac | 1 | Sprint 5
 | #76 Fonction échantillonnage 12bit vers 2x8bits. | 8 | Sprint 5
 | Total points | 262
 |  |  |  |  | Sprint 1 | Veille technologique et définition du cahier des charges
 |  |  |  |  | Sprint 2 | Etude de l’architecture système et prise en main du matériel
 |  |  |  |  | Sprint 3 | Mise en œuvre des fonctions « Audio » de l'Arduino et prise en main du module WIFLY
 |  |  |  |  | Sprint 4 | Mise en œuvre des fonction « Audio » de l'Arduino, prise en main du module WIFI DPAC et programmation Anrdoid
 |  |  |  |  | Sprint 5 | Amélioration 1ère phase

Sheet: Sprint 1
SPRINT 1
 | Tâches | poids | 1 | 2 | 3 | 4 | 5 | 6 | 7 | 8 | 9 | 10 | 11 | 12 | 13 | 14 | sprint result
1.1.1 | #35 Creation CdC | 3 |  |  |  |  |  |  |  |  |  | X | X | X | X | X | 0
1.1.2 | #3 Validation CdC tuteur | 1 |  |  |  |  |  |  |  |  |  |  |  |  |  |  | 0
1.1.3 | #2 Cadrage | 2 | X |  |  |  |  |  |  |  |  |  |  |  |  |  | 2
1.1.4 | #28 Ajout des premières tâches dans github | 2 |  | X |  |  |  |  |  |  |  |  |  |  |  |  | 2
1.1.5 | #1 Renseigner outils de suivi | 1 |  | X |  |  |  |  |  |  |  |  |  |  |  |  | 1
1.2.1 | #30 Identification interface guitare | 2 |  |  | X |  |  |  |  |  |  |  |  |  |  |  | 2
1.2.2 | #29 Identifier les diverses modules sans fil | 1 |  |  | X |  |  |  |  |  |  |  |  |  |  |  | 1
1.2.3 | #5 Recherche modules adaptables | 1 |  |  | X |  |  |  |  |  |  |  |  |  |  |  | 1
1.2.4 | #4 Listing applis et matériels existant sur même theme | 1 |  |  |  | X |  |  |  |  |  |  |  |  |  |  | 1
1.3.3 | #11 Définition des besoins matériels | 2 |  |  |  | X | X | X |  |  |  |  |  |  |  |  | 2
2.1.1 | #36 Relevé | 2 |  |  |  |  |  |  | X |  |  |  |  |  |  |  | 2
2.1.2 | #37 Analyse/Etude Signal | 2 |  |  |  |  |  |  |  | X | X |  |  |  |  |  | 2
 | Objectif | 20 |  |  |  |  |  |  |  |  |  |  |  |  |  | Total réalisé | 16
 |  |  |  |  |  |  |  |  |  |  |  |  |  |  |  | % Réalisé | 80%
 |  |  |  |  |  |  |  |  |  |  |  |  |  |  |  | Avancement / total | 6,11%
 |  |  |  |  |  |  |  |  |  |  |  |  |  |  |  | TOTAL PROJET | 262

Sheet: Sprint 2
SPRINT 2
 | Tâches |  | 1 | 2 | 3 | 4 | 5 | 6 | 7 | 8 | 9 | 10 | 11 | 12 | 13 | 14 | sprint result
1.3.1 | #14 Achat / Acquisition | 1 |  |  |  |  |  |  |  |  |  |  |  |  | X | X | 1
1.3.2 | #12 Financement / Validation | 1 | X |  |  |  |  |  |  |  |  |  |  |  |  |  | 1
2.2.1 | #38 Conception Ampli (ORcad) | 3 |  | X |  |  |  |  |  |  |  |  |  |  |  |  | 3
2.2.2 | #39 Simulation Circuit (Orcad) | 3 |  | X |  |  |  |  |  |  |  |  |  |  |  |  | 3
2.3.1 | #40 Appro Matos | 1 |  |  |  |  |  |  |  |  |  |  |  |  |  |  | 1
2.3.2 | #41 Assemblage | 3 |  |  |  |  |  | X |  |  |  |  |  |  |  |  | 3
2.4.1 | #42 Simu Proto1 | 5 |  |  | X |  |  |  |  |  |  |  |  |  |  |  | 5
3.1.2 | #47 Fab Ampli1 (amp+Ard+Hp) | 5 |  |  |  |  | X |  |  |  |  |  |  |  |  |  | 5
3.1.3 | #48 Simulation Ampli1 | 3 |  |  |  | X |  |  |  |  |  |  |  |  |  |  | 3
4.1.1 | #53 Brochage Shield Wifi | 3 |  |  |  |  |  |  |  |  |  |  |  | X |  |  | 3
4.1.2 | #54 Soudures Shield Wifi | 3 |  |  |  |  |  |  |  |  |  |  |  | X |  |  | 3
4.2.5 | #73 Utilisation nc - com pc1/pc2 filaire | 2 |  |  |  |  |  |  |  |  |  |  |  |  |  | X | 2
4.2.6 | #74 Utilisation nc - com pc1/pc2 wifi | 2 |  |  |  |  |  |  |  |  |  |  |  |  |  | X | 2
 | Objectif | 35 |  |  |  |  |  |  |  |  |  |  |  |  |  | Total réalisé | 35
 |  |  |  |  |  |  |  |  |  |  |  |  |  |  |  | % Réalisé | 100%
 |  |  |  |  |  |  |  |  |  |  |  |  |  |  |  | Avancement / total | 13,36%
 |  |  |  |  |  |  |  |  |  |  |  |  |  |  |  | TOTAL PROJET | 262

Sheet: Sprint 3
SPRINT 3
 | Tâches | poids | 1 | 2 | 3 | 4 | 5 | 6 | 7 | 8 | 9 | 10 | 11 | 12 | 13 | 14 | sprint result
4.2.2 | #56 @ip/DHCP | 3 |  |  | X |  |  |  |  |  |  |  |  |  |  |  | 3
4.2.3 | #57 Definition Port com (>1023) | 1 |  |  | X |  |  |  |  |  |  |  |  |  |  |  | 1
4.2.4 | #60 Diagramme de déploiement | 2 |  |  | X |  |  |  |  |  |  |  |  |  |  |  | 2
4.2.7 | #75 Utilisation nc - com moduleWifly/pc | 3 |  | X |  |  |  |  |  |  |  |  |  |  |  |  | 3
8.1.1 | #70 Diagramme cas d'utilisation | 3 |  |  | X |  |  |  |  |  |  |  |  |  |  |  | 3
 | #78 apprentissage nouveau module wifi | 8 | X |  |  |  |  |  |  |  |  |  |  |  |  |  | 8 | points restants
 |  | 20 |  |  |  |  |  |  |  |  |  |  |  |  |  |  | 20 | -20

Sheet: Sprint 4
Tâches | poids | 1 | 2 | 3 | 4 | 5 | 6 | 7 | 8 | 9 | 10 | 11 | 12 | 13 | 14 | Sprint result
#85 Création class diffusion. | 8 |  |  |  |  |  |  |  |  |  |  |  |  |  |  | 8
#55 Definition Mode de connexion | 3 |  | X |  |  |  |  |  |  |  |  |  |  |  |  | 3
#63 Son vers Sortie Casque | 8 |  |  |  |  |  |  |  |  |  |  |  |  |  | X | 8
#66 Définition des besoins apli smart | 2 |  |  |  |  | X |  |  |  |  |  |  |  |  |  | 2
#67 création mockup | 3 |  |  | X |  |  |  |  |  |  |  |  |  |  |  | 3
#65 Connexion module guitare | 8 |  |  |  |  |  |  |  | X |  |  |  |  |  |  | 8
#62 Validation reception en console | 5 |  | X |  |  |  |  |  |  |  |  |  |  |  |  | 5
#80 affichage toast pour chaque bouton. | 8 |  | X |  |  |  |  |  |  |  |  |  |  |  |  | 8
#71 Diagramme séquence | 3 | X |  |  |  |  |  |  |  |  |  |  |  |  |  | 3
#72 Diagramme de classe | 3 |  |  |  |  |  |  |  |  |  |  |  |  |  | X | 3
#77 Envoi texte vers rs232 | 8 |  |  |  |  | X |  |  |  |  |  |  |  |  |  | 8
#79 Envoi vers rs 232 échantillonnage sur 8bits | 8 |  |  |  |  | X |  |  |  |  |  |  |  |  |  | 8
#81 création class écoute(socket si tcp). | 8 |  |  |  |  |  |  |  |  | X |  |  |  |  |  | 8
#82 affichage texte en provenance arduino dans log. | 8 |  |  |  |  |  |  |  |  |  |  |  |  | X |  | 8
#88 Installer SDK Andoird + Eclipse | 3 | X |  |  |  |  |  |  |  |  |  |  |  |  |  | 3
#89 Apprentissage Android | 5 |  | X |  |  |  |  |  |  |  |  |  |  |  |  | 5
#90 Affichage texte en provenance wifi sur fenêtre log appli Android | 8 |  |  |  |  | X |  |  |  |  |  |  |  |  |  | 8
#91 Création montage max232 | 8 |  |  |  |  |  |  |  |  | X |  |  |  |  |  | 8
#92 Mise au propre montage max232 | 1 |  |  |  |  |  |  |  |  | X |  |  |  |  |  | 1
#93 Création fonction configuration Arduino DPAC | 5 |  |  |  |  | X |  |  |  |  |  |  |  |  |  | 5
#94 Réception échantillons audio en mode console | 3 |  |  |  |  |  |  |  |  |  |  | X |  |  |  | 3
#95 Mise en place horloge échantillonnage arduino | 5 |  |  |  |  |  |  |  |  |  |  |  | X |  |  | 5
 |  |  |  |  |  |  |  |  |  |  |  |  |  |  |  |  | points restants
Total | 121 |  |  |  |  |  |  |  |  |  |  |  |  |  |  | 121 | -141

Sheet: Sprint 5
SPRINT 5
 | Tâches | poids | 1 | 2 | 3 | 4 | 5 | 6 | 7 | 8 | 9 | 10 | 11 | 12 | 13 | 14 | Sprint result
5.2.1 | #64 Création vue config réseau | 5 |  |  |  |  |  |  |  |  |  |  |  |  |  |  | 0
6.1.1 | #61 WidGet Signal(Graph) | 8 |  |  |  |  |  |  |  |  |  |  |  |  |  |  | 0
7.1.1 | #69 Création vue Stockage/enregistrement | 8 |  |  |  |  |  |  |  |  |  |  |  |  |  |  | 0
7.2.2 | mockup IHM avancée | 5 |  |  |  |  |  |  |  |  |  |  |  |  |  |  | 0
7.2.1 | #68 Définition des besoins des fonctions sup | 3 |  |  |  |  |  |  |  |  |  |  |  |  |  |  | 0
 | #96 Rédaction rapport | 3 |  |  |  |  |  |  |  |  |  |  |  |  |  | X | 3
 | #31 Etuge de la gestion énergétique | 8 |  |  |  |  |  |  |  |  |  |  |  |  |  |  | 0
 | #83 Modification AOP RtoR | 1 |  |  |  |  |  |  |  |  |  |  |  |  |  |  | 0
 | #86 Création class traitement signal(data 8bits vers 12bits). | 8 |  |  |  |  |  |  |  |  |  |  |  |  |  |  | 0
 | #87 Résoudre problèmatique de l'horloge Arduino/Android | 8 |  |  |  |  |  |  |  |  |  |  |  |  |  | X | 8
 | #84 Achat antenne pour dpac | 1 |  |  |  |  |  |  |  |  |  |  |  |  |  |  | 0
 | #76 Fonction échantillonnage 12bit vers 2x8bits. | 8 |  |  |  |  |  |  |  |  |  |  |  |  |  |  | 0
 | Objectif | 66 |  |  |  |  |  |  |  |  |  |  |  |  |  | Total réalisé | 11
 |  |  |  |  |  |  |  |  |  |  |  |  |  |  |  | % Réalisé | 17%
