th3fr33man/jendrix/Rapports/Rom/fiche_112012_ReportingLicenceSEICOM2012_13.xls

 |  | Reporting de projet tutoré
 | Nom- prénom : | Raczka Romain |  | Partenaire binôme : |  | Bernoud Florian |  | Date: | Nov 2012
Professeur référent : |  | Olivier Commenge & Philippe Legal |  |  |  |  |  | Commanditaire: |  | Projet perso
Projet : | Conception d'un module de transmission du son sans fil vers une application pour smartphone |  |  |  |  |  |  | Objectifs à atteindre: |  | transmission et diffusion du son en sortie d'une guitare sur le smartphone fonctionnel
Date début : | 2012-11-05 |  | Date fin : | ?
I . Découpage initial du projet:
Etapes | S45 | S48 | S49 | S04 | S05 | S11
1.Organisation
2.Vtech
3.Apprentissage
4.Appro matériel
5.Protoypage matériel
6.Développement logiciel
II. Avancement du projet :
Etape en cours : 1-2-3-4 |  |  |  | Tâches de la période du 5 au : 9
Tâches | Prévues |  | Réalisées |  | Résultats |  | Evaluation |  | Suite à prévoir
Renseigner outils d suivi |  | X |  | X
cadrage |  | X |  | X
Validation Cdc tuteur |  | X |  |  |  |  |  |  | rendez vous le jheudi 15 nomvembre avec Olivier
ajout des taches dans GITHUB |  | X |  | X | Visionnage avancement du projet
Identifier les diverses modules sans fil |  | X |  | X | identification des besoins matériel
Identification interface guitare |  | X |  |  |  |  |  |  | Tache commencée mais non terminée
Etuge de la gestion énergétique |  | X |  |  |  |  |  |  | Tache commencée mais non terminée
Listing applis et matériel existant sur même theme |  | X |  |  |  |  |  |  | Tache commencée mais non terminée
Recherche modules adaptables |  | X |  | X
Prise en main Github |  | X |  | X
Prise en main Eclipse |  | X |  | X
Univers appli android |  | X |  |  |  |  |  |  | Tache commencée mais non terminée
Langage android |  | X |  | X |  |  |  |  | Tache commencée mais non terminée
Electronique |  | X |  |  |  |  |  |  | Tache commencée mais non terminée
WIFI |  | X |  |  |  |  |  |  | Tache commencée mais non terminée
modèle MVC |  | X |  |  |  |  |  |  | Tache commencée mais non terminée
Définition des besoins matériels |  | X |  | X |  |  |  |  | 1er besoin définis
financement / validation |  | X |  |  |  |  |  |  | Finacement perso
Achat / Acquisition |  | X |  | X |  |  |  |  | En attente approvisionnement
Commentaires :
Analyse du travail réalisé: | Avancement correcte apprentissage long et projet démarrant de 0, la plupart des tâches pour cette phase ont été réalisée en binôme
Explication des écarts prévu/réalisé |  | Tatonnement dans les choix matériel pour la réalisation
Initiatives prises : arbitrages, choix, parti pris
Contraintes à respecter prévues ou non prévues
Méthodes appliquées | AGILE
Difficultés rencontrées surmontées ou non ; Connaissances en electronique encore limité, difficulté d'approvisionnement de la carte. Une fois le materiel et le besoin identifié, problème d'appro
Conséquences de l'avancement sur le respect des délais, l'atteinte des objectifs.. |  |  | Pas de date d'appro prévu, voir si possibilité de
III. Prévisions d'activité
semaine suivante / cycle suivant : S48-S49
Etape concernée: fin étape 3 et 4 début 5 et 6
tâches | Contenu prévu |  |  | Résultat à atteindre |  |  |  | Points critiques identifiés
Validation Cdc tuteur |  |  |  | Tâche commencée à terminer
Identification interface guitare |  |  |  | Tâche commencée à terminer
Etuge de la gestion énergétique |  |  |  | Tâche commencée à terminer
Univers appli android |  |  |  | Tâche commencée à terminer
Langage android |  |  |  | Tâche commencée à terminer
Electronique |  |  |  | Tâche commencée à terminer
WIFI |  |  |  | Tâche commencée à terminer
modèle MVC |  |  |  | Tâche commencée à terminer
Définition des besoins matériels |  |  |  | Tâche commencée à terminer
financement / validation |  |  |  | Tâche commencée à terminer
Achat / Acquisition |  |  |  | Tâche commencée à terminer
Etude architecture mat |  |  |  |  |  |  |  | Implique livraison du produit éffectué
Programmation Hard |  |  |  |  |  |  |  | Implique livraison du produit éffectué
Assemblage |  |  |  |  |  |  |  | Implique livraison du produit éffectué
Création IHM basique |  |  |  | Connexion fonctionnelle entre arduino et smartphone
Activity socket serveur |  |  |  | Connexion fonctionnelle entre arduino et smartphone
Activity socket client |  |  |  | Connexion fonctionnelle entre arduino et smartphone
IV. Conclusion
Faits marquants de la période : Démarrage/lancement du projet difficile
Incidence des résultats sur le projet : modification du planning, révision des objectifs
