th3fr33man/jendrix/Documentation/FezPandaArduino/WiFly_Shield-v17.pdf

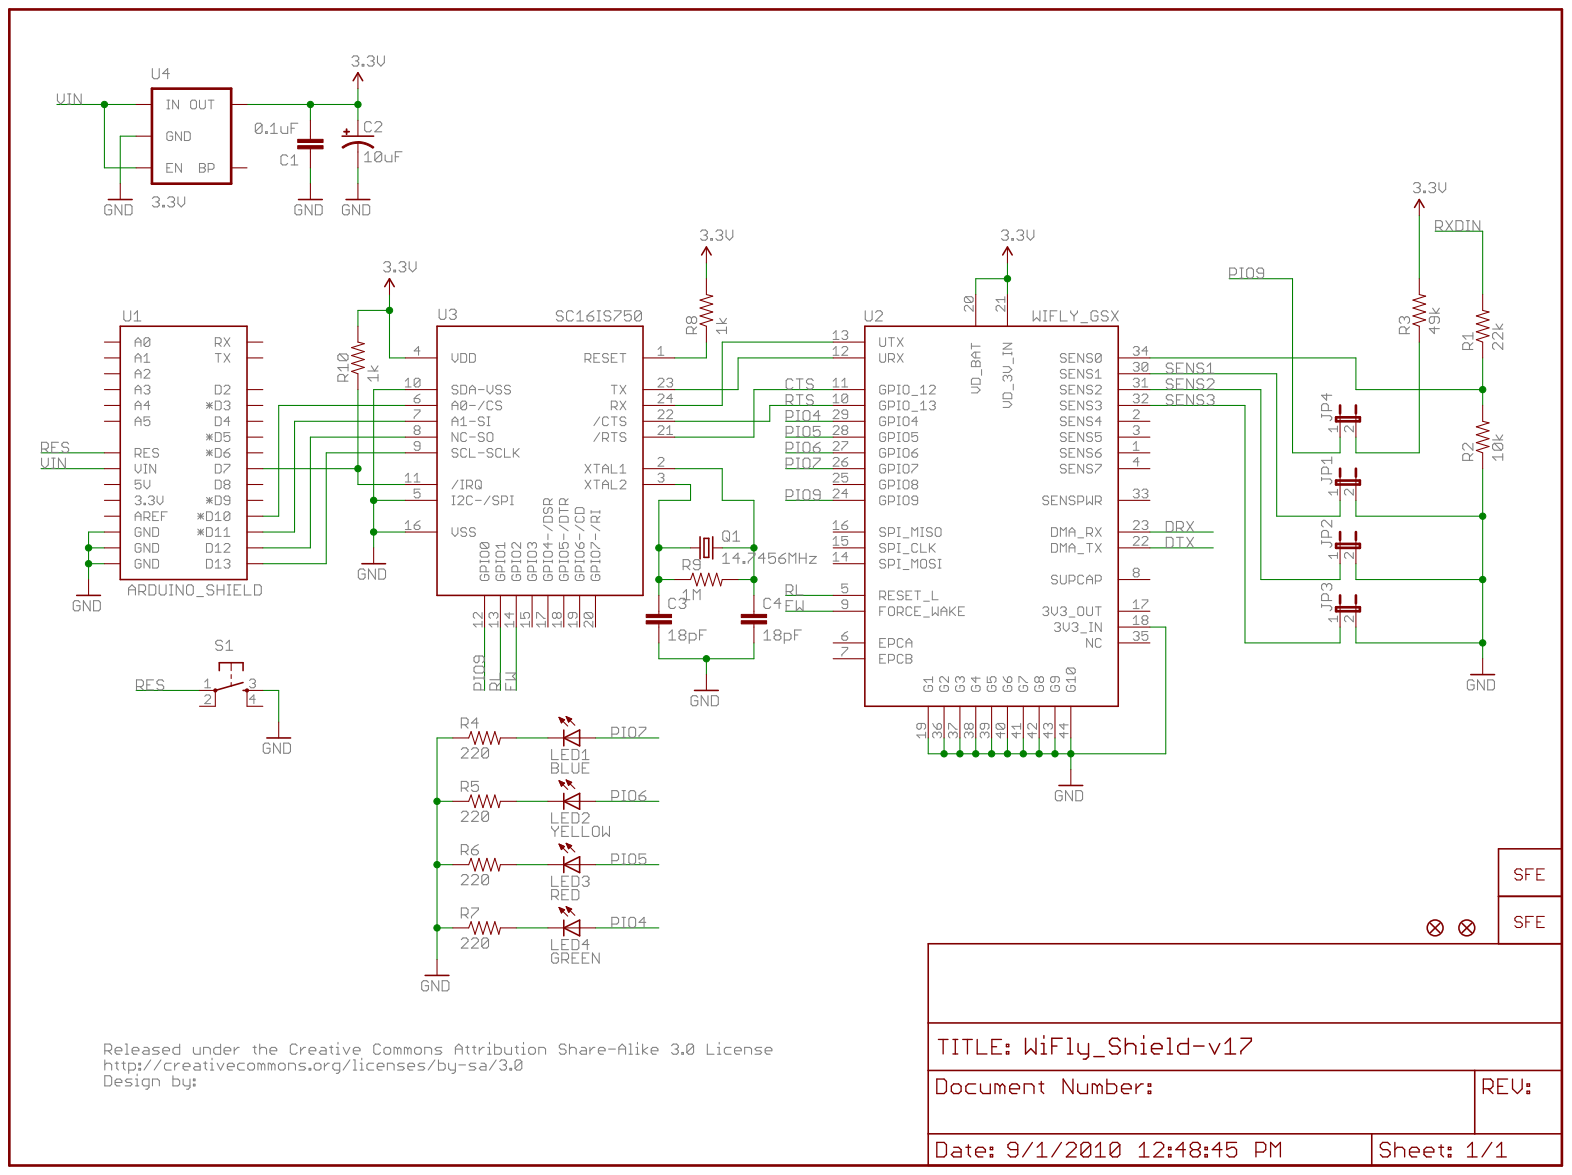
[picture p84: page 1]
