th3fr33man/jendrix/(commit log)

2012-11-05 rajout du fichier excel de reporting du projet
    [fiche reporting licence SEICOM 2008-2009.xls]
2012-11-05 maj du fichier reporting tâches et lien avec github
    [fiche reporting licence SEICOM 2008-2009.xls]
2012-11-17 rajout du premier doc de reporting de novembre
    [fiche_112012_ReportingLicenceSEICOM2012_13.xls]
2012-11-17 rajout du répertoire Documentations, pour stocker les manuels des éléments à l'étude
2012-11-17 rejout fichier backlog(renommage du fichier original)
    [backlog.xls, fiche reporting licence SEICOM 2008-2009.xls]
2012-11-26 rajout du fichier cahier des charges et des imprimes écran du signal capté par l'oscillo, rajout fichier .xmi créé sous umbrello comportant les diagrammes uml
2012-11-28 maj backlog
    [backlog.xls]
2012-11-29 Rajout pinout Arduino Due
2012-11-30 rajout du premier fichier de code arduino
2012-11-30 maj fichier arduino
2012-12-01 rajout rapport Flo
    [Reporting_LP_SEICOM2012_S48_FB.ods]
2012-12-01 rajout reporting s48 Romain
    [Reporting_LP_SEICOM2012_S48_RR.ods]
2012-12-02 maj des fichier reporting Cdc planner et umbrello + maj du sketch arduino
2012-12-04 maj du cahier des charges + planner
2012-12-04 ajout des lib pour Wifly
2012-12-04 rajout sketch arduino wifi et audio
2012-12-05 rajout du sketch arduino son_vers_serial
2012-12-06 rajout du sketch arduino timer write buffer3 - test de mise en place d'un timer pour rentrer les valeurs captées en analogique vers le buffer
2012-12-07 rajout sketch spi et serial + maj planner
2012-12-17 maj sketch arduino utilisant le serial et le spi
2013-01-07 rajout photos shéma fait au tableau
    [Reporting_LP_SEICOM2012_S48_FB.ods]
2013-01-07 mise a jour du sketch arduino avec mise en place du timer et ecriture dans le buffer
2013-01-07 rangement des répertoires + rajout backlogAgile + rajout doc dpac
    [backlog.ods, recapDesTâches.xls]
2013-01-08 maj des fichers supprimés
    [backlog.xls]
2013-01-08 maj backlog et issues sur git
    [backlog.ods]
2013-01-21 maj backlog pour début de sprint 4
    [backlog.ods]
2013-01-21 edit mode opératoire Dpack et ajout du diagramme de séquence dans le fichier UML
2013-01-22 rajout projet appli Android + maj backlog
    [backlog.ods]
2013-01-25 maj projet android
    [backlog.ods]
2013-01-25 save avant création new branch
    [backlog.ods]
2013-01-25 "Ajout de dociuments concernant le DPAC et modification du programme arduino" X
2013-03-06 Rajout projet Android + Timer echantillonnage arduino
2013-03-07 modification dossier.odt + rajout diagramme uml
    [backlog.ods]
2013-03-10 edit dossier + backlog
    [backlog.ods]
2013-03-11 maj dossier rom
    [backlog.ods]
2013-03-12 ajout du ppt de présentation
2013-03-12 maj des présentations
2013-03-12 maj appli android + arduino
2013-03-12 rajout sketch arduino pour test echant 16bits
2013-03-13 mises à jour du rapport de FB
    [Reporting_LP_SEICOM2012_S04_FB.ods]
2013-03-14 mise à jour du doc de flo et ajout de fichiers supports
2013-03-21 edit dossier flo et backlog
    [backlog.ods]
2013-03-24 Partie flo finie, il reste des bricoles pour romain
2013-03-25 deuxième mise à jour
    [backlog.ods]
2013-03-26 edition diapo et fin
    [backlog.ods]
